bigstrongbeast/GnG_Gantul_hill/Чертежи/Гантуловская гора 20х40х2  27-10-2025 061828.pdf

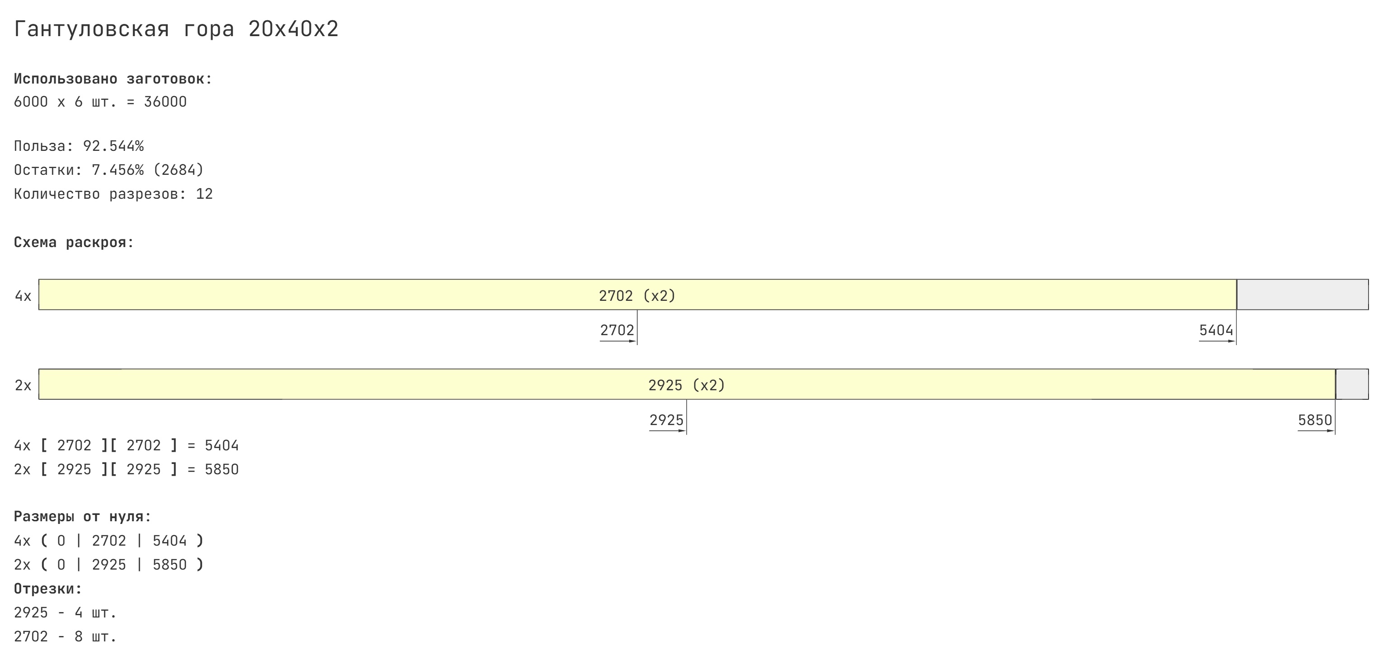
[picture p19: page 1]
