bigstrongbeast/GnG_Gantul_hill/Чертежи/Гантуловская гора 40х40х2 27-10-2025 061539.pdf

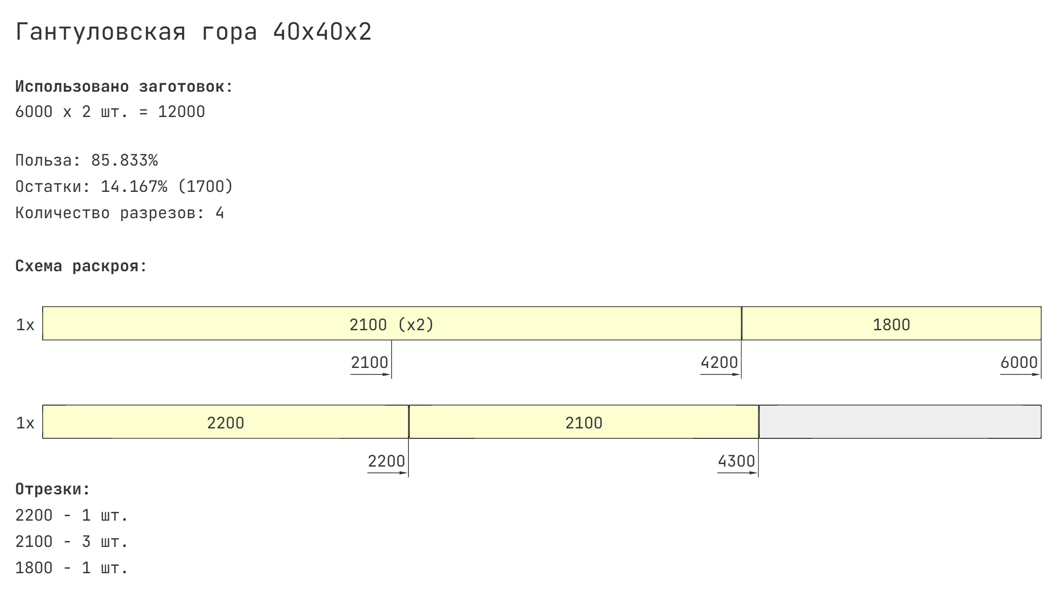
[picture p20: figure]
