bigstrongbeast/GnG_Gantul_hill/Чертежи/Гантуловская гора 80х40х3 27-10-2025 061404.pdf

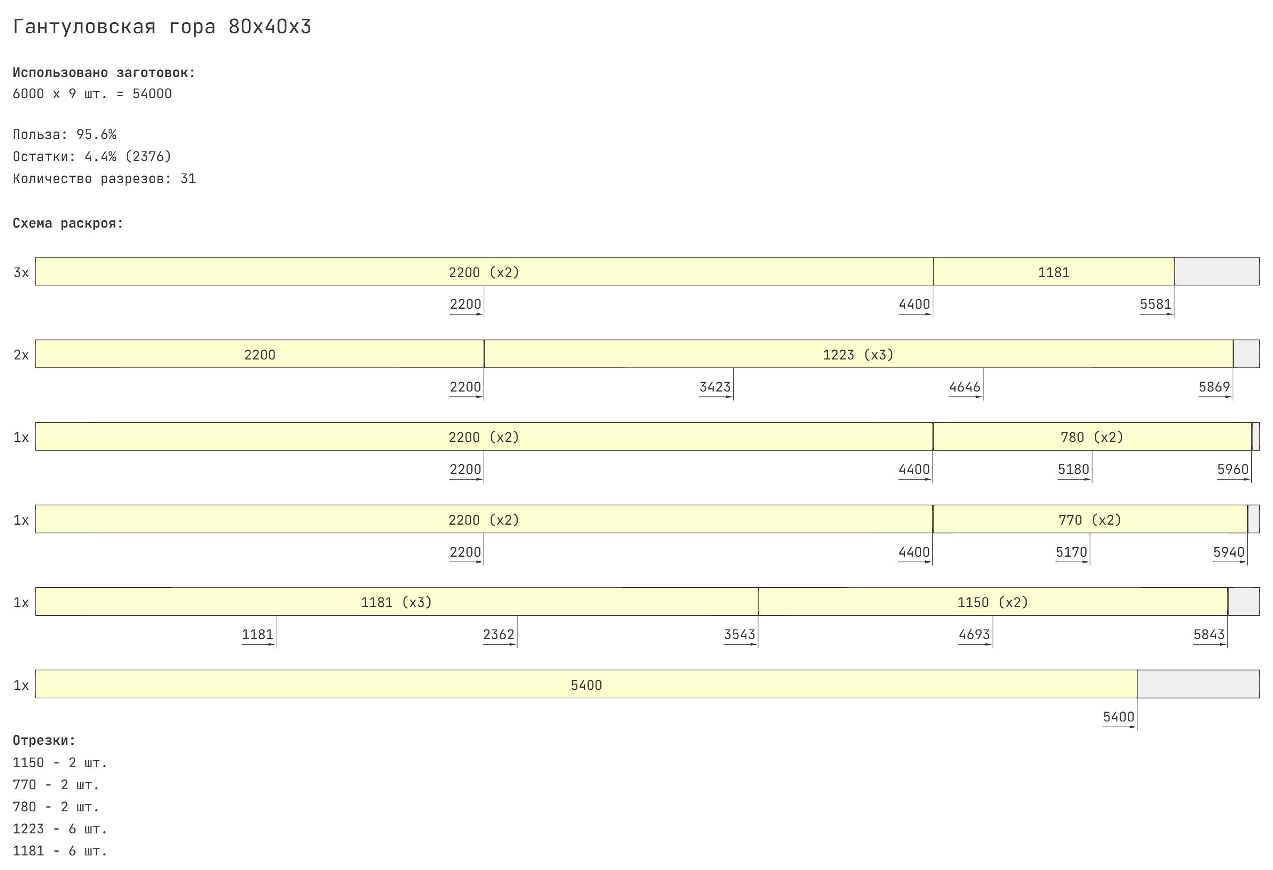
[picture p21: page 1]
