bigstrongbeast/GnG_Gantul_hill/Чертежи/Гантуловская гора 80х80х3 27-10-2025 060937.pdf

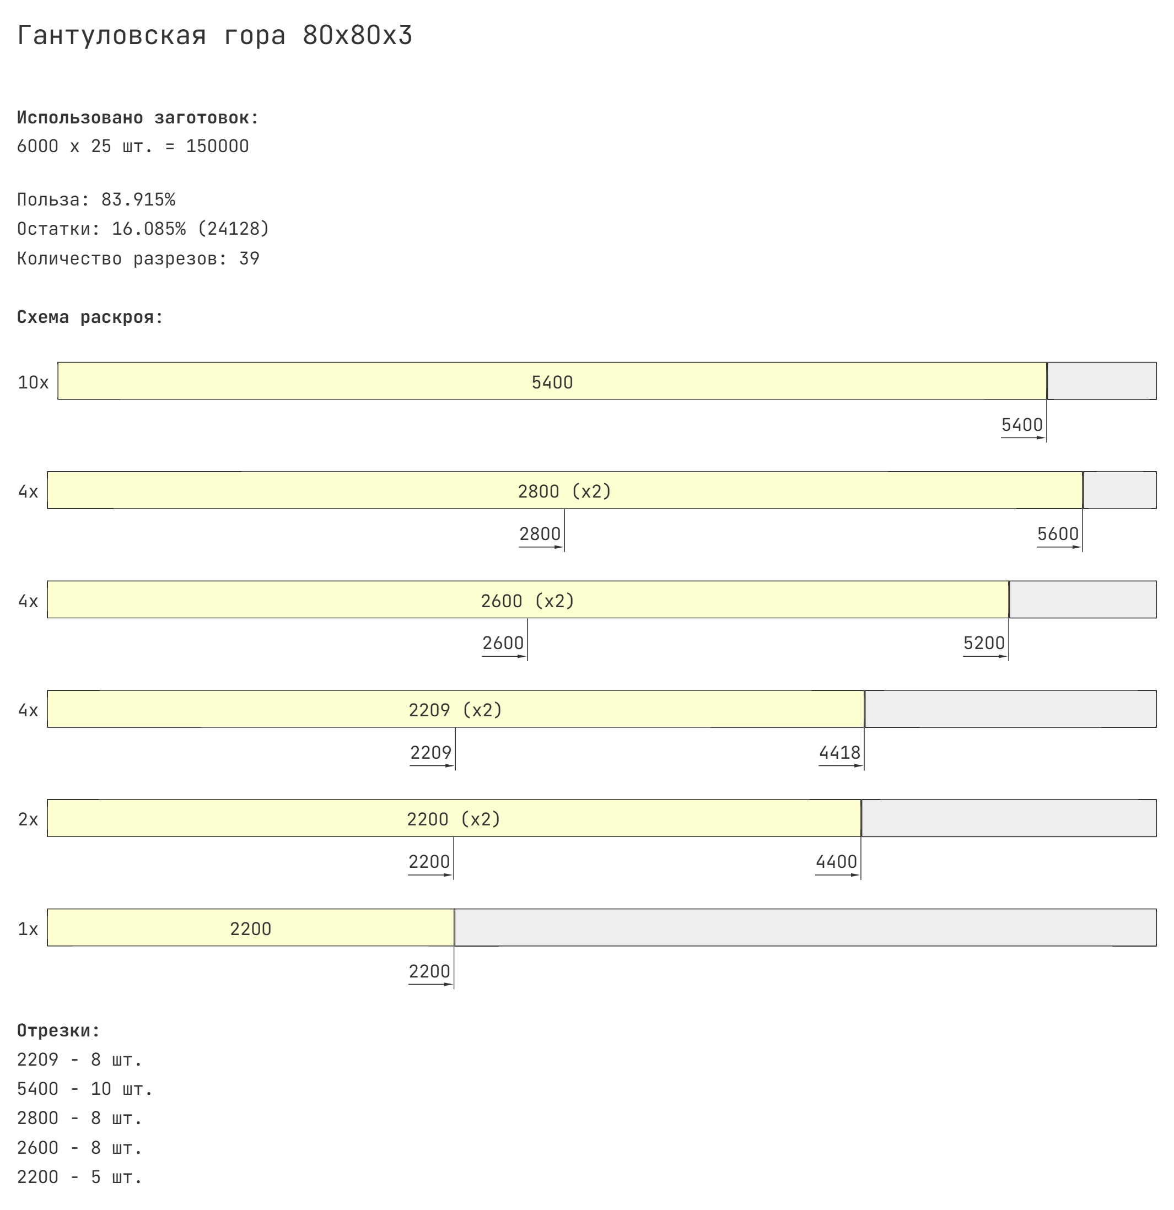
[picture p22: page 1]
