bigstrongbeast/GnG_Gantul_hill/GnG laser/GnG frame 4.2 reinf.dxf

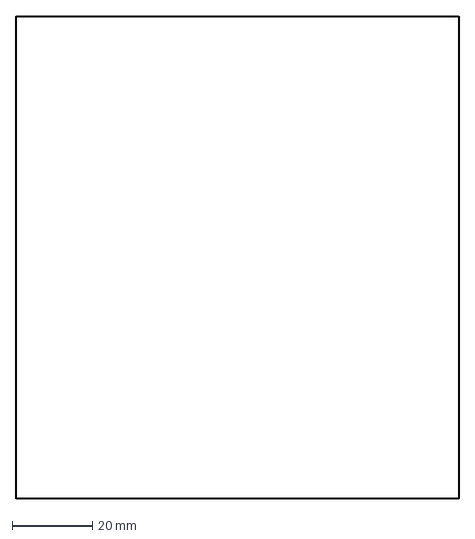
[picture p23: CAD file, 2026-01-20]
GnG laser/GnG frame 4.2 reinf.dxf
110.0 x 120.0 mm
