bigstrongbeast/GnG_Gantul_hill/GnG laser/GnG frame 4.1 D-ring.dxf

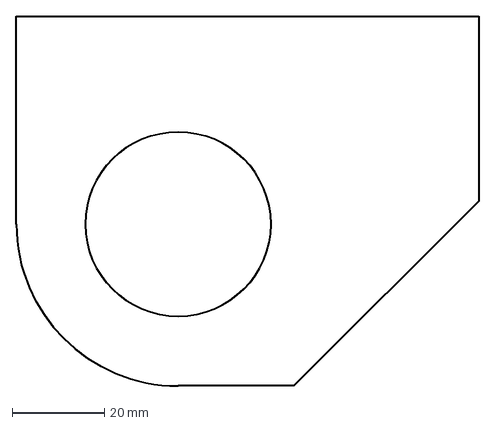
[picture p24: CAD file, 2026-01-20]
GnG laser/GnG frame 4.1 D-ring.dxf
100.0 x 80.0 mm
