bigstrongbeast/GnG_Gantul_hill/GnG laser/GnG frame 2 floor sheet 5.dxf

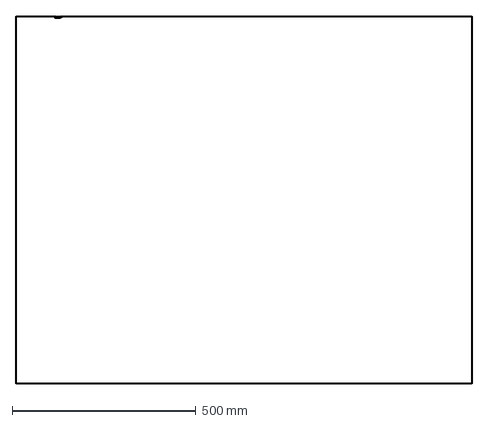
[picture p25: CAD file, 2025-11-07]
GnG laser/GnG frame 2 floor sheet 5.dxf
1240.0 x 1000.0 mm
