bigstrongbeast/GnG_Gantul_hill/GnG laser/GnG frame 2 floor sheet 9.dxf

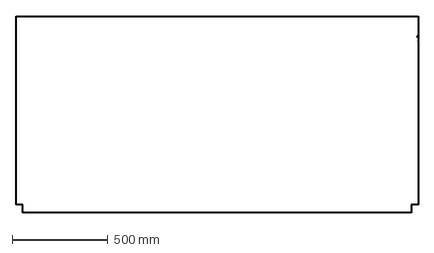
[picture p26: CAD file, 2025-11-07]
GnG laser/GnG frame 2 floor sheet 9.dxf
2100.0 x 1025.0 mm
