bigstrongbeast/GnG_Gantul_hill/GnG laser/GnG frame 2 floor sheet 7.dxf

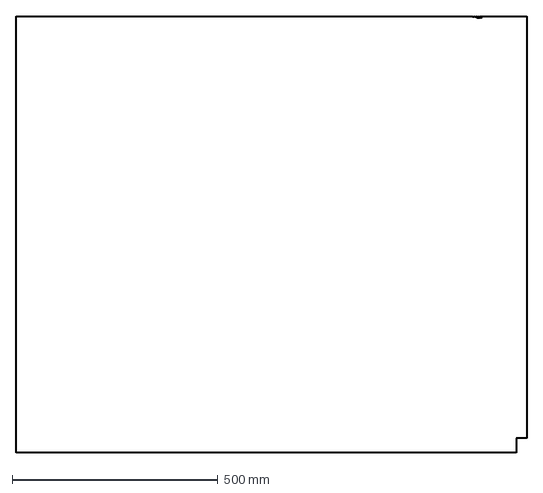
[picture p27: CAD file, 2025-11-07]
GnG laser/GnG frame 2 floor sheet 7.dxf
1240.0 x 1060.0 mm
