bigstrongbeast/GnG_Gantul_hill/GnG laser/GnG frame 2 floor sheet 10.dxf

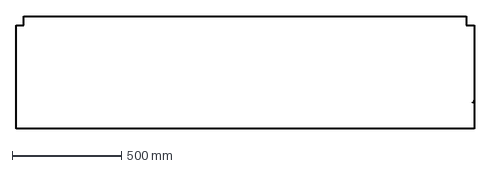
[picture p28: CAD file, 2025-11-07]
GnG laser/GnG frame 2 floor sheet 10.dxf
2100.0 x 515.0 mm
