bigstrongbeast/GnG_Gantul_hill/GnG laser/GnG frame 2 floor sheet 8.dxf

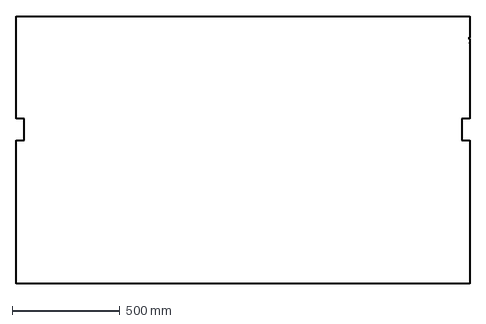
[picture p30: CAD file, 2025-11-07]
GnG laser/GnG frame 2 floor sheet 8.dxf
2100.0 x 1240.0 mm
