bigstrongbeast/GnG_Gantul_hill/GnG laser/GnG frame 1.1 floor sheet 3.dxf

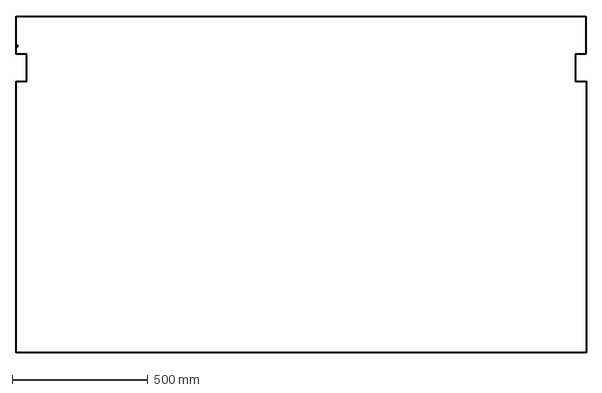
[picture p32: CAD file, 2025-11-06]
GnG laser/GnG frame 1.1 floor sheet 3.dxf
2100.0 x 1240.0 mm
