bigstrongbeast/GnG_Gantul_hill/GnG laser/GnG frame 1.1 floor sheet 5.dxf

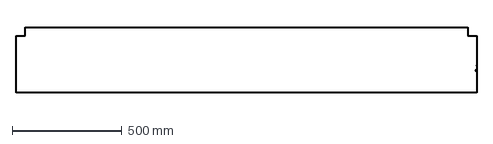
[picture p33: CAD file, 2025-11-06]
GnG laser/GnG frame 1.1 floor sheet 5.dxf
2100.0 x 300.0 mm
