bigstrongbeast/GnG_Gantul_hill/GnG laser/GnG frame 1.1 floor sheet 2.dxf

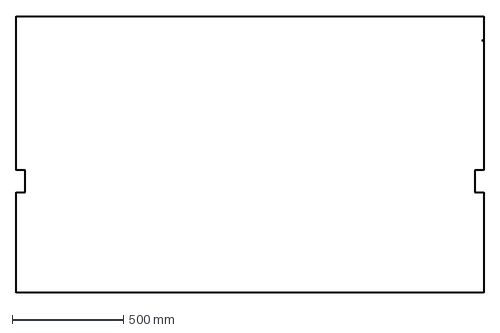
[picture p34: CAD file, 2025-11-06]
GnG laser/GnG frame 1.1 floor sheet 2.dxf
2100.0 x 1240.0 mm
