bigstrongbeast/GnG_Gantul_hill/GnG laser/GnG frame 1.1 floor sheet.dxf

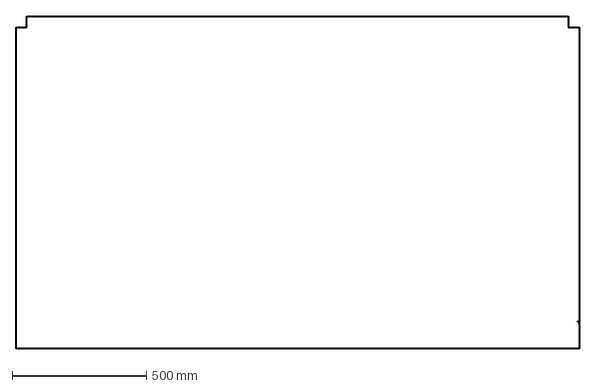
[picture p35: CAD file, 2025-11-06]
GnG laser/GnG frame 1.1 floor sheet.dxf
2100.0 x 1240.0 mm
