bigstrongbeast/GnG_Gantul_hill/(list of files, cad)

Other CAD files:
ref/Стол приёма ГПХ.dwg
Чертежи/DRW GNG Frame_общий.dwg
ref/ТХ_схема Гантуловская гора 18.11.25.dwg
Чертежи/DRW GNG Frame_Рама 1 пол.dwg
ref/Стенды.dwg
Чертежи/DRW GNG Frame_рама_2.dwg
ref/Промежуточный бак.dwg
Чертежи/DRW GNG Frame_рама_3.dwg
ref/Поддон2.dwg
Чертежи/DRW GNG Frame_Рама 1 пол листы.dwg
ref/АСФундамент.dwg
Чертежи/DRW GNG Frame_NDM 4.2 Стрингер домкрат-мама кртк_11.dwg
ref/Рама под насосы.dwg
Чертежи/DRW GNG Frame_торец ворота.dwg
ref/План площадки.dwg
Чертежи/DRW GNG Frame_NDM 4.2 Стрингер домкрат-мама кртк_6.dwg
ref/Разрезы.dwg
Чертежи/DRW GNG Frame_Рама 2 пол.dwg
ref/Граф.часть.dwg
Чертежи/DRW GNG Frame_NDM 4.2 Стрингер домкрат-мама кртк_5.dwg
ref/АС Гатуловской горы.dwg
Чертежи/DRW GNG Frame_Рама 2 пол листы.dwg
ref/Емкость пластик.dwg
ADM10.ipt
AST GnG frame.iam
AST GnG frame/Frame/Frame 1758357581306.iam
AST GnG frame/Frame/ISO 10799-2 100x100x3 1758357583030.ipt
AST GnG frame/Frame/ISO 10799-2 100x100x3 1758357583062.ipt
AST GnG frame/Frame/ISO 10799-2 100x100x3 1758357583095.ipt
AST GnG frame/Frame/ISO 10799-2 100x100x3 1758357583128.ipt
AST GnG frame/Frame/ISO 10799-2 100x100x3 1758357661088.ipt
AST GnG frame/Frame/ISO 10799-2 100x100x3 1760436526769.ipt
AST GnG frame/Frame/Skeleton 1758357581307.ipt
AST GnG frame_Simplify_1.ipt
ASY GnG frame 1.1.iam
ASY GnG frame 1.1/Frame/Frame 1760970953553.iam
ASY GnG frame 1.1/Frame/ISO 10799-2 40x20x2 1760970956320.ipt
ASY GnG frame 1.1/Frame/ISO 10799-2 40x20x2 1760971113347.ipt
ASY GnG frame 1.1/Frame/ISO 10799-2 40x20x2 1761227743922.ipt
ASY GnG frame 1.1/Frame/ISO 10799-2 40x40x2 1762336144290.ipt
ASY GnG frame 1.1/Frame/ISO 10799-2 40x40x2 1762336160774.ipt
ASY GnG frame 1.1/Frame/ISO 10799-2 80x40x3 1760971015255.ipt
ASY GnG frame 1.1/Frame/ISO 10799-2 80x40x3 1760971085509.ipt
ASY GnG frame 1.1/Frame/ISO 10799-2 80x40x3 1760971085542.ipt
ASY GnG frame 1.1/Frame/ISO 10799-2 80x40x3 1760971459705.ipt
ASY GnG frame 1.1/Frame/ISO 10799-2 80x40x3 1760971459737.ipt
ASY GnG frame 1.1/Frame/ISO 10799-2 80x40x3 1760971459769.ipt
ASY GnG frame 1.1/Frame/ISO 10799-2 80x40x3 1760971459801.ipt
ASY GnG frame 1.1/Frame/ISO 10799-2 80x40x3 1760971459834.ipt
ASY GnG frame 1.1/Frame/ISO 10799-2 80x40x3 1760971459866.ipt
ASY GnG frame 1.1/Frame/ISO 10799-2 80x40x3 1761763318402.ipt
ASY GnG frame 1.1/Frame/ISO 10799-2 80x40x3 1761763502600.ipt
ASY GnG frame 1.1/Frame/ISO 10799-2 80x40x3 1761763502641.ipt
ASY GnG frame 1.1/Frame/ISO 10799-2 80x40x3 1761764728104.ipt
ASY GnG frame 1.1/Frame/ISO 10799-2 80x40x3 1761764790187.ipt
ASY GnG frame 1.1/Frame/ISO 10799-2 80x40x3 1761773859418.ipt
ASY GnG frame 1.1/Frame/ISO 10799-2 80x80x3 1760971182147.ipt
ASY GnG frame 1.1/Frame/ISO 10799-2 80x80x3 1760971182176.ipt
ASY GnG frame 1.1/Frame/ISO 10799-2 80x80x3 1760971182205.ipt
ASY GnG frame 1.1/Frame/ISO 10799-2 80x80x3 1760971182233.ipt
ASY GnG frame 1.1/Frame/ISO 10799-2 80x80x3 1760971182263.ipt
ASY GnG frame 1.1/Frame/ISO 10799-2 80x80x3 1761534077124.ipt
ASY GnG frame 1.1/Frame/ISO 10799-2 80x80x3 1761779764411.ipt
ASY GnG frame 1.1/Frame/OldVersions/Frame 1760970953553.0015.iam
ASY GnG frame 1.1/Frame/OldVersions/Frame 1760970953553.0016.iam
ASY GnG frame 1.1/Frame/OldVersions/Frame 1760970953553.0017.iam
ASY GnG frame 1.1/Frame/OldVersions/ISO 10799-2 40x20x2 1760971113347.0007.ipt
ASY GnG frame 1.1/Frame/OldVersions/ISO 10799-2 40x20x2 1760971113347.0008.ipt
ASY GnG frame 1.1/Frame/OldVersions/ISO 10799-2 40x20x2 1760971113347.0009.ipt
ASY GnG frame 1.1/Frame/OldVersions/ISO 10799-2 40x20x2 1761227743922.0006.ipt
ASY GnG frame 1.1/Frame/OldVersions/ISO 10799-2 40x20x2 1761227743922.0007.ipt
ASY GnG frame 1.1/Frame/OldVersions/ISO 10799-2 40x40x2 1762336144290.0001.ipt
ASY GnG frame 1.1/Frame/OldVersions/ISO 10799-2 40x40x2 1762336160774.0001.ipt
ASY GnG frame 1.1/Frame/OldVersions/ISO 10799-2 80x80x3 1760971182147.0005.ipt
ASY GnG frame 1.1/Frame/OldVersions/ISO 10799-2 80x80x3 1760971182147.0006.ipt
ASY GnG frame 1.1/Frame/OldVersions/ISO 10799-2 80x80x3 1760971182147.0007.ipt
ASY GnG frame 1.1/Frame/OldVersions/ISO 10799-2 80x80x3 1760971182233.0005.ipt
ASY GnG frame 1.1/Frame/OldVersions/ISO 10799-2 80x80x3 1760971182233.0006.ipt
ASY GnG frame 1.1/Frame/OldVersions/ISO 10799-2 80x80x3 1760971182233.0007.ipt
ASY GnG frame 1.1/Frame/OldVersions/ISO 10799-2 80x80x3 1760971182263.0005.ipt
ASY GnG frame 1.1/Frame/OldVersions/ISO 10799-2 80x80x3 1760971182263.0006.ipt
ASY GnG frame 1.1/Frame/OldVersions/ISO 10799-2 80x80x3 1760971182263.0007.ipt
ASY GnG frame 1.1/Frame/OldVersions/Skeleton 1760970953554.0015.ipt
ASY GnG frame 1.1/Frame/OldVersions/Skeleton 1760970953554.0016.ipt
ASY GnG frame 1.1/Frame/Skeleton 1760970953554.ipt
ASY GnG frame 1.iam
ASY GnG frame 1/Frame/Frame 1760437627605.iam
ASY GnG frame 1/Frame/ISO 10799-2 100x100x3 1760437628511.ipt
ASY GnG frame 1/Frame/ISO 10799-2 100x100x3 1760437628542.ipt
ASY GnG frame 1/Frame/ISO 10799-2 100x100x3 1760437628572.ipt
ASY GnG frame 1/Frame/ISO 10799-2 100x100x3 1760437628602.ipt
ASY GnG frame 1/Frame/ISO 10799-2 100x100x3 1760437628631.ipt
ASY GnG frame 1/Frame/ISO 10799-2 80x40x3 1760687052574.ipt
ASY GnG frame 1/Frame/ISO 10799-2 80x80x3 1760695196892.ipt
ASY GnG frame 1/Frame/ISO 10799-2 80x80x3 1760695206994.ipt
ASY GnG frame 1/Frame/ISO 10799-2 80x80x3 1760695216389.ipt
ASY GnG frame 1/Frame/ISO 10799-2 80x80x3 1760695230632.ipt
ASY GnG frame 1/Frame/ISO 10799-2 80x80x3 1760869223499.ipt
ASY GnG frame 1/Frame/Skeleton 1760437627606.ipt
ASY GnG frame 2.iam
ASY GnG frame 2/Frame/Frame 1760870485440.iam
ASY GnG frame 2/Frame/ISO 10799-2 40x20x2 1760871003136.ipt
ASY GnG frame 2/Frame/ISO 10799-2 40x20x2 1760871003174.ipt
ASY GnG frame 2/Frame/ISO 10799-2 40x40x2 1760870943673.ipt
ASY GnG frame 2/Frame/ISO 10799-2 40x40x2 1760870950512.ipt
ASY GnG frame 2/Frame/ISO 10799-2 40x40x2 1760870959510.ipt
ASY GnG frame 2/Frame/ISO 10799-2 40x40x2 1760870964721.ipt
ASY GnG frame 2/Frame/ISO 10799-2 40x40x2 1760870971393.ipt
ASY GnG frame 2/Frame/ISO 10799-2 40x40x2 1761689190915.ipt
ASY GnG frame 2/Frame/ISO 10799-2 40x40x2 1762335970766.ipt
ASY GnG frame 2/Frame/ISO 10799-2 40x40x2 1762335989838.ipt
ASY GnG frame 2/Frame/ISO 10799-2 80x40x3 1760870577862.ipt
ASY GnG frame 2/Frame/ISO 10799-2 80x40x3 1760870577894.ipt
ASY GnG frame 2/Frame/ISO 10799-2 80x40x3 1760870585760.ipt
ASY GnG frame 2/Frame/ISO 10799-2 80x40x3 1761227968002.ipt
ASY GnG frame 2/Frame/ISO 10799-2 80x40x3 1761228074502.ipt
ASY GnG frame 2/Frame/ISO 10799-2 80x40x3 1761228074535.ipt
ASY GnG frame 2/Frame/ISO 10799-2 80x40x3 1761686068794.ipt
ASY GnG frame 2/Frame/ISO 10799-2 80x40x3 1761688287802.ipt
ASY GnG frame 2/Frame/ISO 10799-2 80x40x3 1761688287836.ipt
ASY GnG frame 2/Frame/ISO 10799-2 80x40x3 1761689128729.ipt
ASY GnG frame 2/Frame/ISO 10799-2 80x40x3 1761689143748.ipt
ASY GnG frame 2/Frame/ISO 10799-2 80x40x3 1761689156544.ipt
ASY GnG frame 2/Frame/ISO 10799-2 80x80x3 1760870486823.ipt
ASY GnG frame 2/Frame/ISO 10799-2 80x80x3 1760870496562.ipt
ASY GnG frame 2/Frame/ISO 10799-2 80x80x3 1760870502167.ipt
ASY GnG frame 2/Frame/ISO 10799-2 80x80x3 1760870514790.ipt
ASY GnG frame 2/Frame/ISO 10799-2 80x80x3 1760870526395.ipt
ASY GnG frame 2/Frame/ISO 10799-2 80x80x3 1761777758167.ipt
ASY GnG frame 2/Frame/OldVersions/Frame 1760870485440.0016.iam
ASY GnG frame 2/Frame/OldVersions/Frame 1760870485440.0017.iam
ASY GnG frame 2/Frame/OldVersions/Frame 1760870485440.0018.iam
ASY GnG frame 2/Frame/OldVersions/ISO 10799-2 40x20x2 1760871003136.0012.ipt
ASY GnG frame 2/Frame/OldVersions/ISO 10799-2 40x20x2 1760871003136.0013.ipt
ASY GnG frame 2/Frame/OldVersions/ISO 10799-2 40x20x2 1760871003174.0006.ipt
ASY GnG frame 2/Frame/OldVersions/ISO 10799-2 40x20x2 1760871003174.0007.ipt
ASY GnG frame 2/Frame/OldVersions/ISO 10799-2 40x40x2 1762335970766.0001.ipt
ASY GnG frame 2/Frame/OldVersions/ISO 10799-2 40x40x2 1762335989838.0001.ipt
ASY GnG frame 2/Frame/OldVersions/ISO 10799-2 80x40x3 1761228074502.0003.ipt
ASY GnG frame 2/Frame/OldVersions/ISO 10799-2 80x40x3 1761228074535.0004.ipt
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
