bigstrongbeast/GnG_Gantul_hill/GnG Revit/ASY GnG frame 1.1.pdf

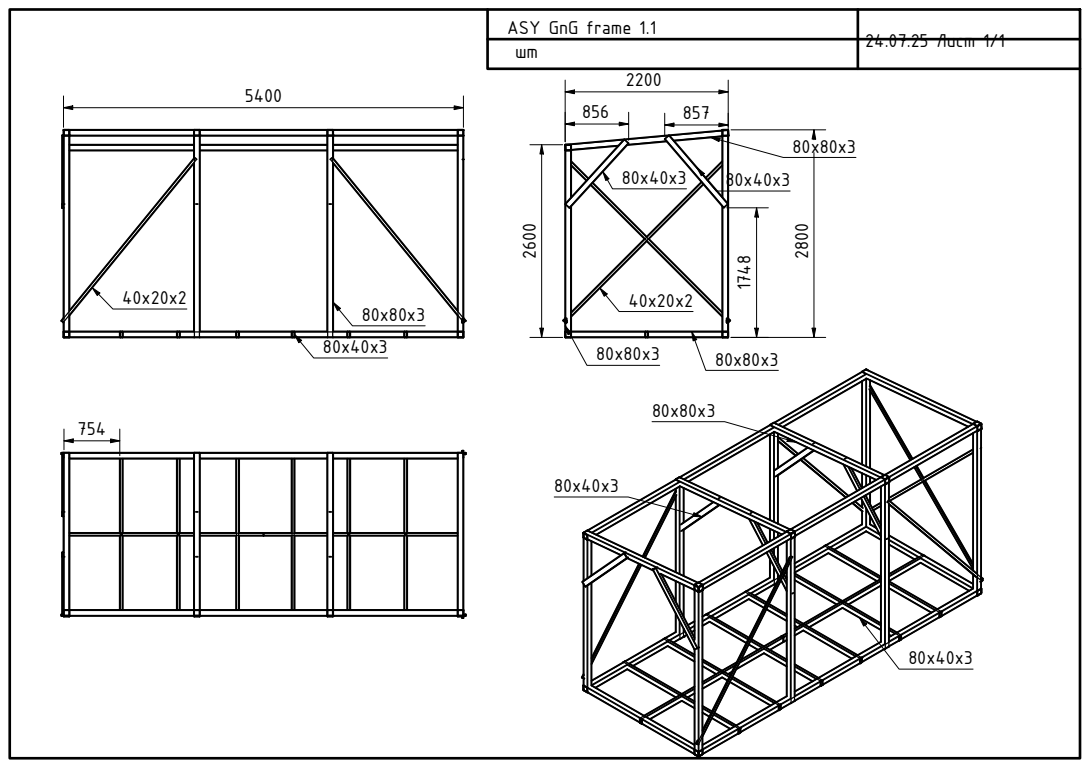
[picture p36: page 1]

ASY GnG frame 1.1 | 24.07.25 Лист 1/1
шт
