bigstrongbeast/GnG_Gantul_hill/ref/Чертеж стола приема ГПХ11.pdf

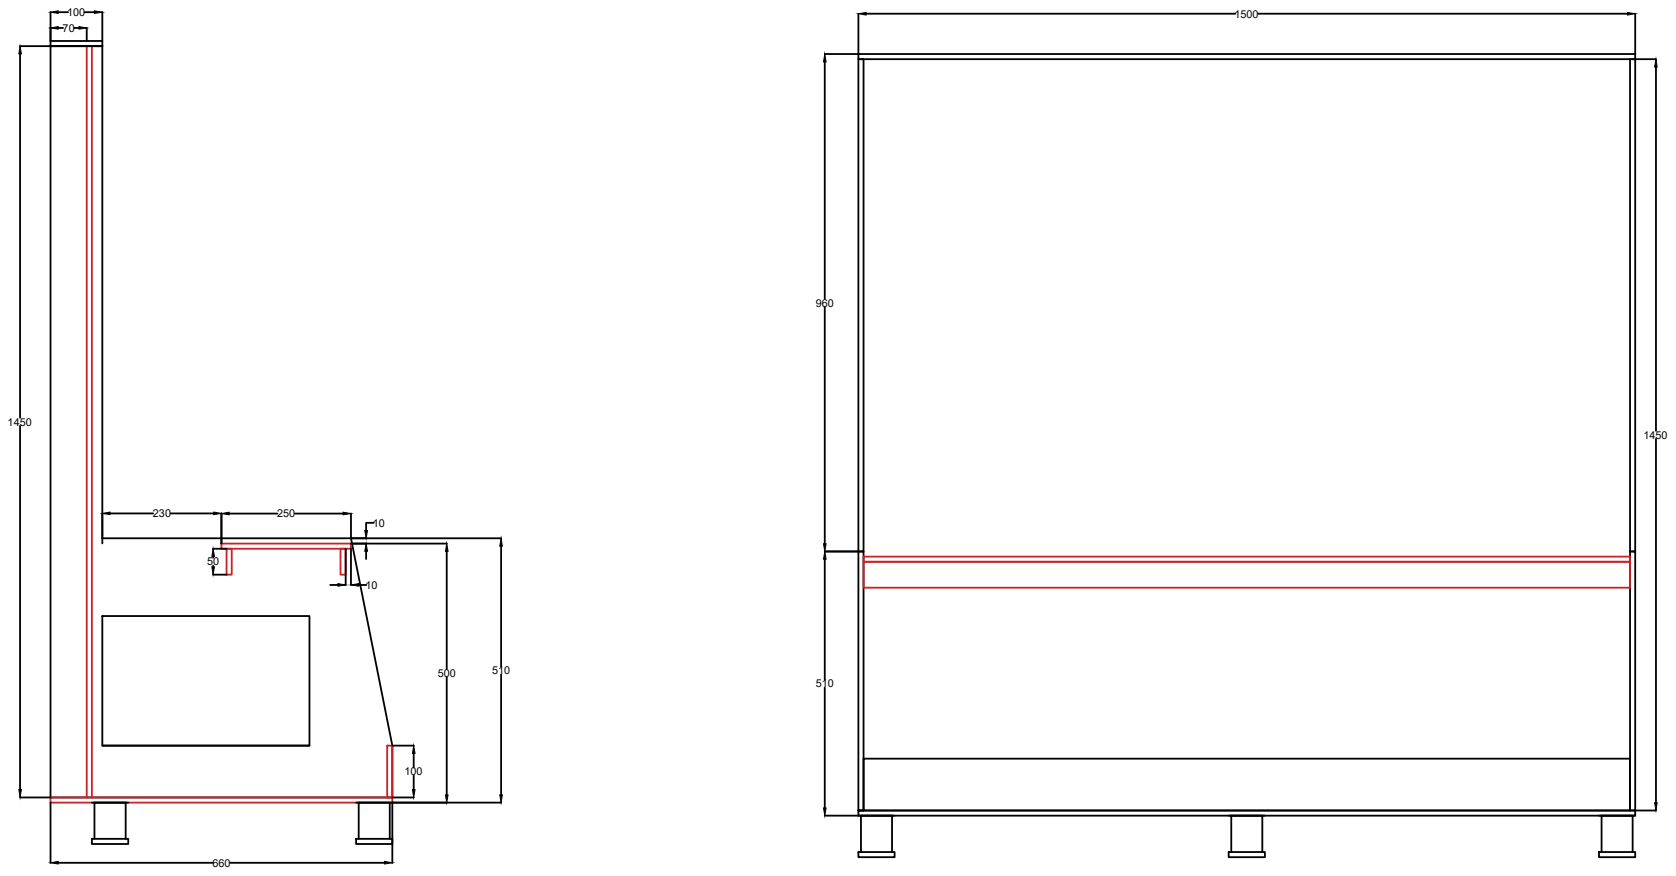
[picture p37: page 1]
