bigstrongbeast/GnG_Gantul_hill/ref/ТХ_схема Гантуловская гора 12.11.25.pdf

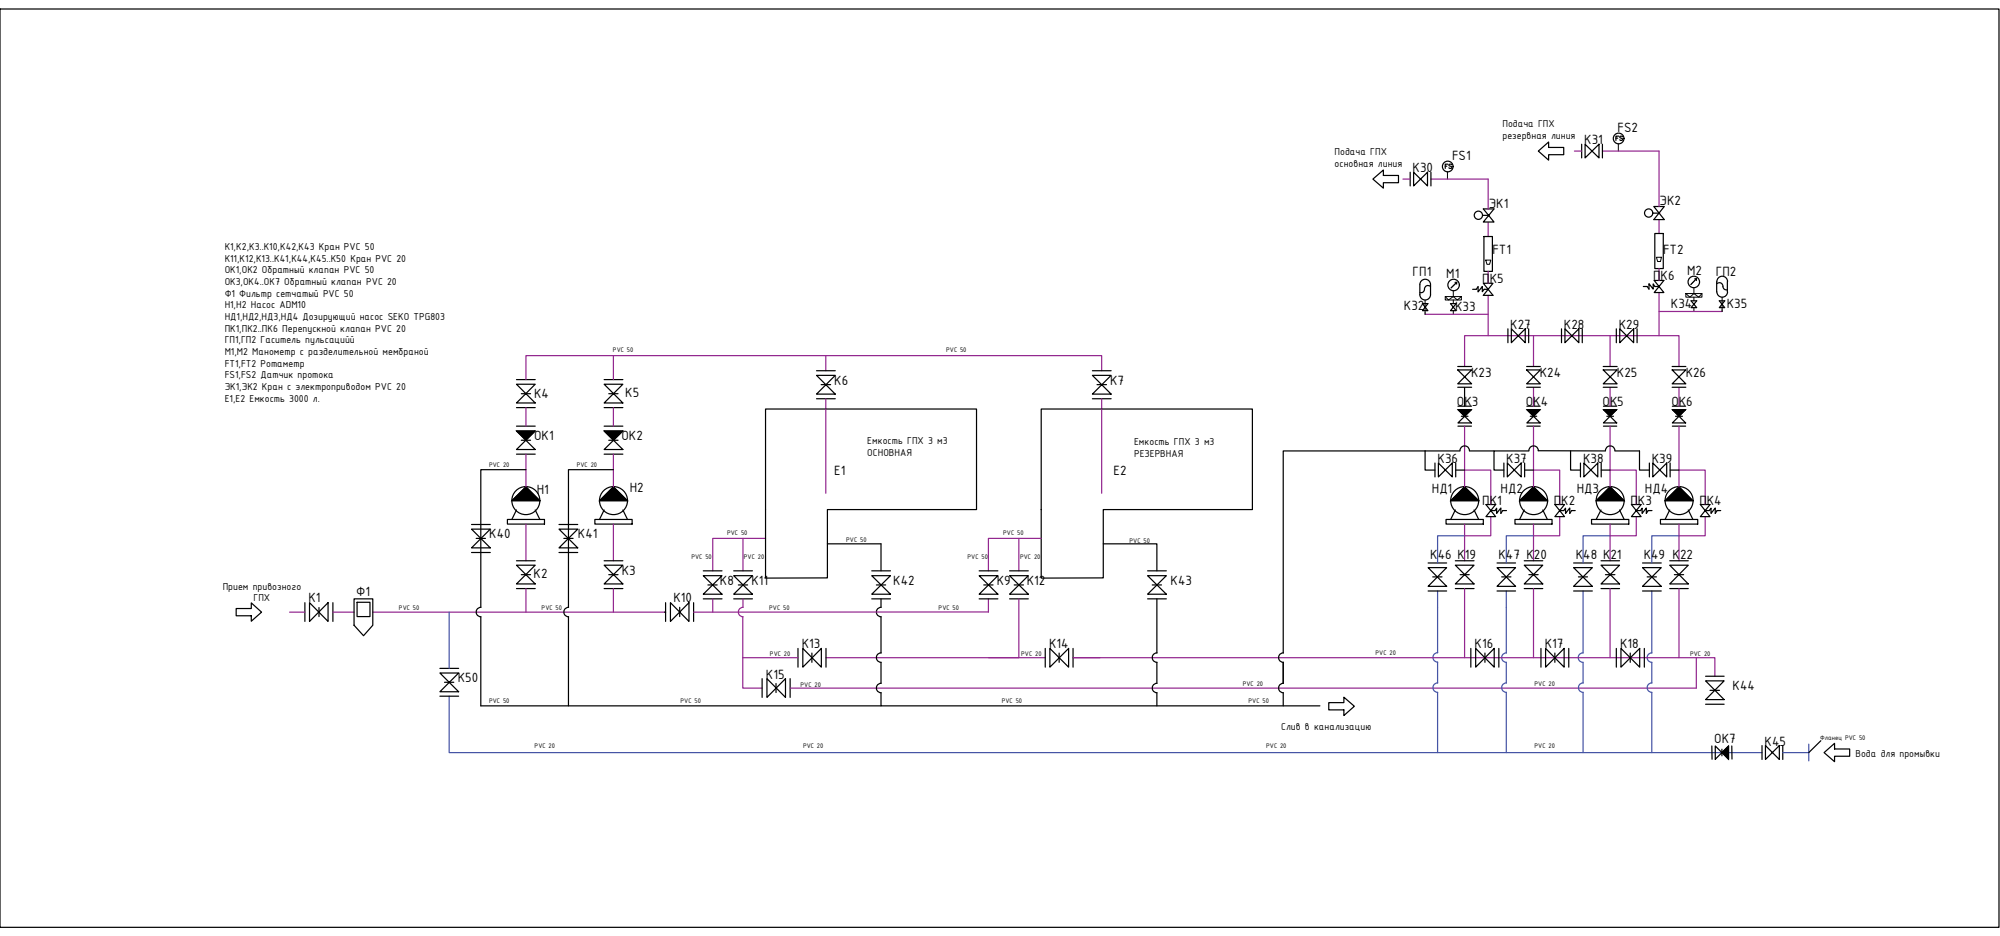
[picture p38: page 1]
Слив в канализацию; PVC 50; PVC 20; Фланец PVC 50; Прием привозного; Подача ГПХ основная линия; Подача ГПХ резервная линия

К1,К2,К3..К10,К42,К43 Кран PVC 50 К11,К12,К13..К41,К44,К45..К50 Кран PVC 20 ОК1,ОК2 Обратный клапан PVC 50 ОК3,ОК4..ОК7 Обратный клапан PVC 20 Ф1 Фильтр сетчатый PVC 50 Н1,Н2 Насос ADM10 НД1,НД2,НД3,НД4 Дозирующий насос SEKO TPG803 ПК1,ПК2..ПК6 Перепускной клапан PVC 20

ГП1,ГП2 Гаситель пульсацийй М1,М2 Манометр с разделительной мембраной

FT1,FT2 Ротаметр
FS1,FS2 Датчик протока
ЭК1,ЭК2 Кран с электроприводом PVC 20
Е1,Е2 Емкость 3000 л.

Емкость ГПХ 3 м3 ОСНОВНАЯ

Емкость ГПХ 3 м3 РЕЗЕРВНАЯ

Вода для промывки
