bigstrongbeast/GnG_Gantul_hill/Чертежи/Гантуловская гора ПЛИТА 11.11.25 13-41.pdf

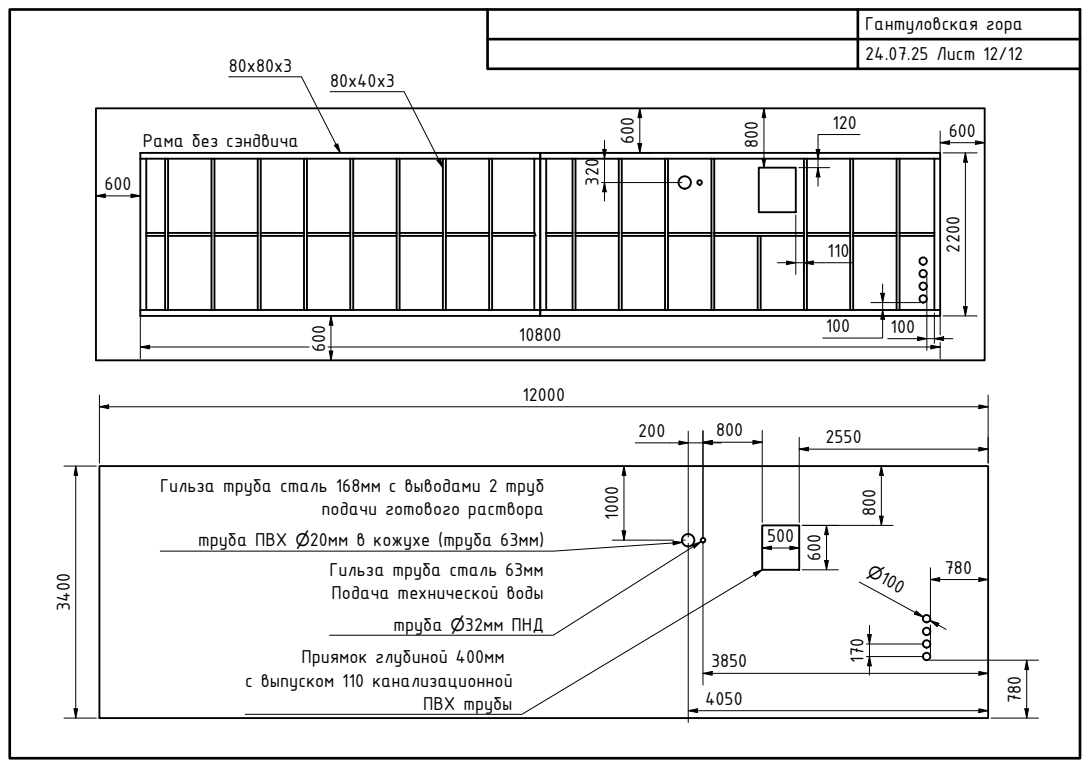
[picture p39: page 1]
Приямок глубиной 400мм с выпуском 110 канализационной ПВХ трубы; труба ⌀32мм ПНД

Гантуловская гора
24.07.25 Лист 12/12

Рама без сэндвича

Гильза труба сталь 168мм с выводами 2 труб

подачи готового раствора

труба ПВХ ⌀20мм в кожухе (труба 63мм)

Гильза труба сталь 63мм
Подача технической воды
