bigstrongbeast/GnG_Gantul_hill/Чертежи/Рама Гантуловская гора 06.11.25.pdf

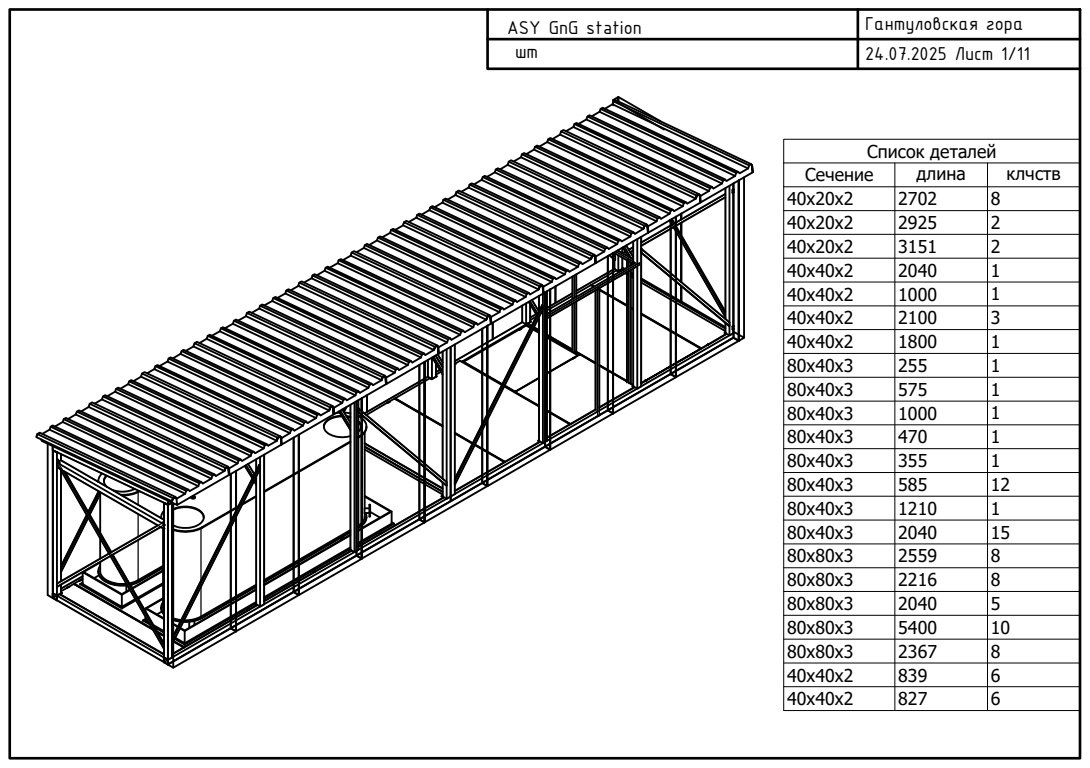
[picture p40: page 1]
Список деталей

ASY GnG station | Гантуловская гора
шт | 24.07.2025 Лист 1/11

Сечение | длина | клчств
40x20x2 | 2702 | 8
40x20x2 | 2925 | 2
40x20x2 | 3151 | 2
40x40x2 | 2040 | 1
40x40x2 | 1000 | 1
40x40x2 | 2100 | 3
40x40x2 | 1800 | 1
80x40x3 | 255 | 1
80x40x3 | 575 | 1
80x40x3 | 1000 | 1
80x40x3 | 470 | 1
80x40x3 | 355 | 1
80x40x3 | 585 | 12
80x40x3 | 1210 | 1
80x40x3 | 2040 | 15
80x80x3 | 2559 | 8
80x80x3 | 2216 | 8
80x80x3 | 2040 | 5
80x80x3 | 5400 | 10
80x80x3 | 2367 | 8
40x40x2 | 839 | 6
40x40x2 | 827 | 6

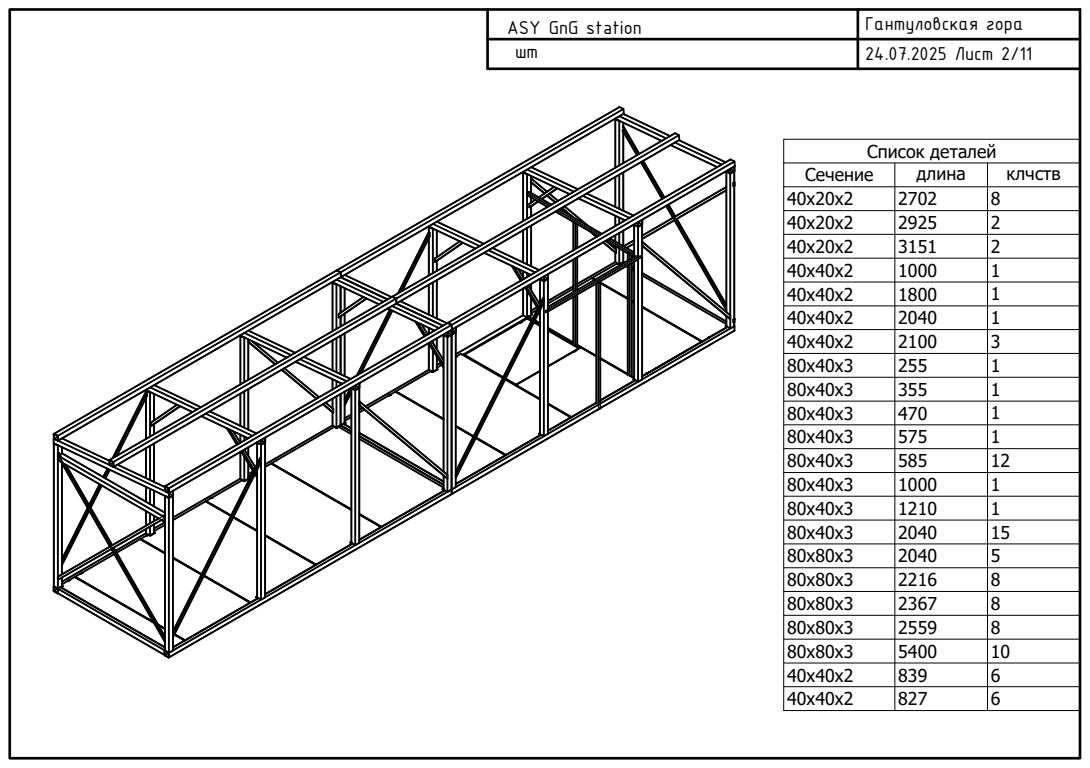
[picture p41: page 2]
Список деталей

ASY GnG station
шт

Сечение | длина | клчств
40x20x2 | 2702 | 8
40x20x2 | 2925 | 2
40x20x2 | 3151 | 2
40x40x2 | 1000 | 1
40x40x2 | 1800 | 1
40x40x2 | 2040 | 1
40x40x2 | 2100 | 3
80x40x3 | 255 | 1
80x40x3 | 355 | 1
80x40x3 | 470 | 1
80x40x3 | 575 | 1
80x40x3 | 585 | 12
80x40x3 | 1000 | 1
80x40x3 | 1210 | 1
80x40x3 | 2040 | 15
80x80x3 | 2040 | 5
80x80x3 | 2216 | 8
80x80x3 | 2367 | 8
80x80x3 | 2559 | 8
80x80x3 | 5400 | 10
40x40x2 | 839 | 6
40x40x2 | 827 | 6

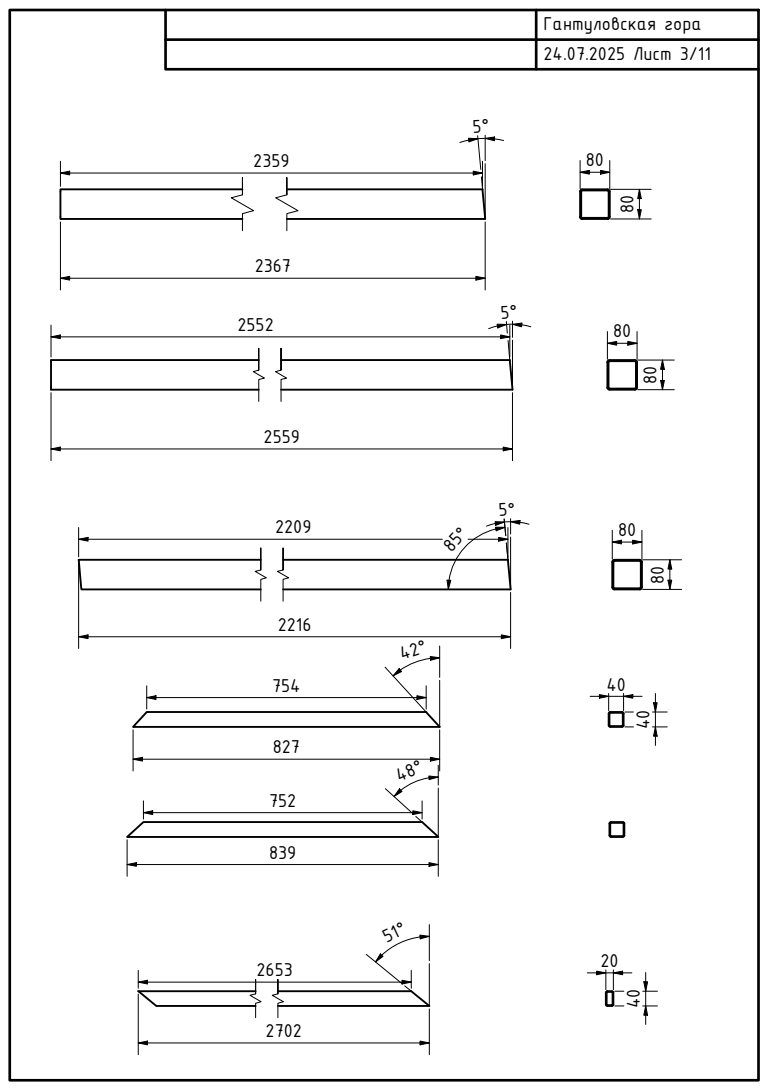
[picture p42: page 3]

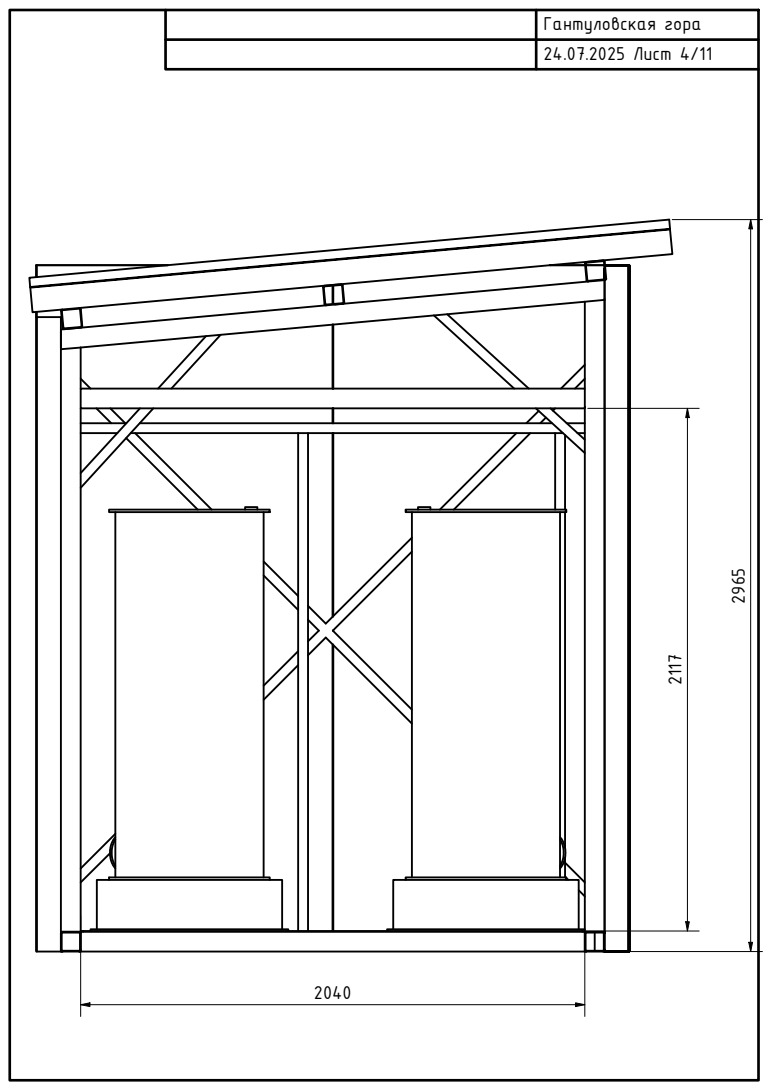
[picture p43: page 4]

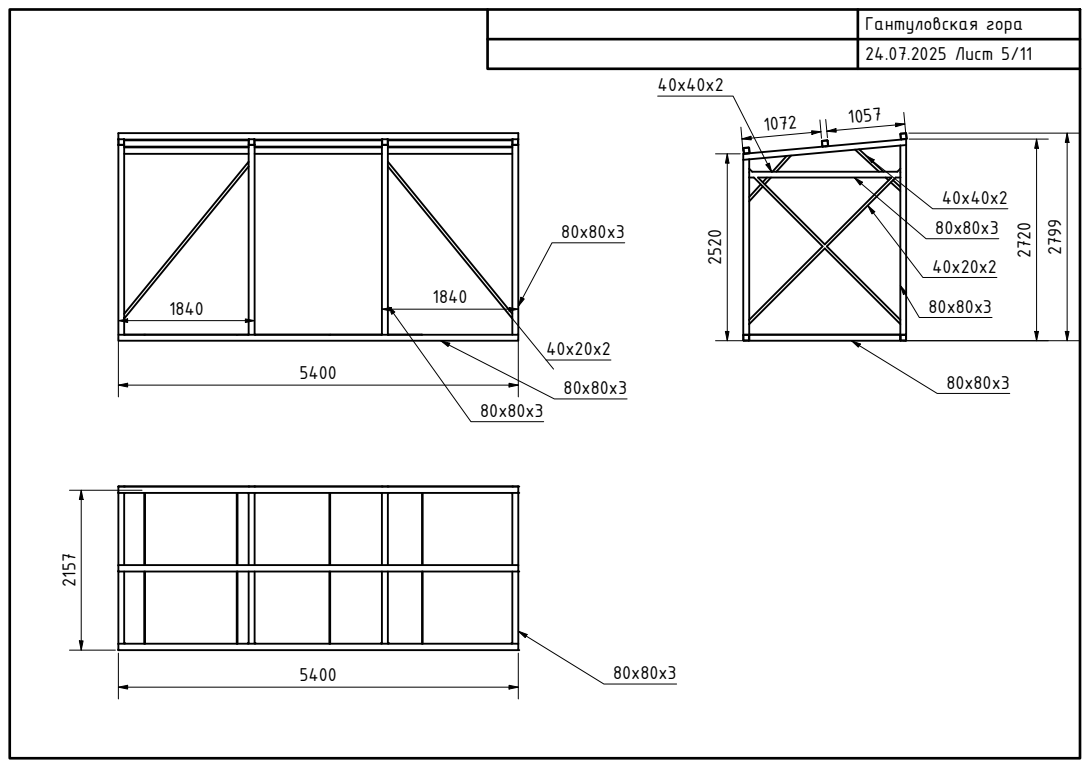
[picture p44: page 5]

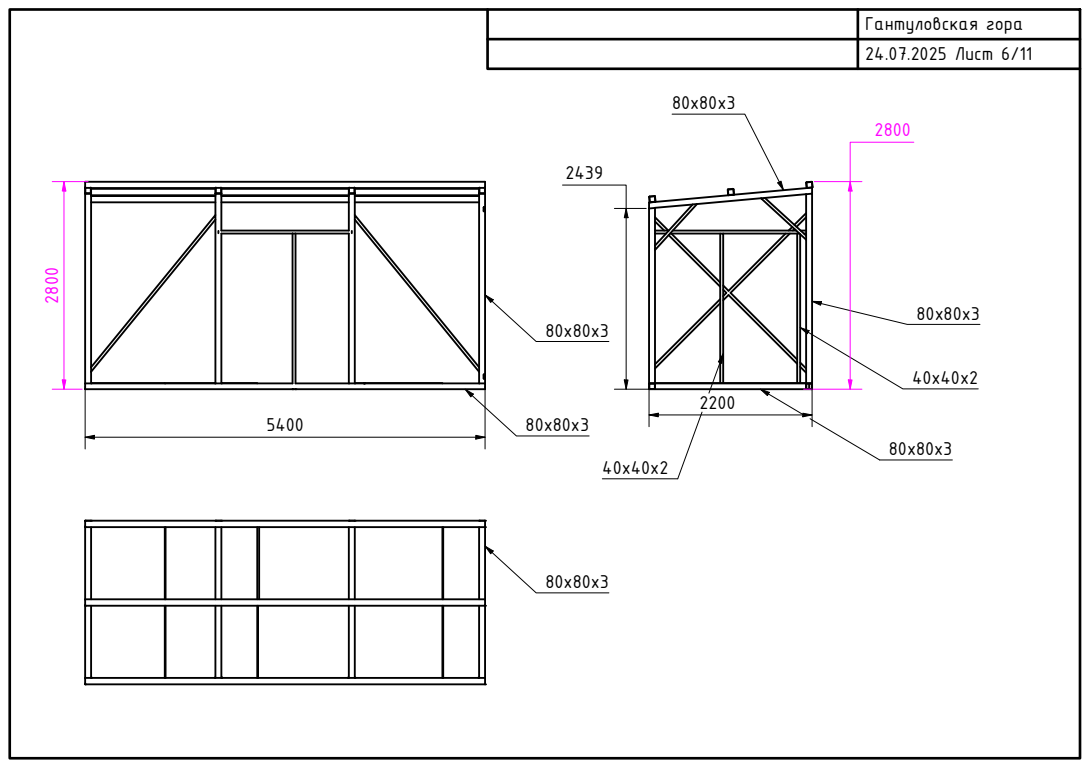
[picture p45: page 6]

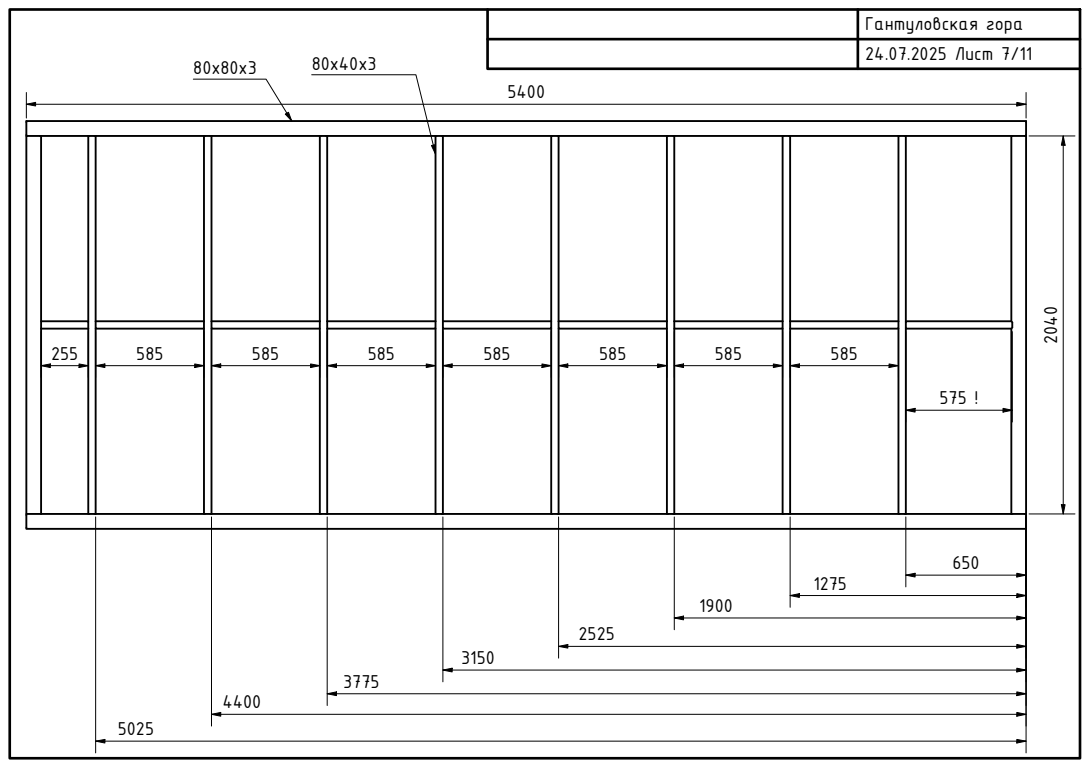
[picture p46: page 7]

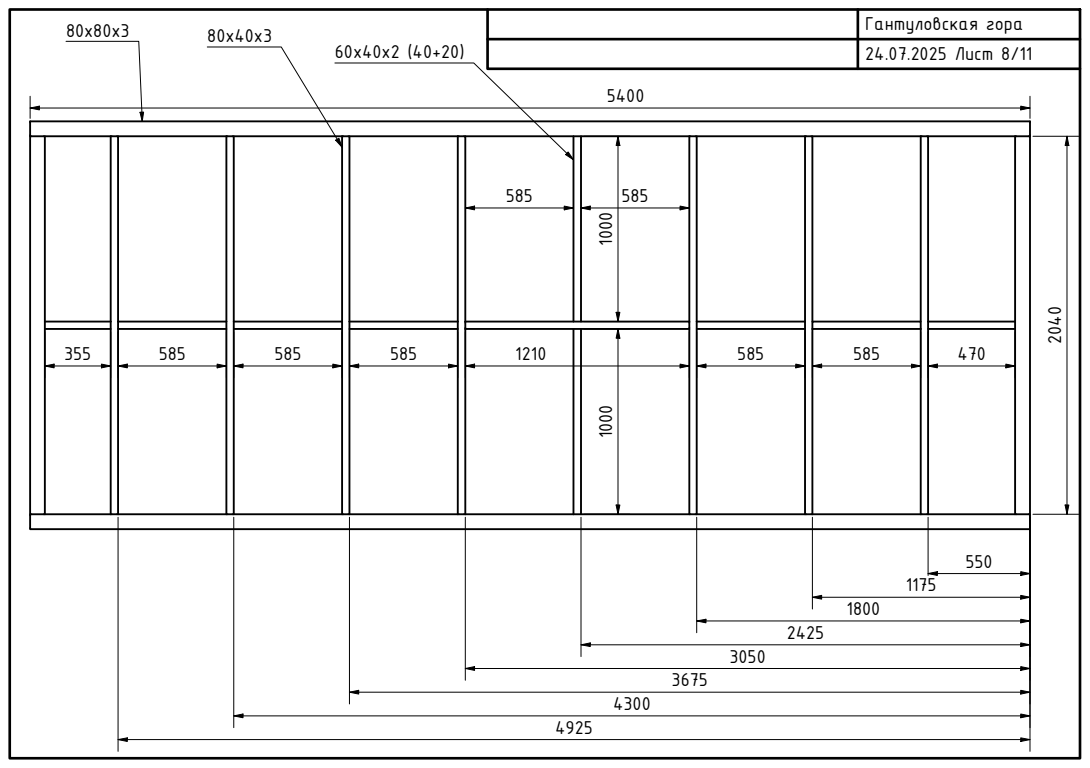
[picture p47: page 8]

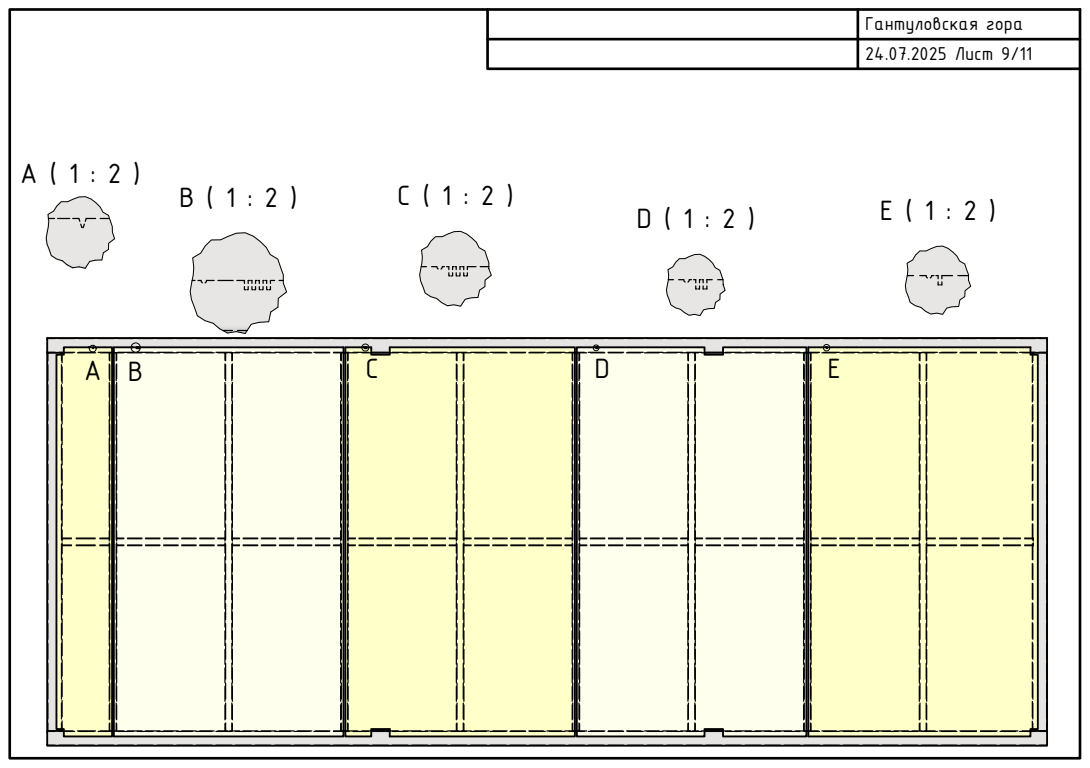
[picture p48: page 9]

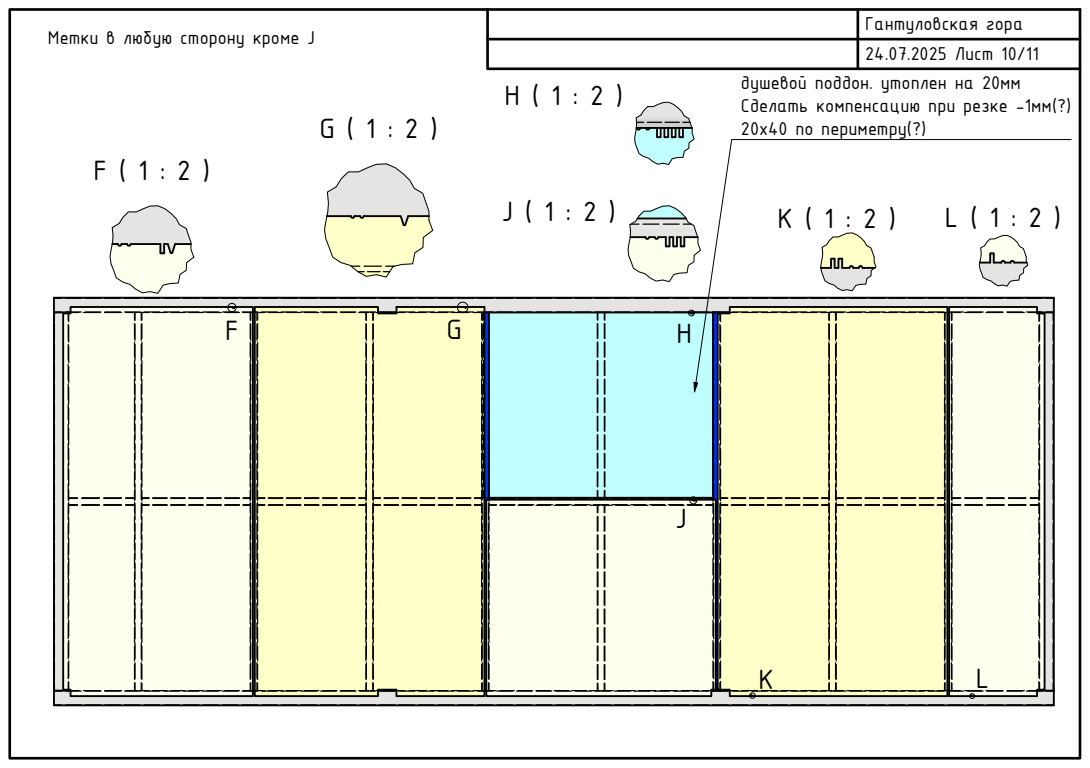
[picture p49: page 10]

Метки в любую сторону кроме J

душевой поддон. утоплен на 20мм
Сделать компенсацию при резке -1мм(?)
20х40 по периметру(?)

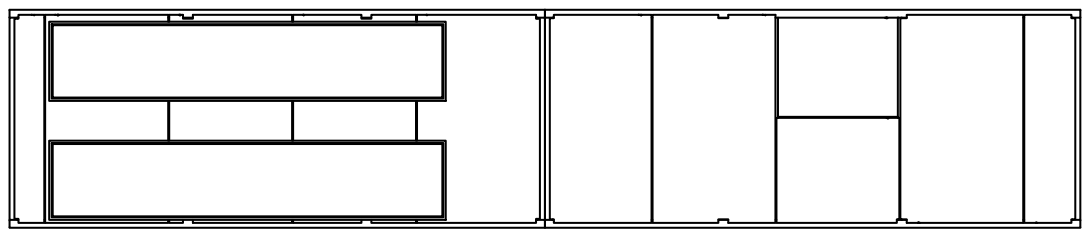
[picture p50: page 11]
