bigstrongbeast/GnG_Gantul_hill/Чертежи/Рама Гантуловская гора 30.10.25.pdf

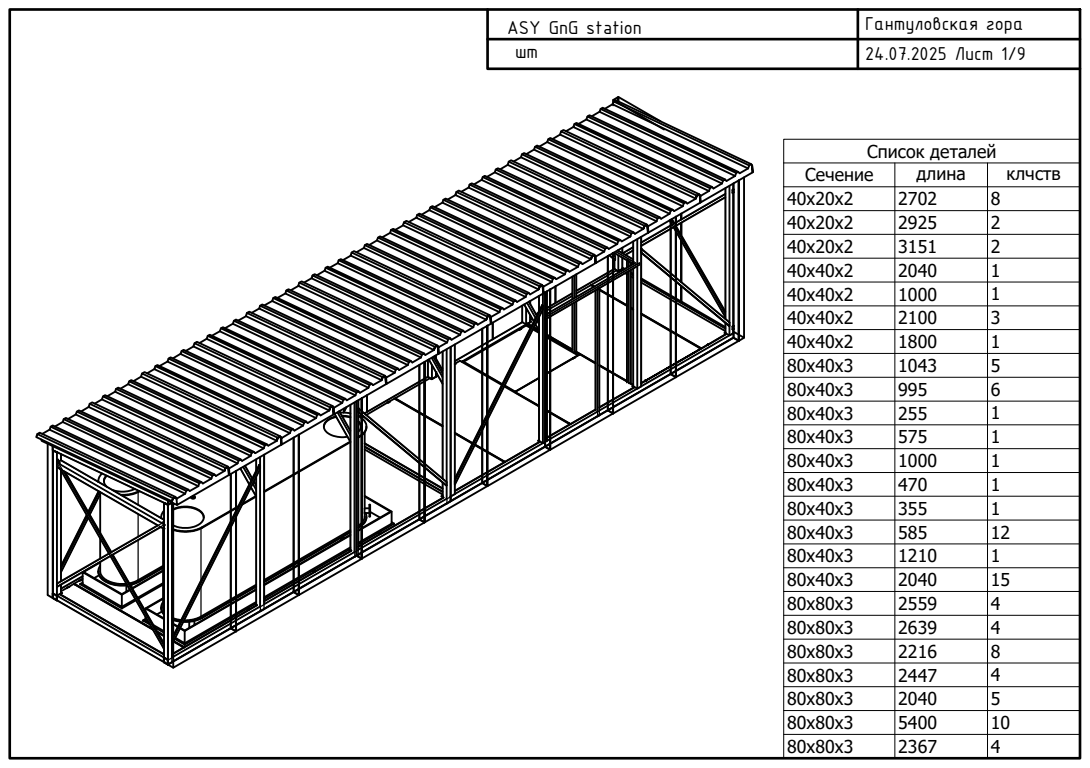
[picture p51: page 1]
Список деталей

ASY GnG station | Гантуловская гора
шт | 24.07.2025 Лист 1/9

Сечение | длина | клчств
40x20x2 | 2702 | 8
40x20x2 | 2925 | 2
40x20x2 | 3151 | 2
40x40x2 | 2040 | 1
40x40x2 | 1000 | 1
40x40x2 | 2100 | 3
40x40x2 | 1800 | 1
80x40x3 | 1043 | 5
80x40x3 | 995 | 6
80x40x3 | 255 | 1
80x40x3 | 575 | 1
80x40x3 | 1000 | 1
80x40x3 | 470 | 1
80x40x3 | 355 | 1
80x40x3 | 585 | 12
80x40x3 | 1210 | 1
80x40x3 | 2040 | 15
80x80x3 | 2559 | 4
80x80x3 | 2639 | 4
80x80x3 | 2216 | 8
80x80x3 | 2447 | 4
80x80x3 | 2040 | 5
80x80x3 | 5400 | 10
80x80x3 | 2367 | 4

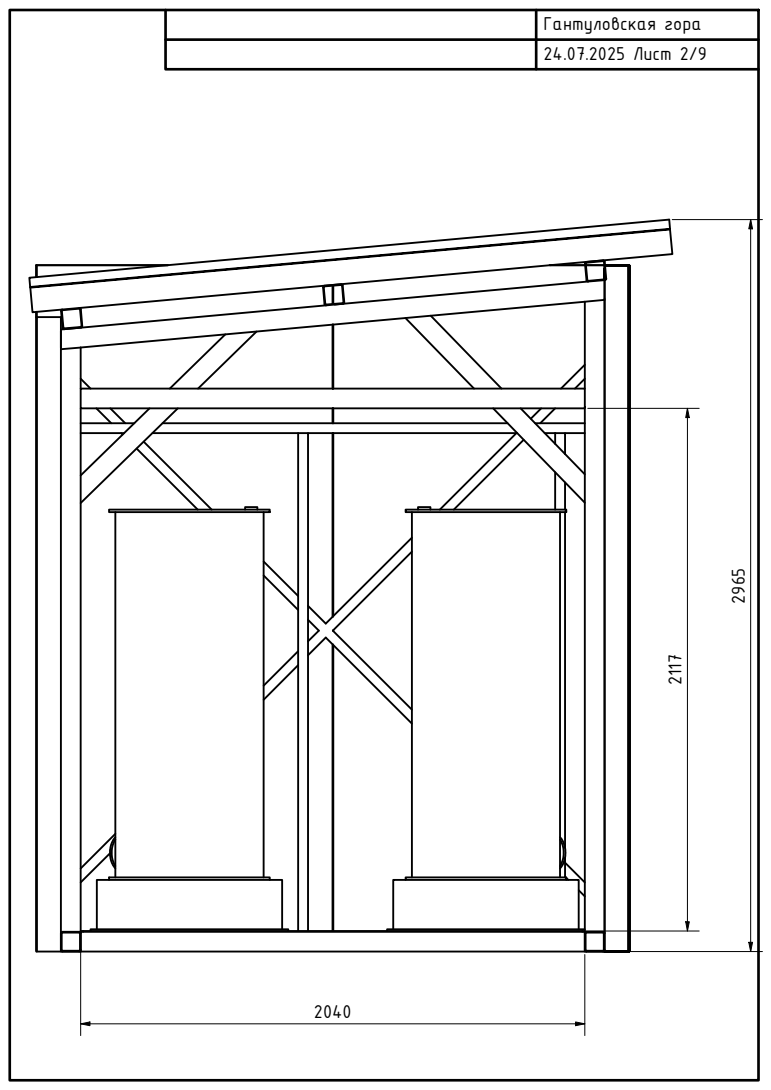
[picture p52: page 2]

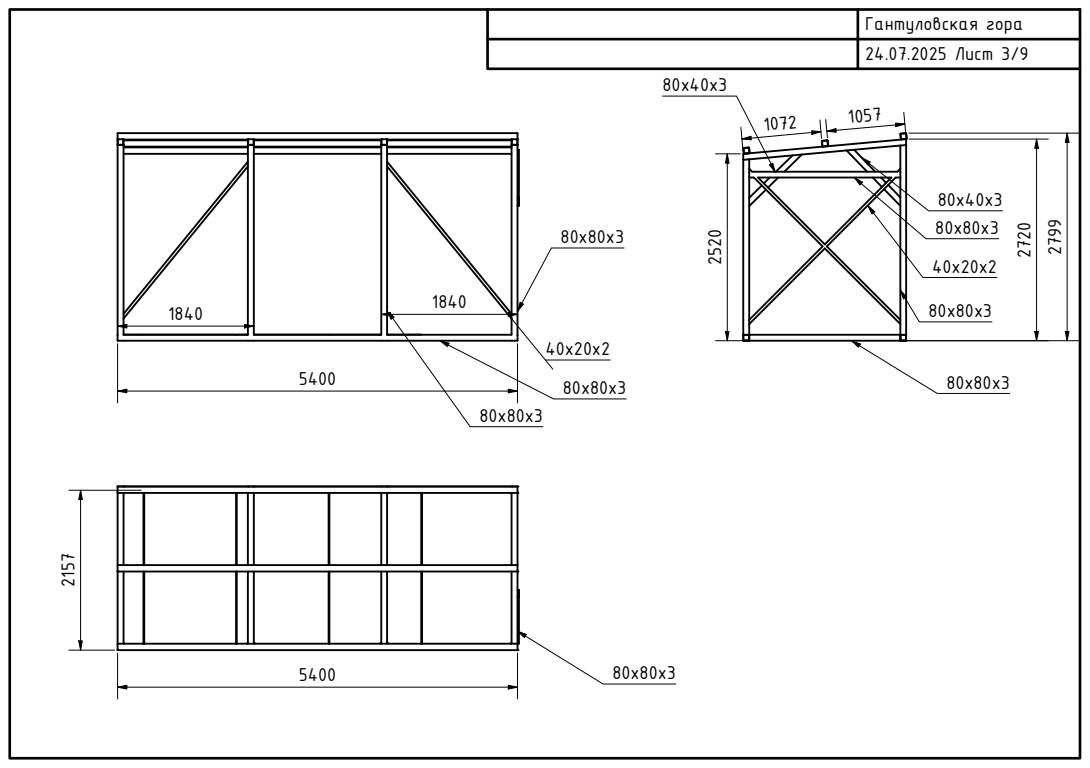
[picture p53: page 3]

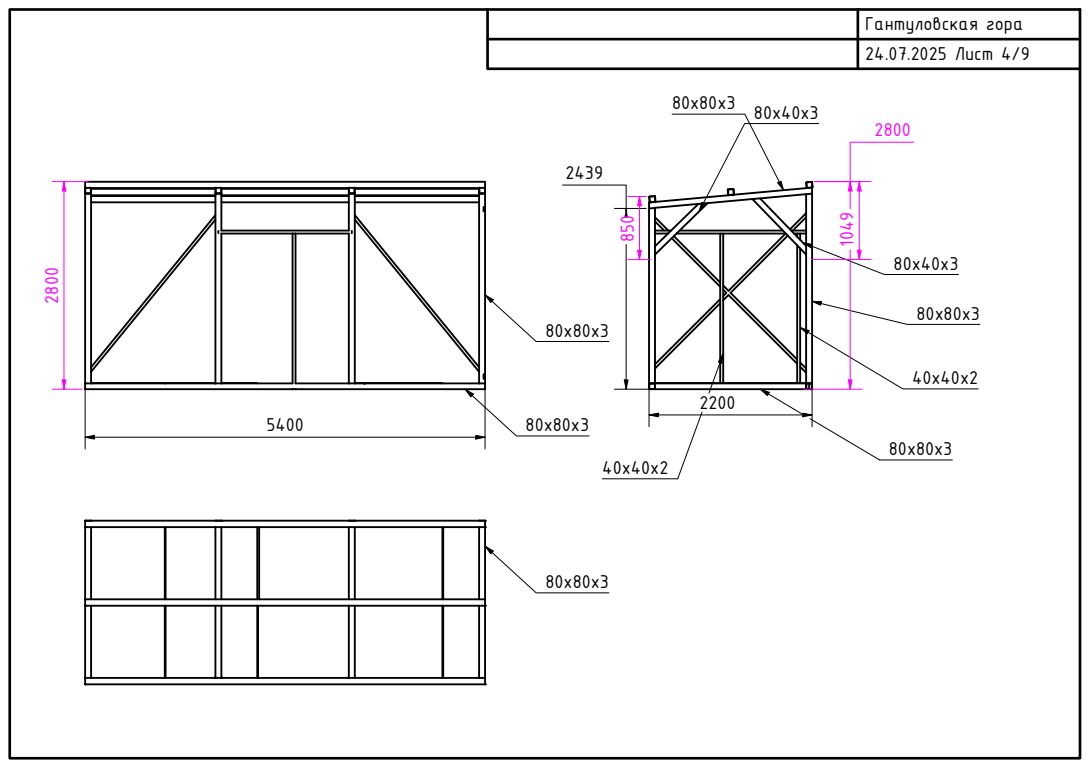
[picture p54: page 4]

Г а н т у л о в с к а я г о р а
4.0 7.2 Л и с т /

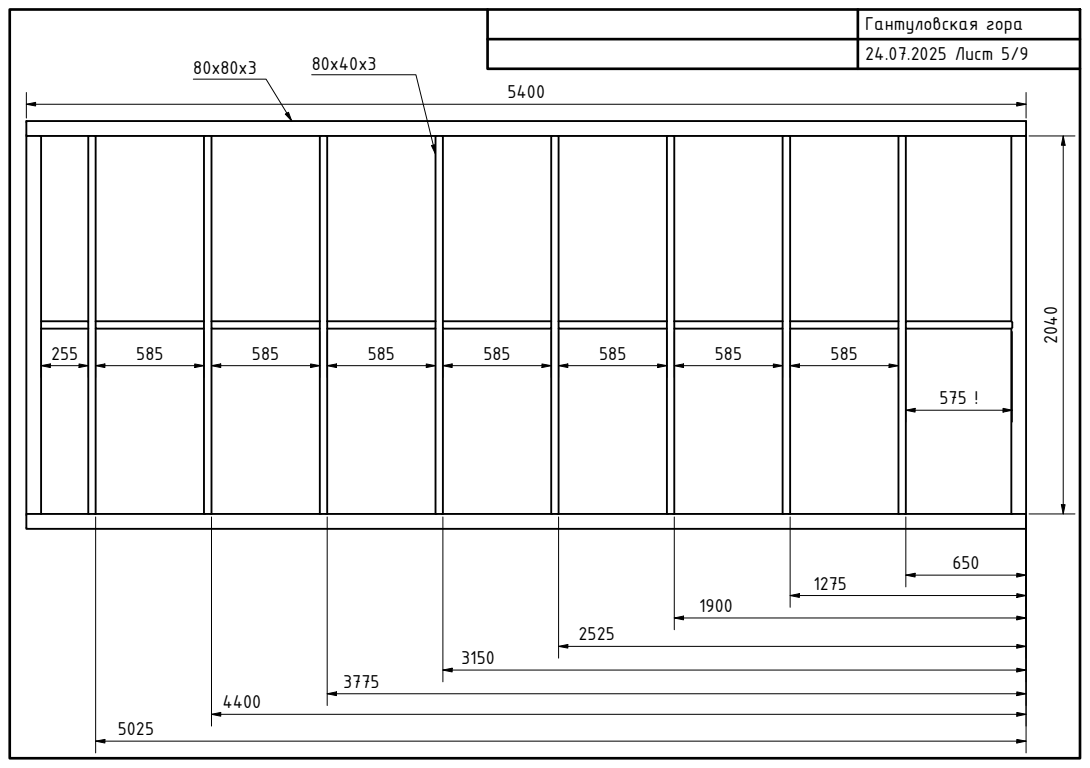
[picture p55: page 5]

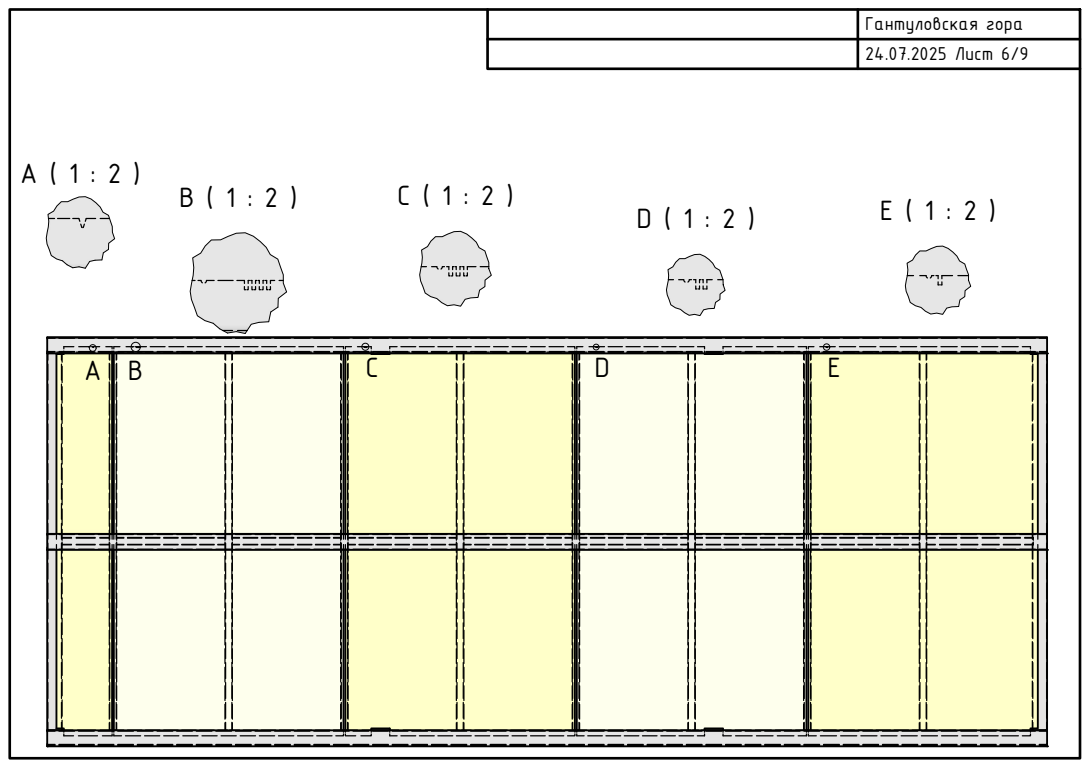
[picture p56: page 6]

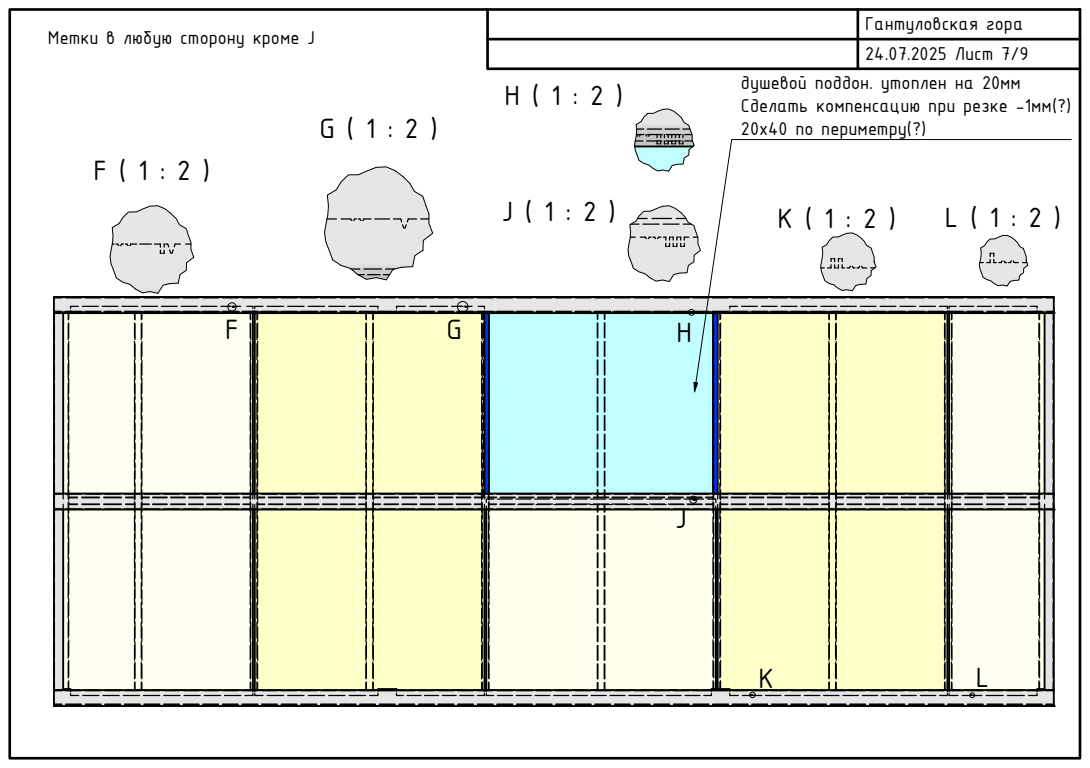
[picture p57: page 7]

Метки в любую сторону кроме J

душевой поддон. утоплен на 20мм
Сделать компенсацию при резке -1мм(?)
20х40 по периметру(?)

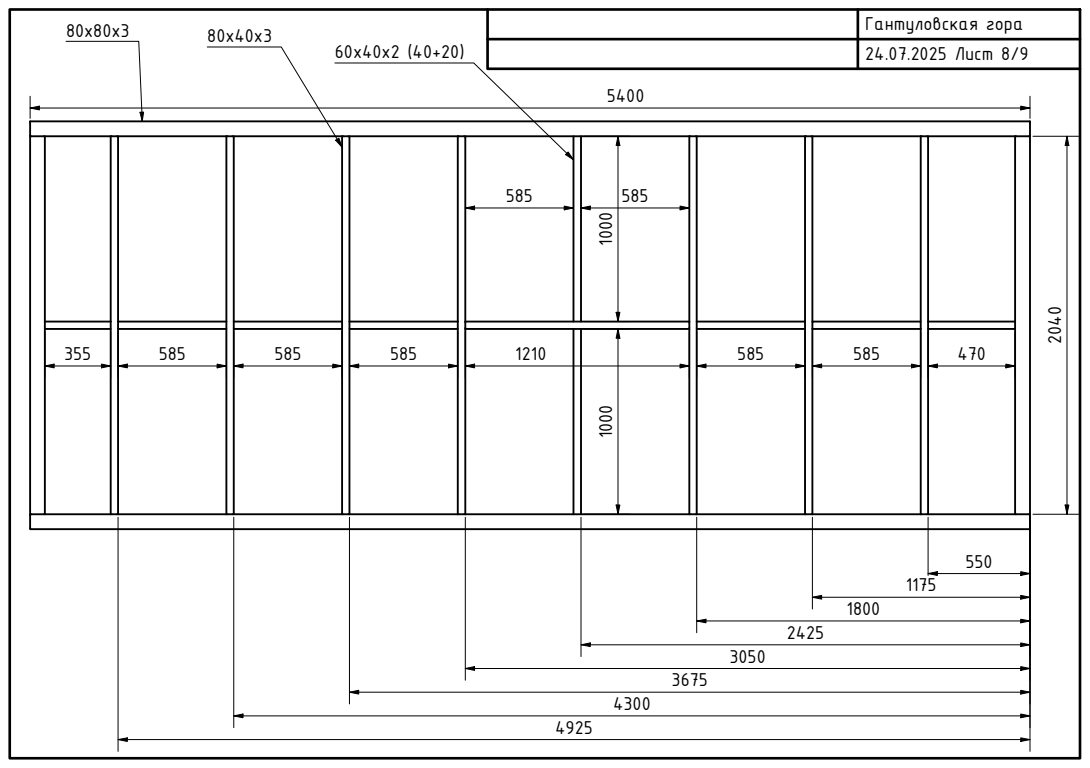
[picture p58: page 8]
