bigstrongbeast/GnG_Gantul_hill/Чертежи/Рама Гантуловская гора 23.10.25.pdf

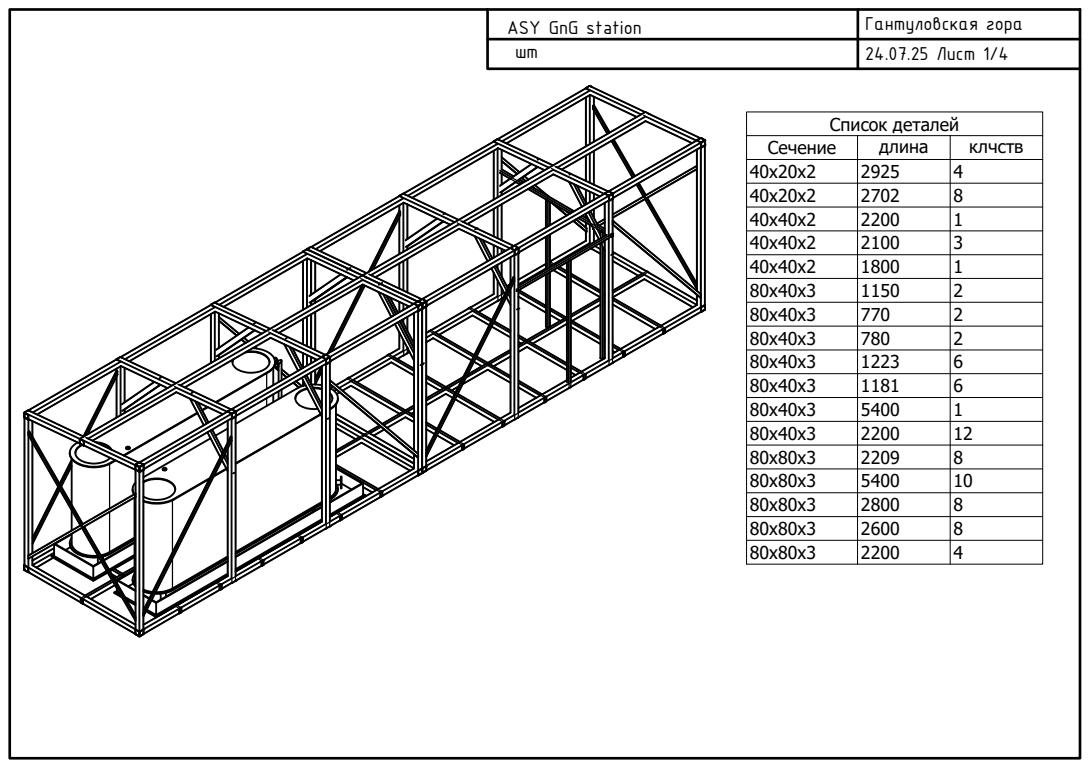
[picture p59: page 1]
Список деталей

ASY GnG station | Гантуловская гора
шт | 24.07.25 Лист 1/4

Сечение | длина | клчств
40x20x2 | 2925 | 4
40x20x2 | 2702 | 8
40x40x2 | 2200 | 1
40x40x2 | 2100 | 3
40x40x2 | 1800 | 1
80x40x3 | 1150 | 2
80x40x3 | 770 | 2
80x40x3 | 780 | 2
80x40x3 | 1223 | 6
80x40x3 | 1181 | 6
80x40x3 | 5400 | 1
80x40x3 | 2200 | 12
80x80x3 | 2209 | 8
80x80x3 | 5400 | 10
80x80x3 | 2800 | 8
80x80x3 | 2600 | 8
80x80x3 | 2200 | 4

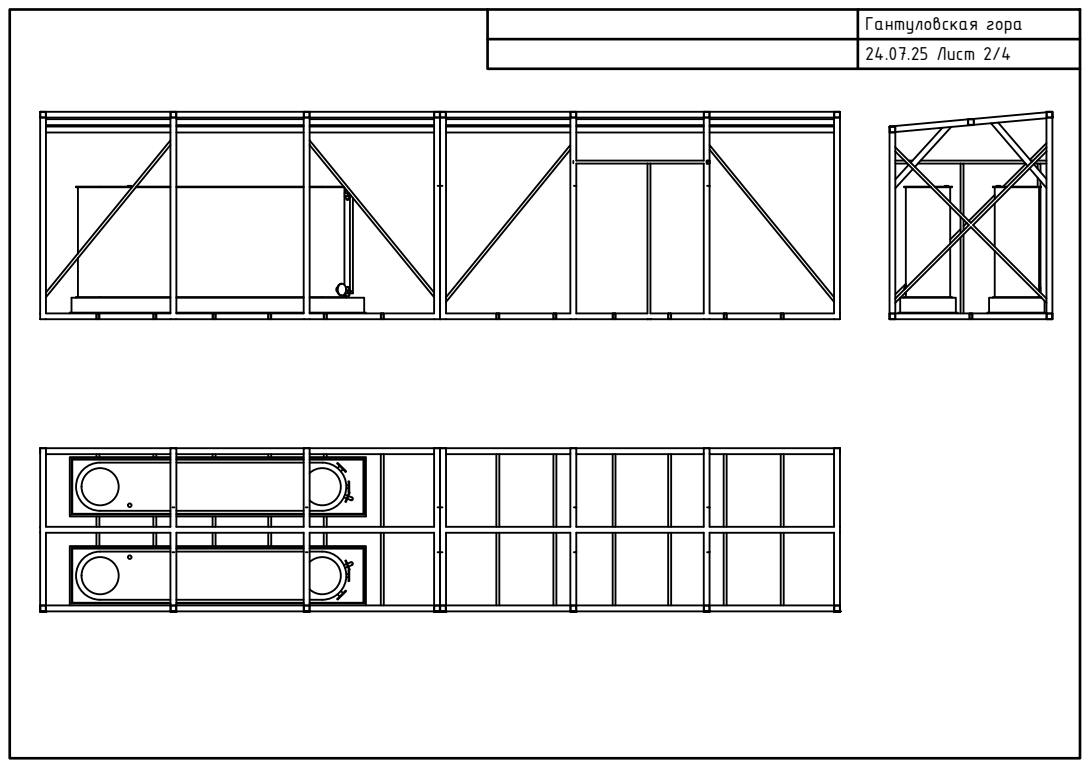
[picture p60: page 2]

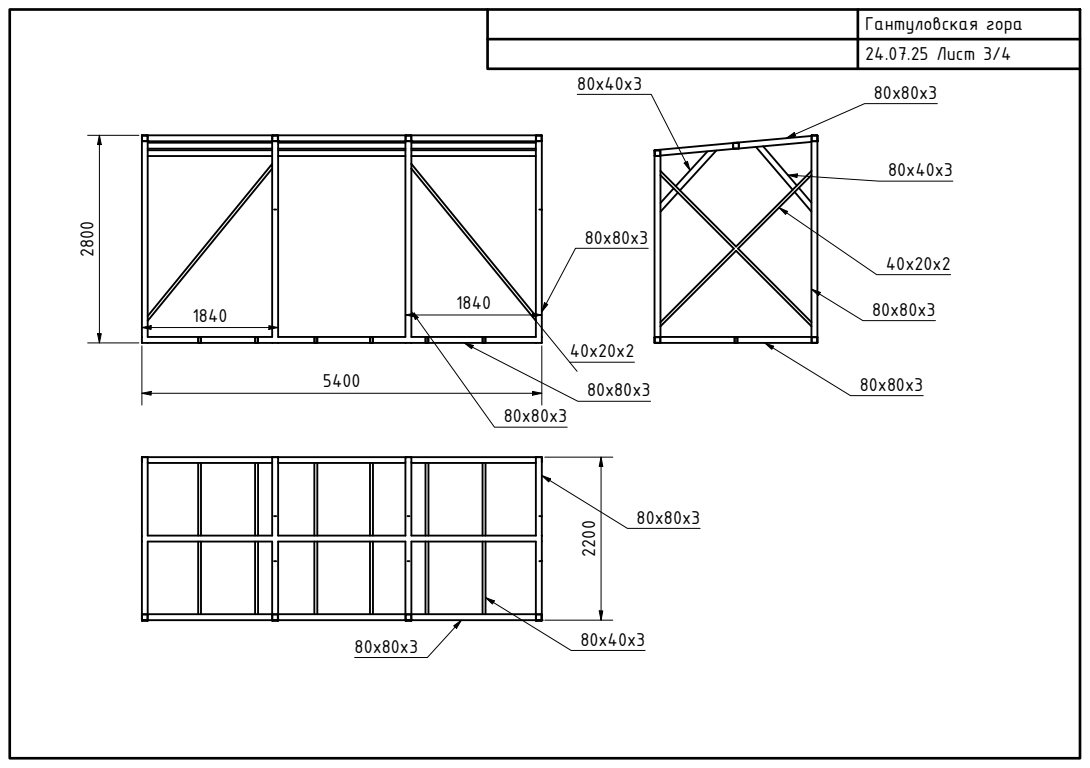
[picture p61: page 3]

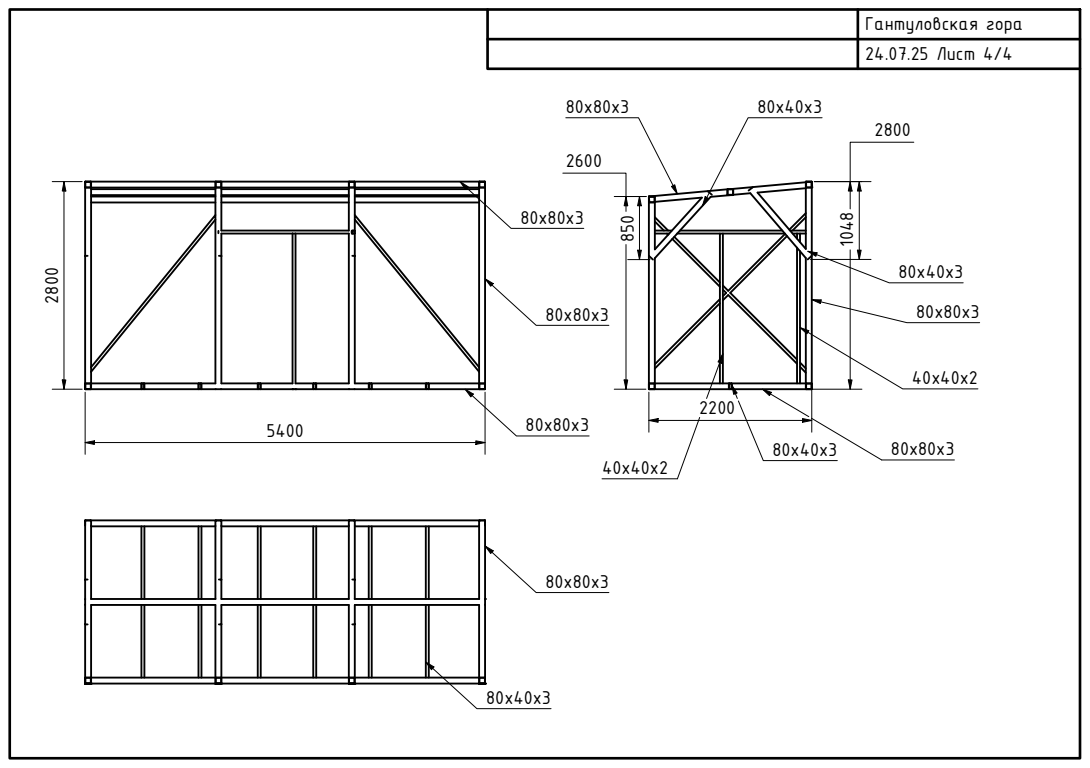
[picture p62: page 4]
