bigstrongbeast/GnG_Gantul_hill/ref/Гантуловская гора 13.10.2025.pdf

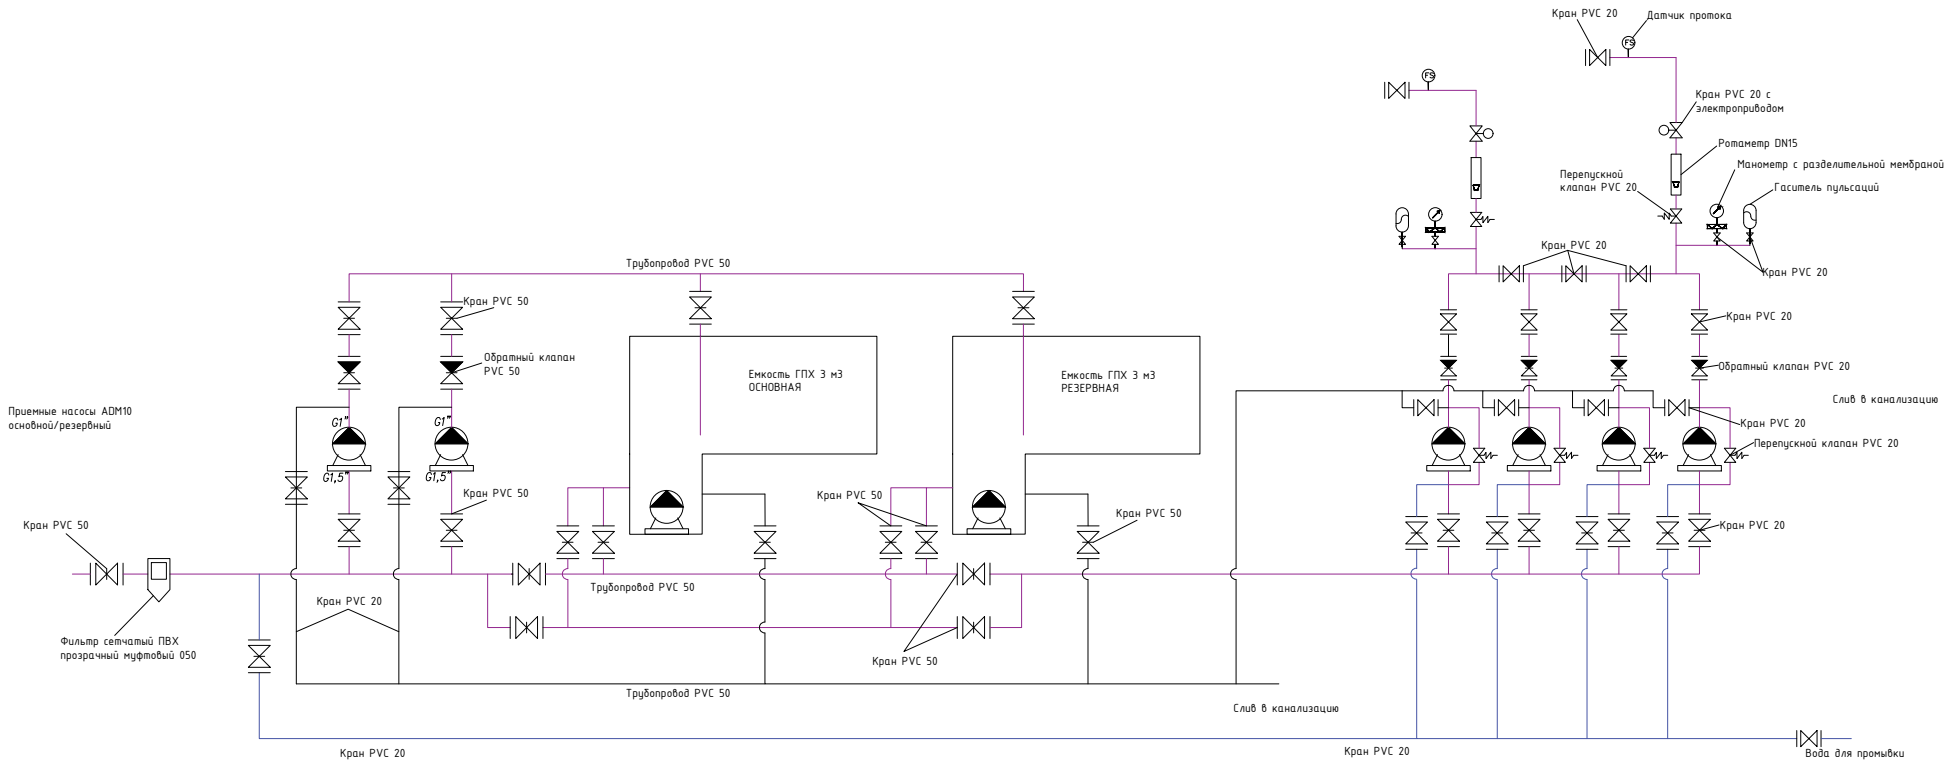
[picture p63: page 1]
Вода для промывки Слив в канализацию Кран PVC 20 Перепускной клапан PVC 20 Обратный клапан PVC 20 Кран PVC 20 Кран PVC 20; Ротаметр DN15 Манометр с разделительной мембраной Гаситель пульсаций Кран PVC 20 Перепускной клапан PVC 20; Кран PVC 20 с электроприводом Кран PVC 20; Датчик протока Кран PVC 20 Трубопровод PVC 50; Емкость ГПХ 3 м3 ОСНОВНАЯ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
