bigstrongbeast/GnG_Gantul_hill/Чертежи/Том 01 Гантуловская гора 15.10.25.pdf

Вода для промывки Слив в канализацию Кран PVC 20 Перепускной клапан PVC 20 Обратный клапан PVC 20 Кран PVC 20 Кран PVC 20 | Ротаметр DN15 Манометр с разделительной мембраной Гаситель пульсаций Кран PVC 20 Перепускной клапан PVC 20 | Кран PVC 20 с электроприводом Кран PVC 20 | Датчик протока Кран PVC 20 Трубопровод PVC 50 | Емкость ГПХ 3 м3 ОСНОВНАЯ | Емкость ГПХ 3 м3 РЕЗЕРВНАЯ Трубопровод PVC 50 Кран PVC 50 Кран PVC 50 Обратный клапан PVC 50 Фильтр сетчатый ПВХ прозрачный муфтовый 050 Кран PVC 50 Приемные насосы ADM10 основной/резервный | Слив в канализацию Кран PVC 20 | Кран PVC 20 Кран PVC 20 | Трубопровод PVC 50 | Кран PVC 50 Кран PVC 50Кран PVC 50

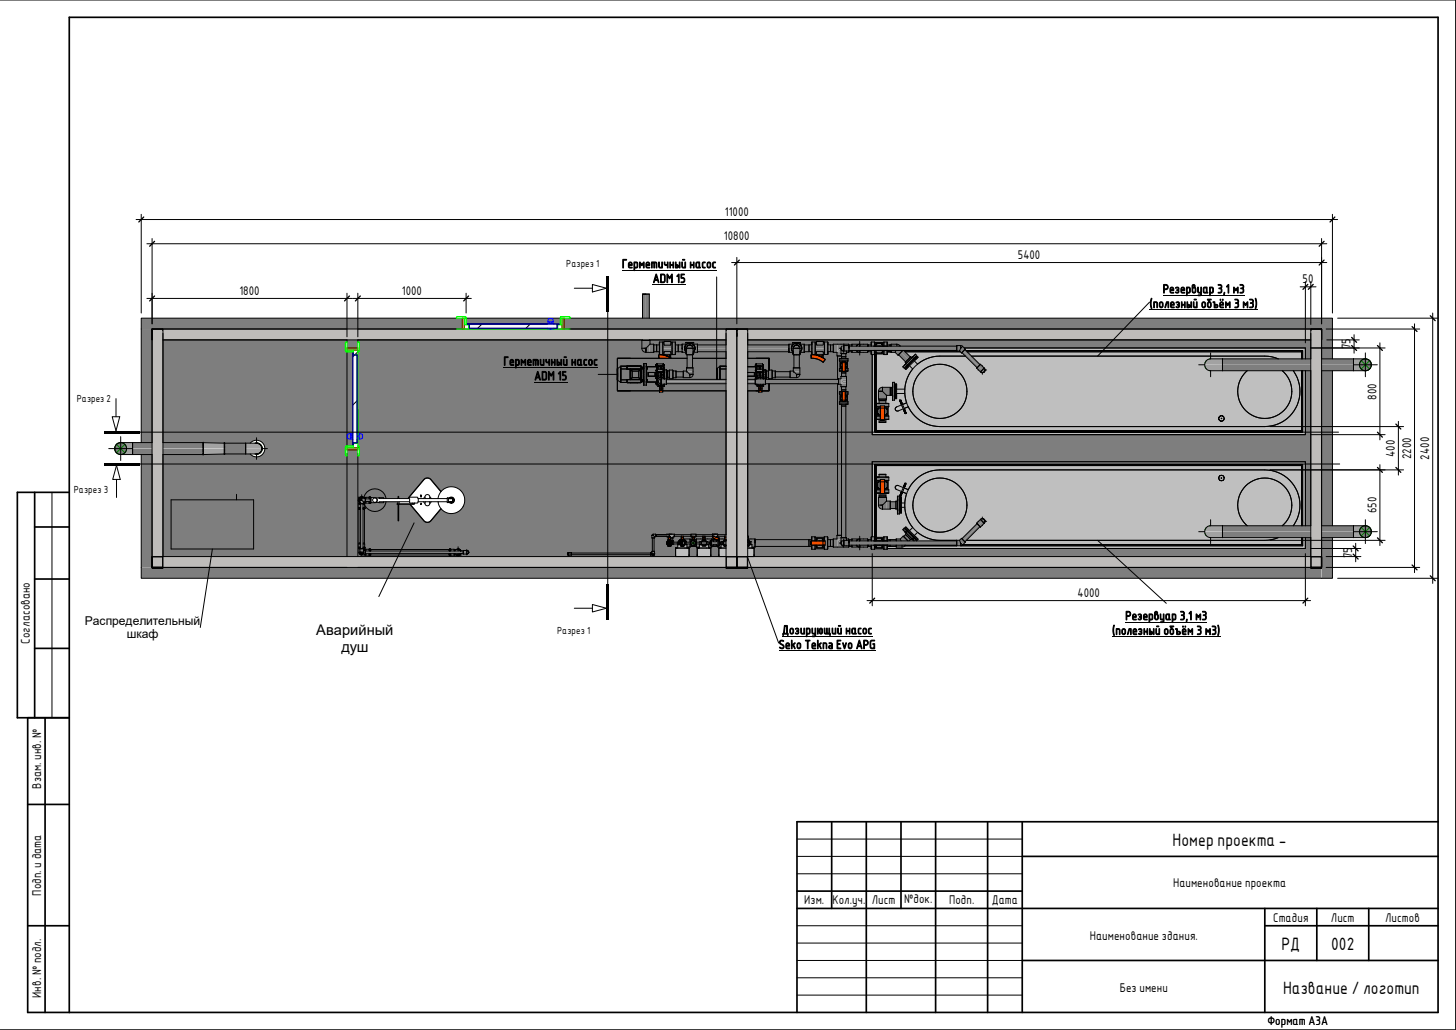
[picture p64: page 2]
Разрез 1; Разрез 2; Разрез 3; Аварийный душ; Распределительный шкаф; Резервуар 3,1 м3 (полезный объём 3 м3); Герметичный насос ADM 15; Изм. Кол.уч. Лист №док.; Подп.; Дата; Стадия; Лист; Листов; Согласовано; Инв. № подл; Название / логотип; Формат А3А; Номер проекта -; Наименование проекта; Наименование здания.; Без имени

Дозирующий насос
Seko Tekna Evo APG

. Подп. и дата Взам. инв.

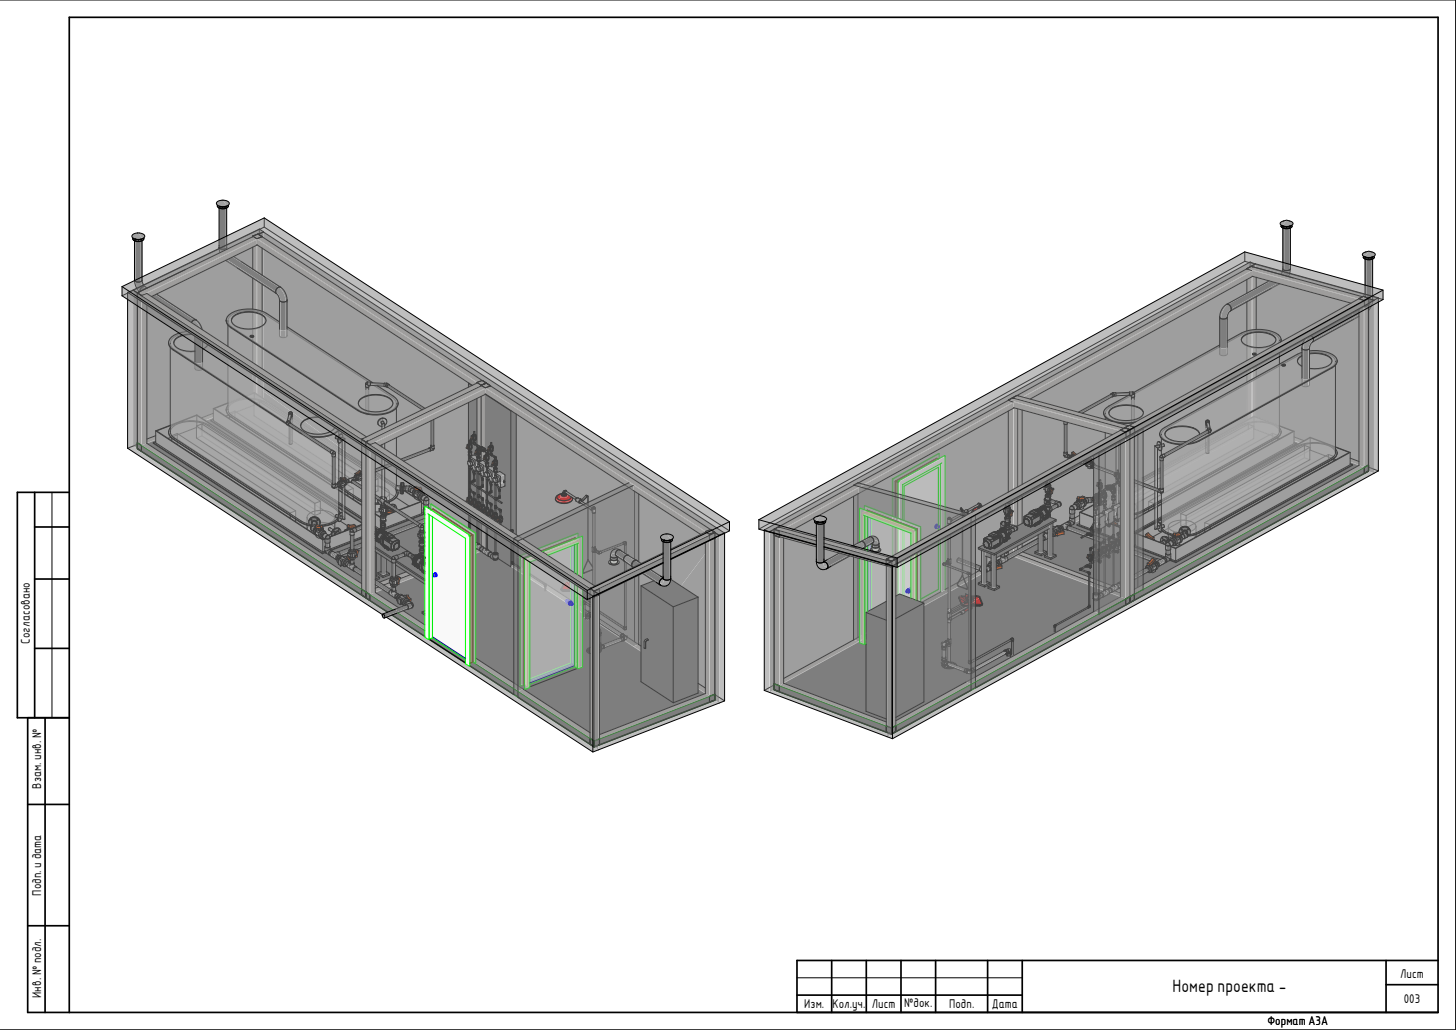
[picture p65: page 3]
Согласовано; Изм. Кол.уч. Лист №док.; Подп.; Дата; Лист; Номер проекта

Инв. № подл. Подп. и дата Взам. инв. №

Разрез 1-1 | Разрез 2-2

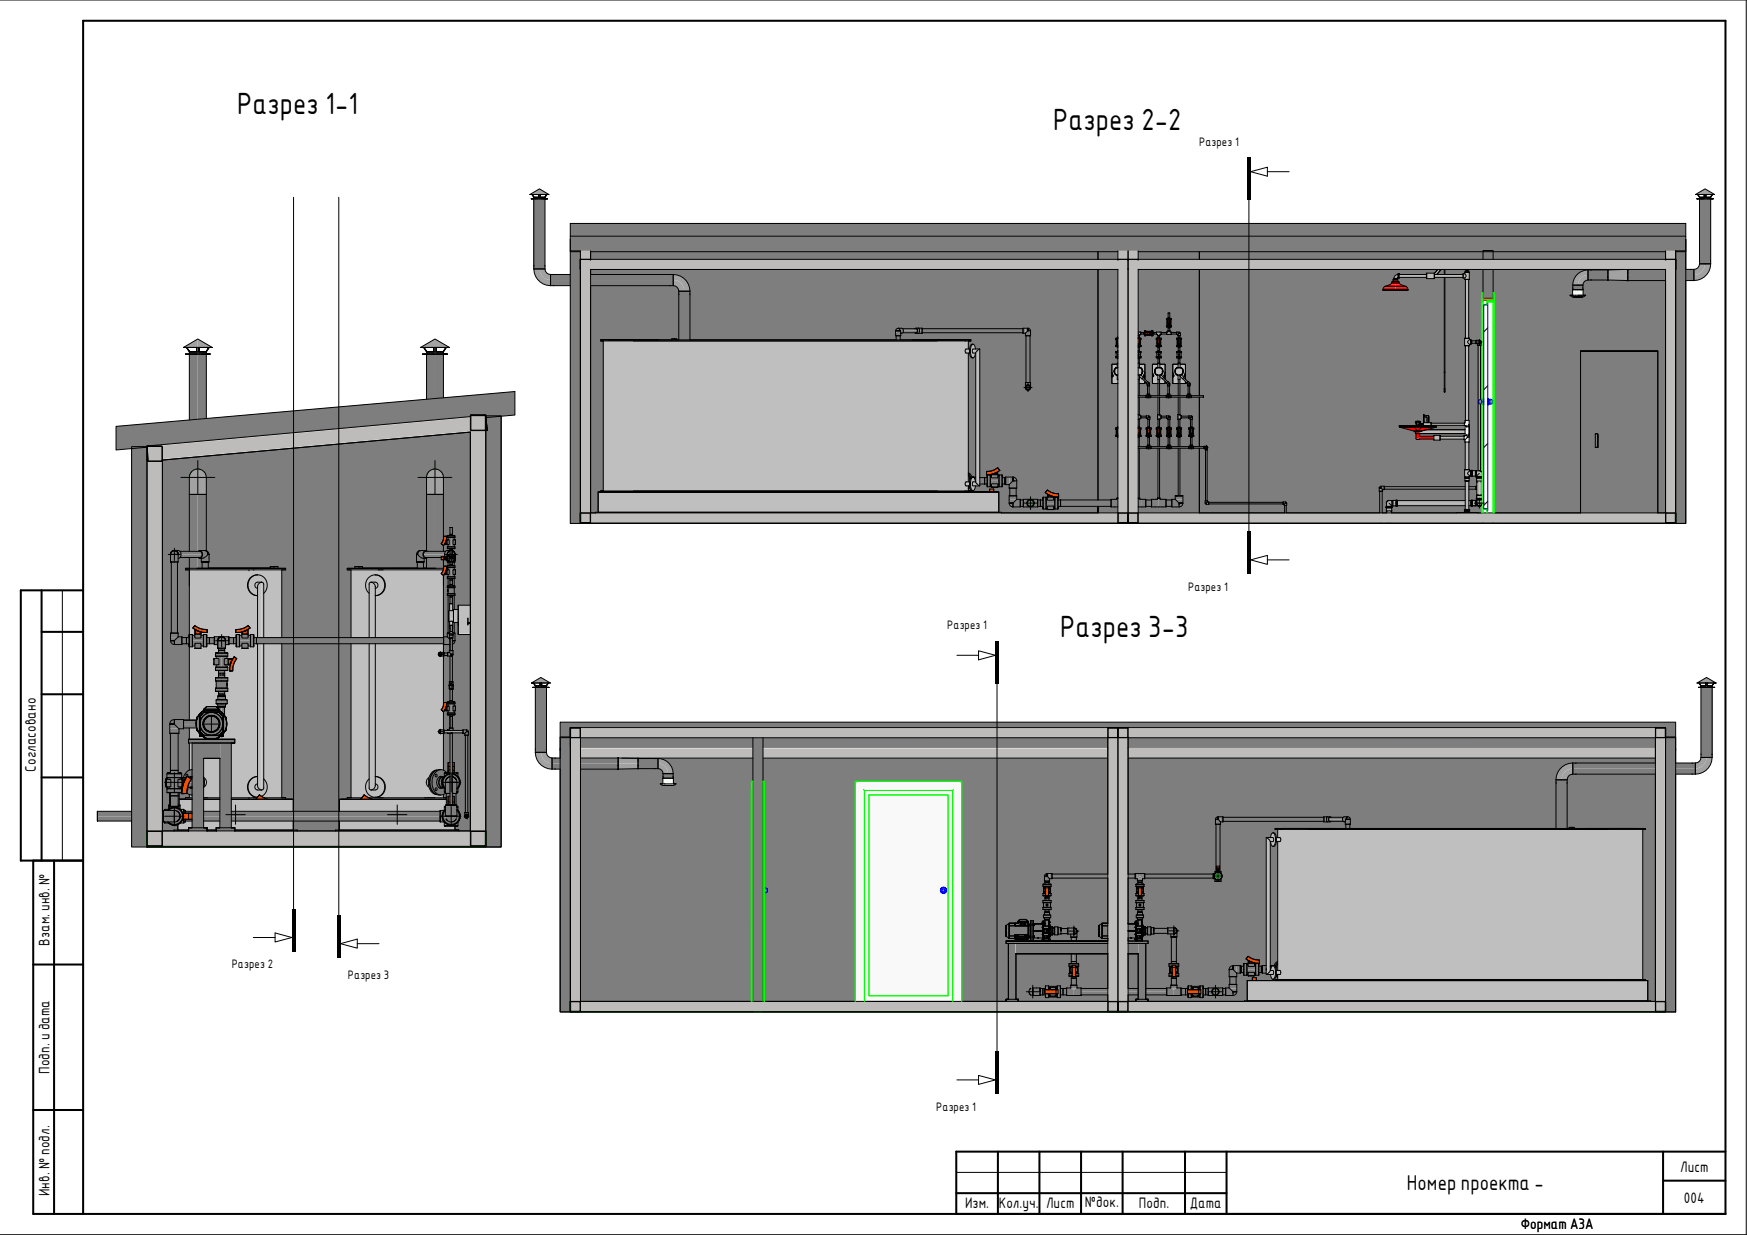
[picture p66: page 4]
Разрез 2; Разрез 3; Разрез 1; Согласовано; Инв. № подл; Изм. Кол.уч. Лист №док.; Подп.; Дата; Лист; Номер проекта -; Разрез 3-3

. Подп. и дата Взам. инв.
