bigstrongbeast/GnG_Gantul_hill/Чертежи/DRW GNG НаOCl tank 1.2 24,09,25.pdf

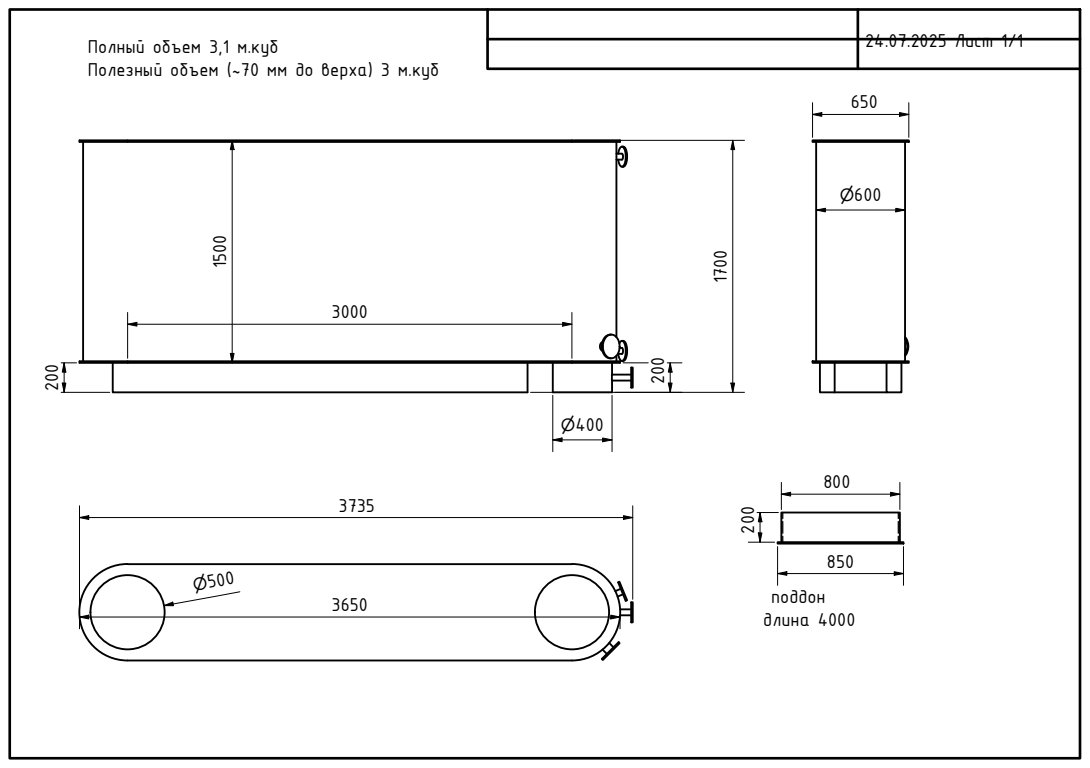
[picture p67: page 1]
24.07.2025 Лист 1/1; длина 4000

Полный объем 3,1 м.куб
Полезный объем (~70 мм до верха) 3 м.куб
