bigstrongbeast/GnG_Gantul_hill/Чертежи/DRW GNG НаOCl tank 25.09.25.pdf

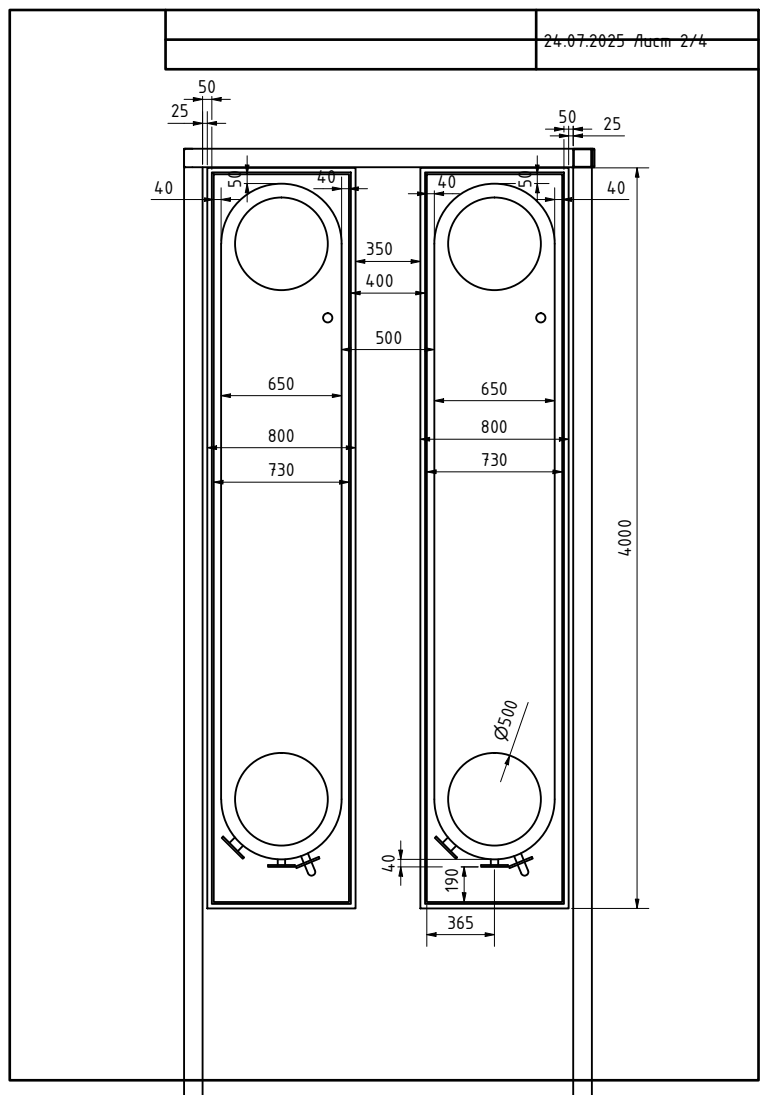
[picture p68: page 1]
24.07.2025 Лист 2/4

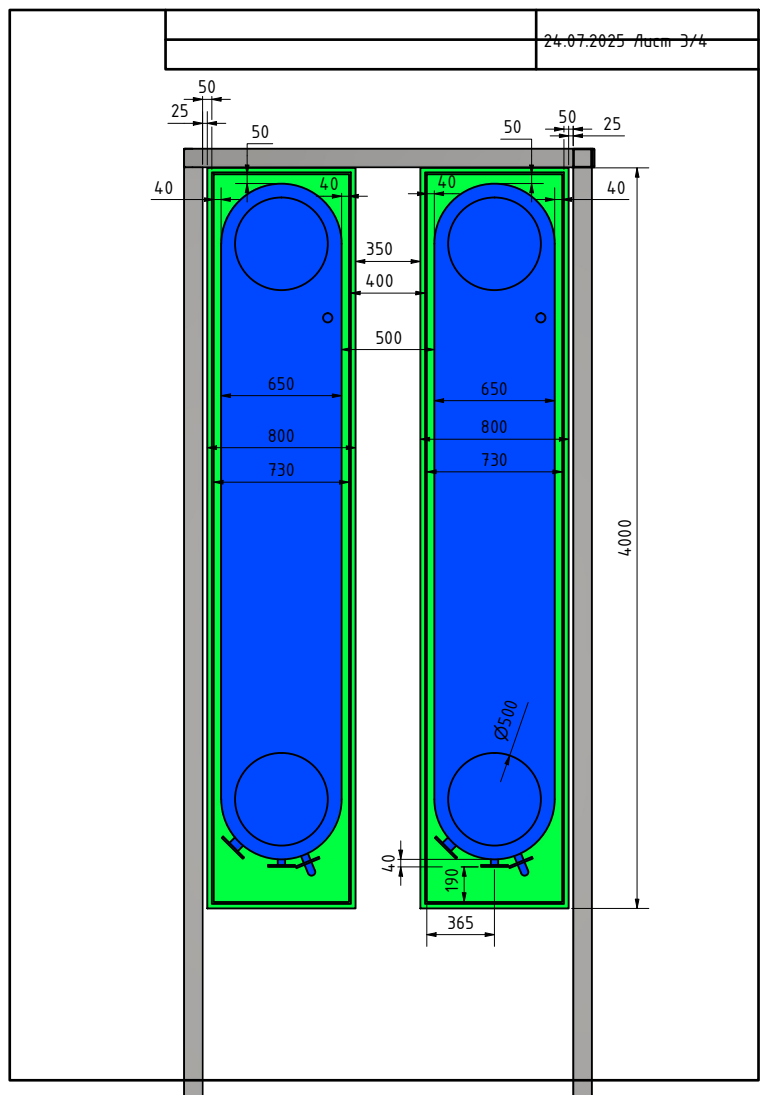
[picture p69: page 2]
24.07.2025 Лист 3/4
