bigstrongbeast/GnG_Gantul_hill/Чертежи/DRW GNG НаOCl tank.pdf

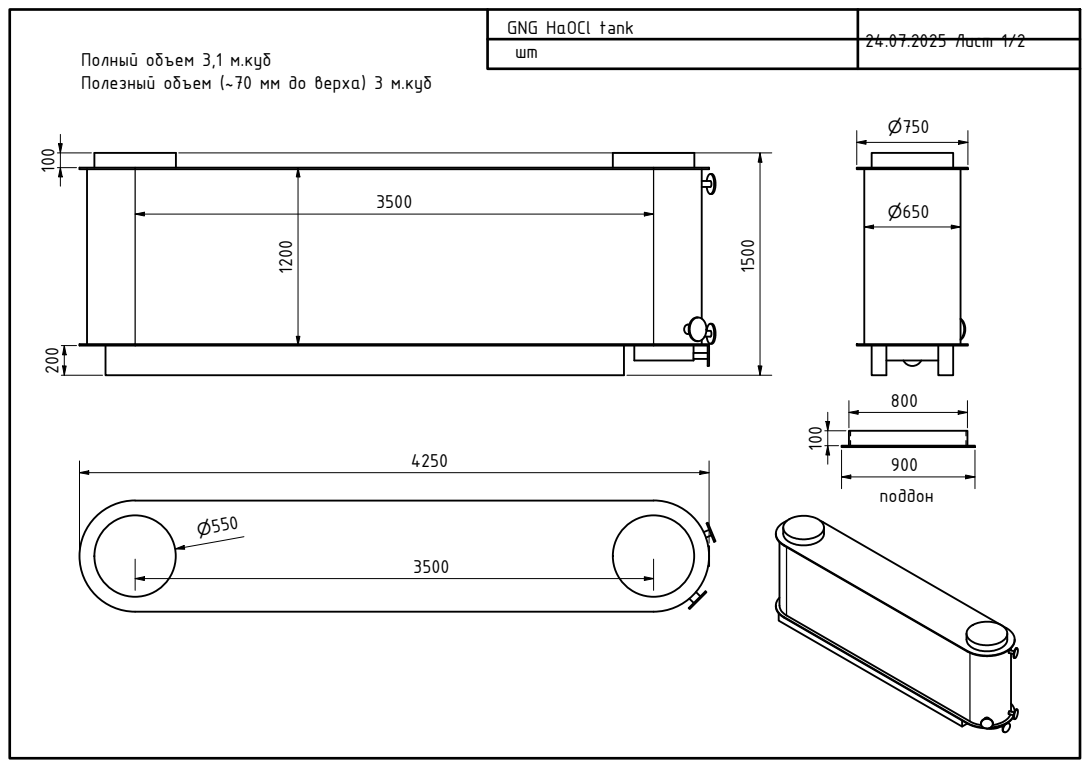
[picture p70: page 1]

GNG НаOCl tank | 24.07.2025 Лист 1/2
шт

Полный объем 3,1 м.куб
Полезный объем (~70 мм до верха) 3 м.куб

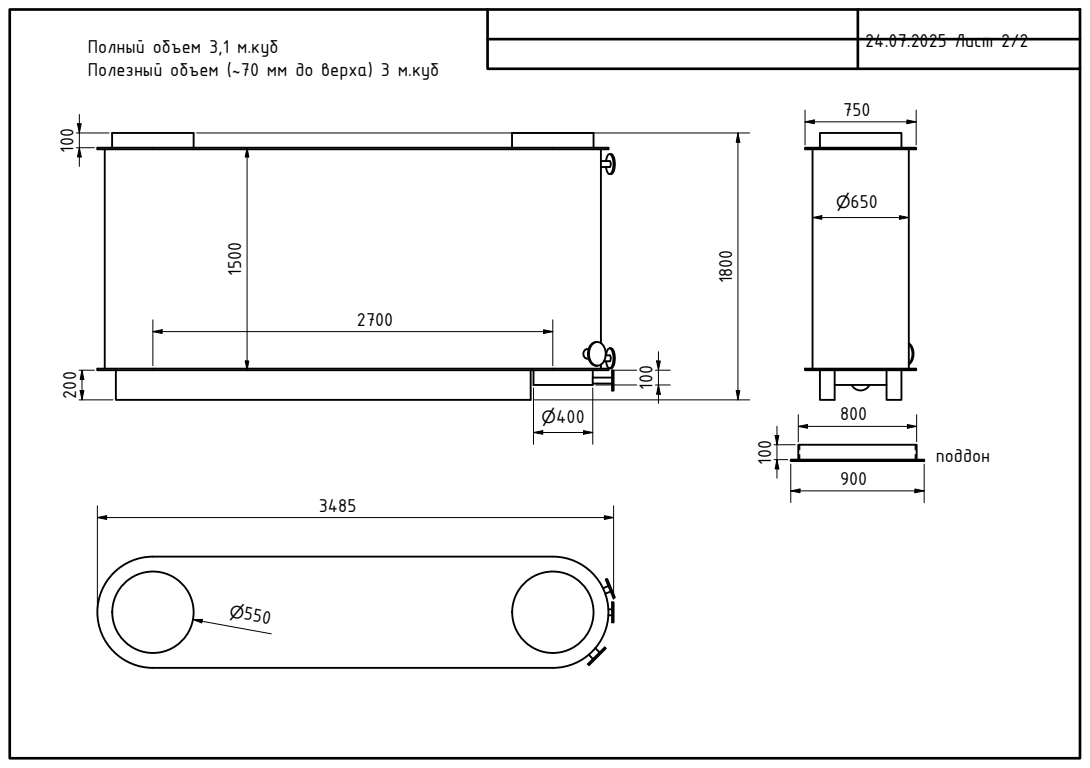
[picture p71: page 2]
24.07.2025 Лист 2/2

Полный объем 3,1 м.куб
Полезный объем (~70 мм до верха) 3 м.куб
