bigstrongbeast/GnG_Gantul_hill/Чертежи/Том 01 Гантуловская гора 25.09.25.pdf

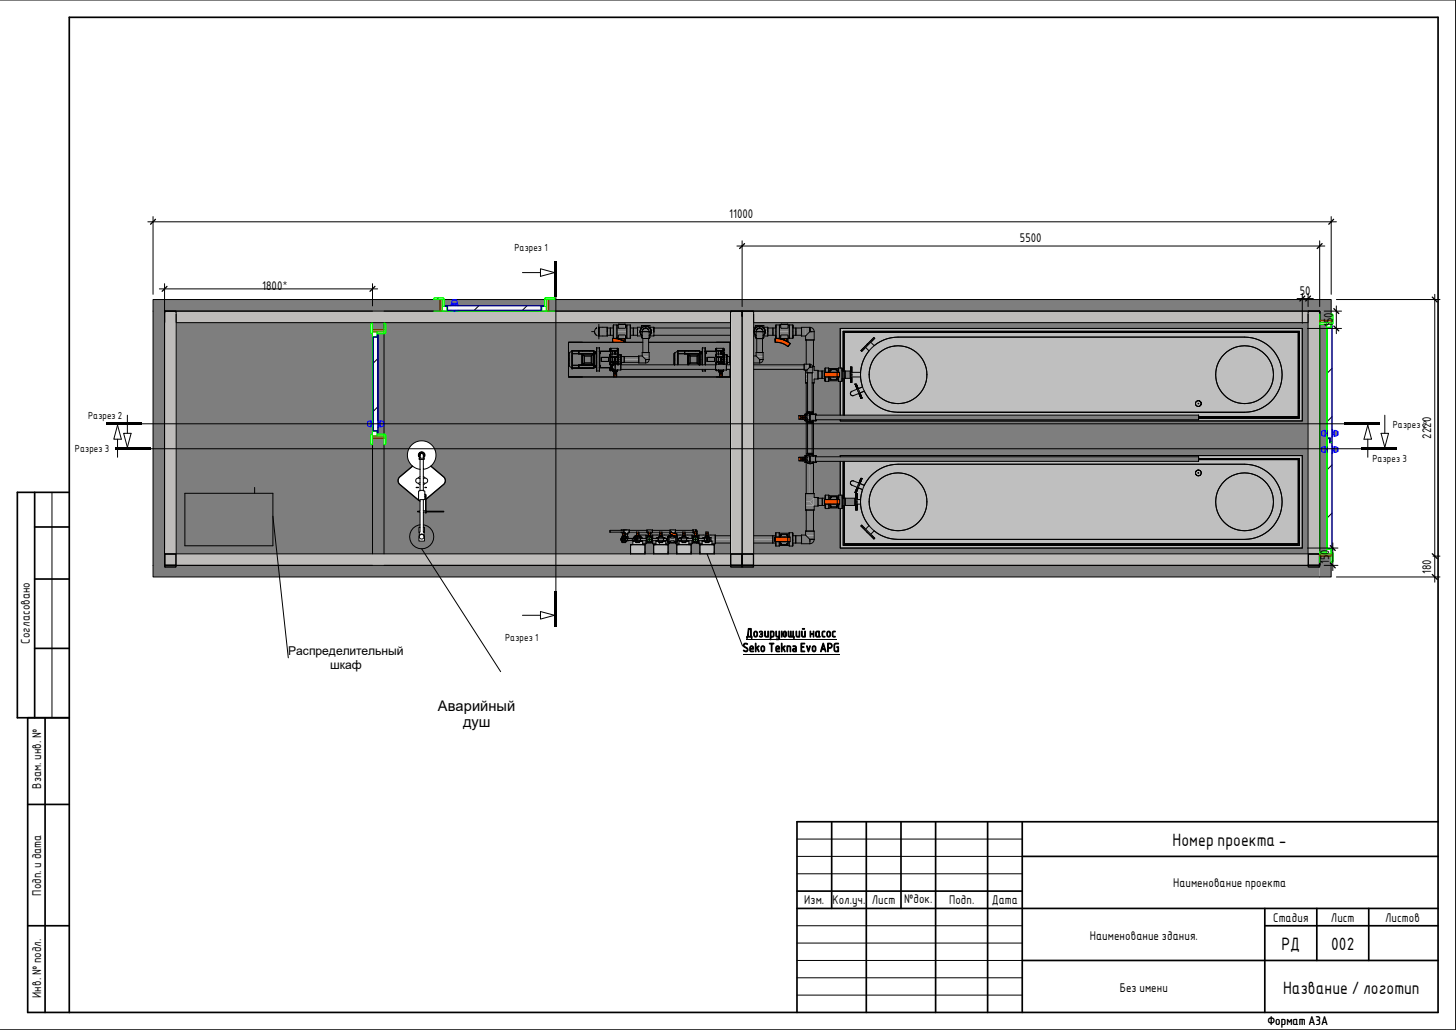
[picture p72: page 1]
Разрез 1; Разрез 2; Разрез 3; Аварийный душ; Дозирующий насос; Распределительный; Seko Tekna Evo APG; шкаф; Изм. Кол.уч. Лист №док.; Подп.; Дата; Стадия; Лист; Листов; Согласовано; Инв. № подл; Название / логотип; Формат А3А; Номер проекта -; Наименование проекта; Наименование здания.; Без имени

. Подп. и дата Взам. инв.

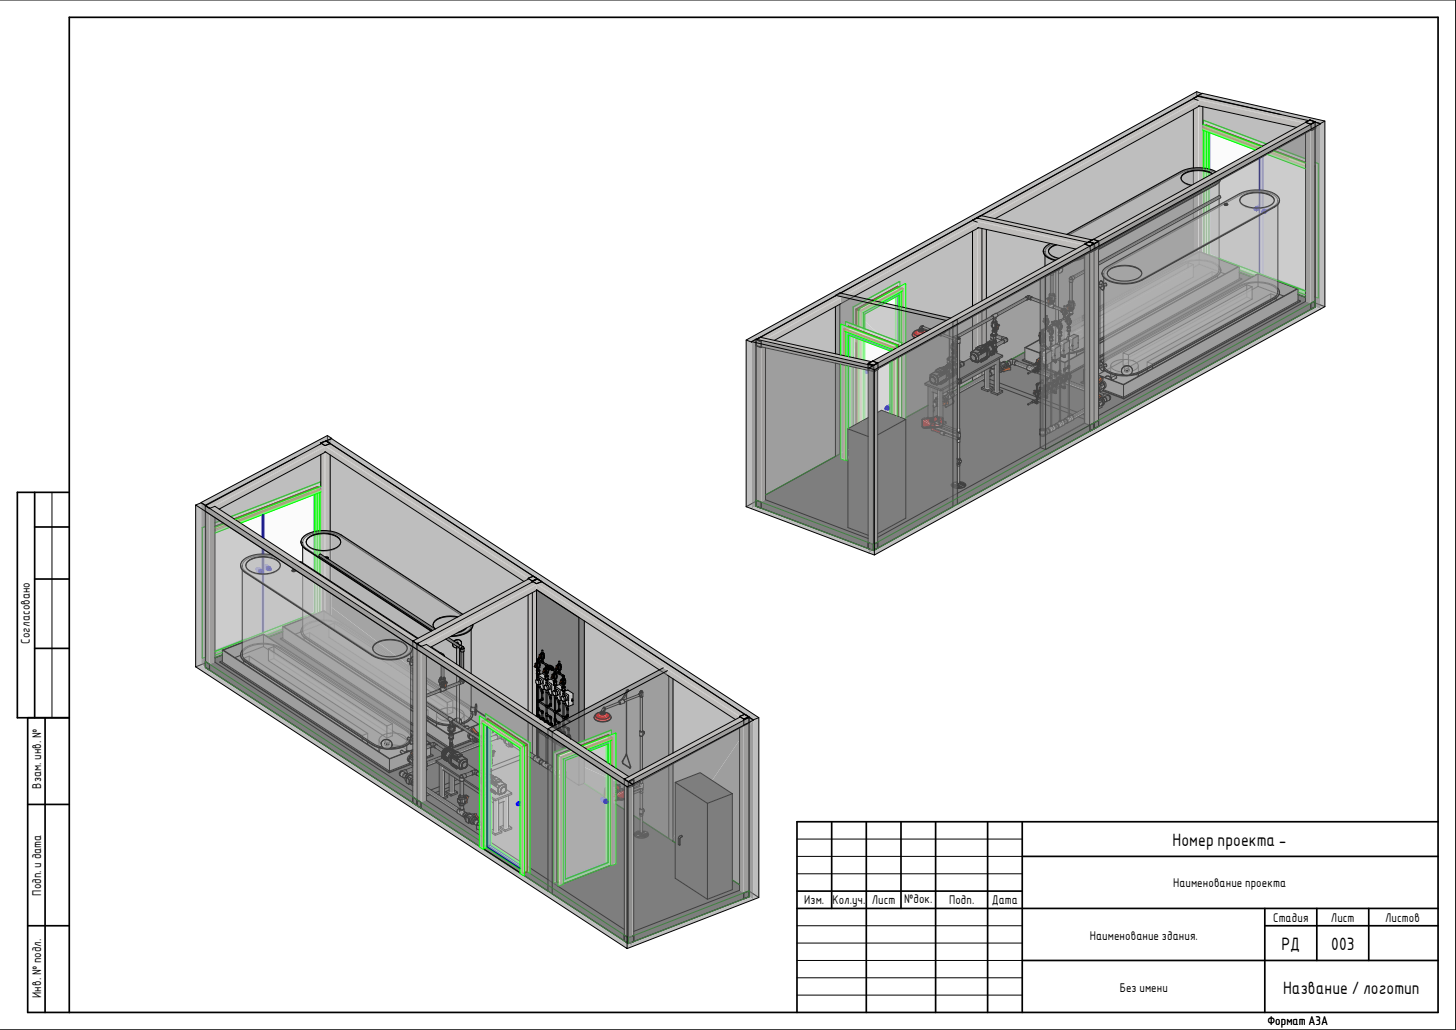
[picture p73: page 2]
Изм. Кол.уч. Лист №док.; Подп.; Дата; Стадия; Лист; Листов; Согласовано; Номер проекта; Наименование проекта; Наименование здания.; Без имени

Инв. № подл. Подп. и дата Взам. инв. № Название / логотип

Разрез 1-1 | Разрез 2-2

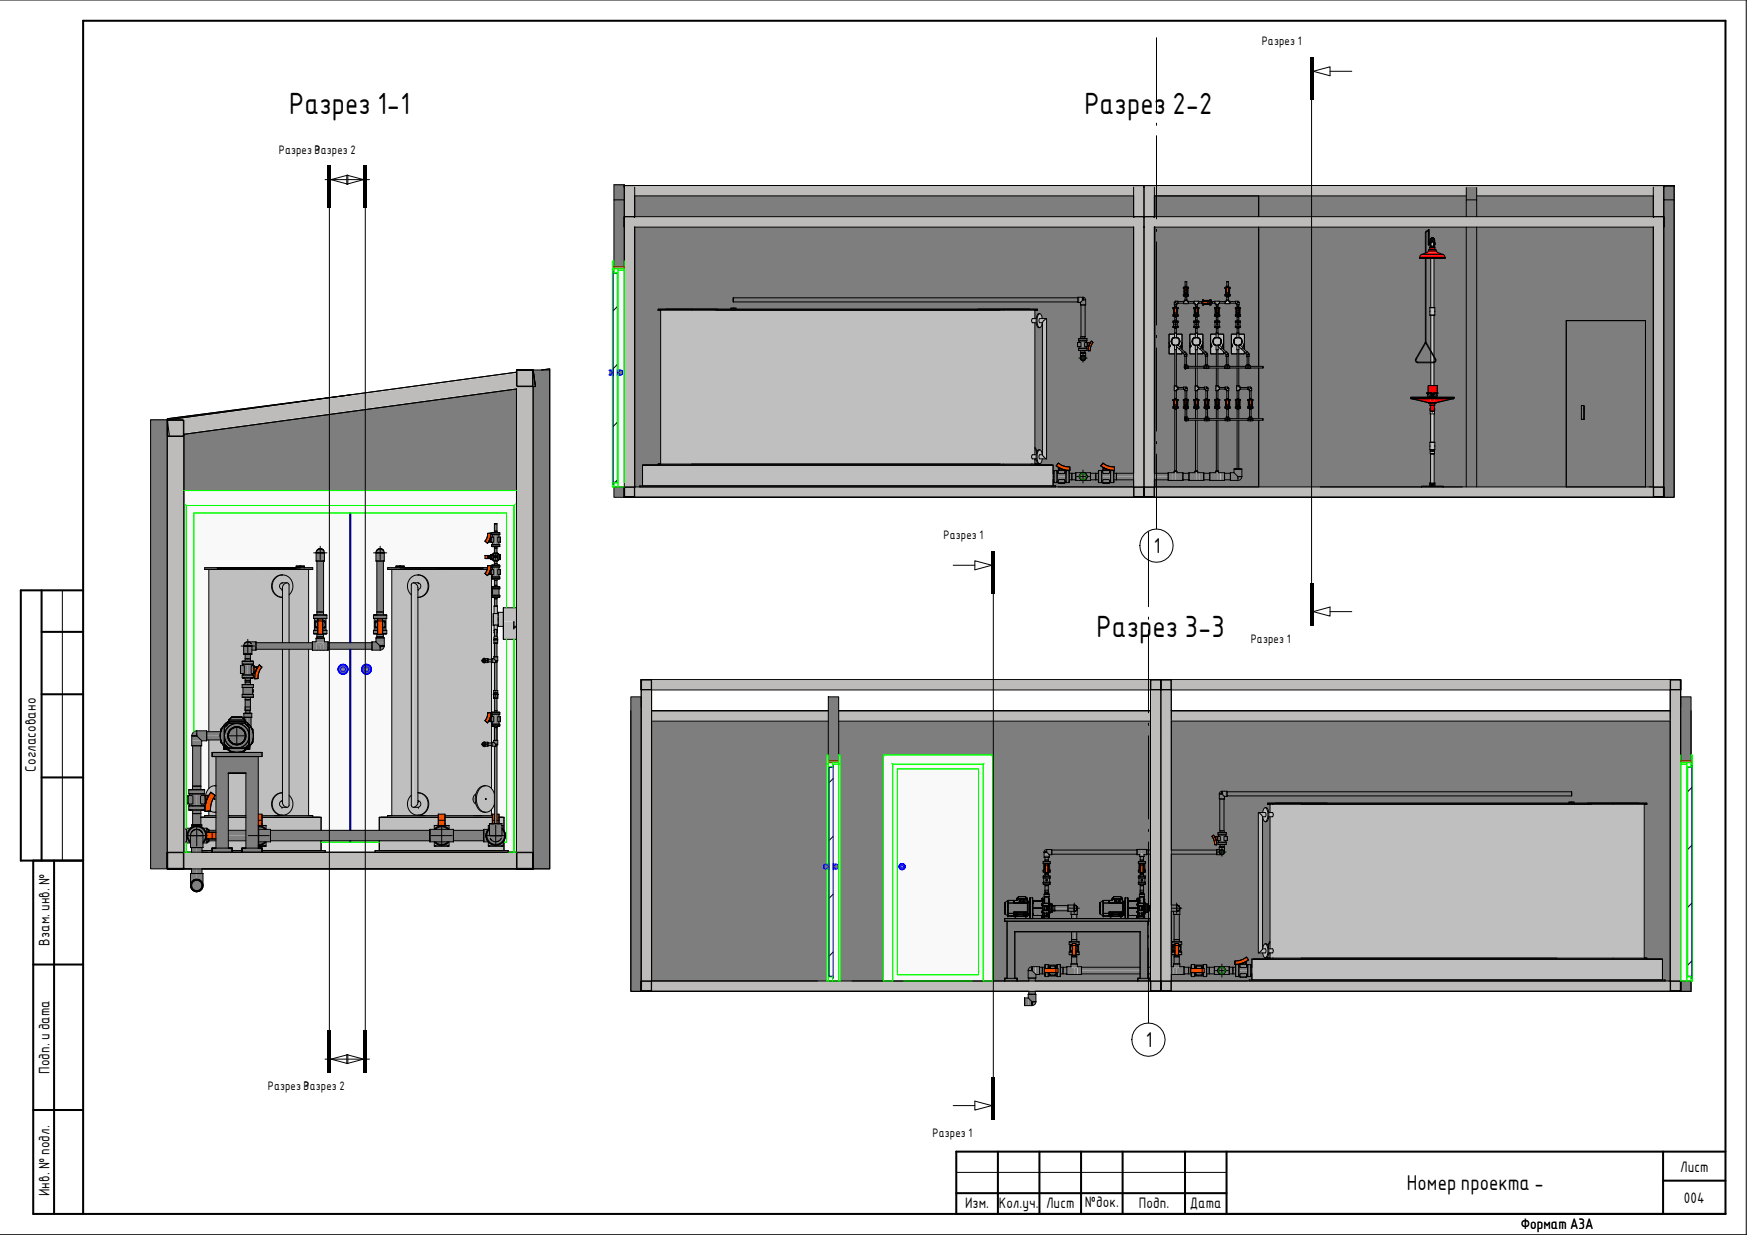
[picture p74: page 3]
Разрез 2; Разрез 3; Разрез 1; Согласовано; Изм. Кол.уч. Лист №док.; Подп.; Дата; Лист; Номер проекта; Разрез 3-3

Инв. № подл. Подп. и дата Взам. инв. №
