bigstrongbeast/GnG_Gantul_hill/Чертежи/Том 01 Гантуловская гора 26.09.25.pdf

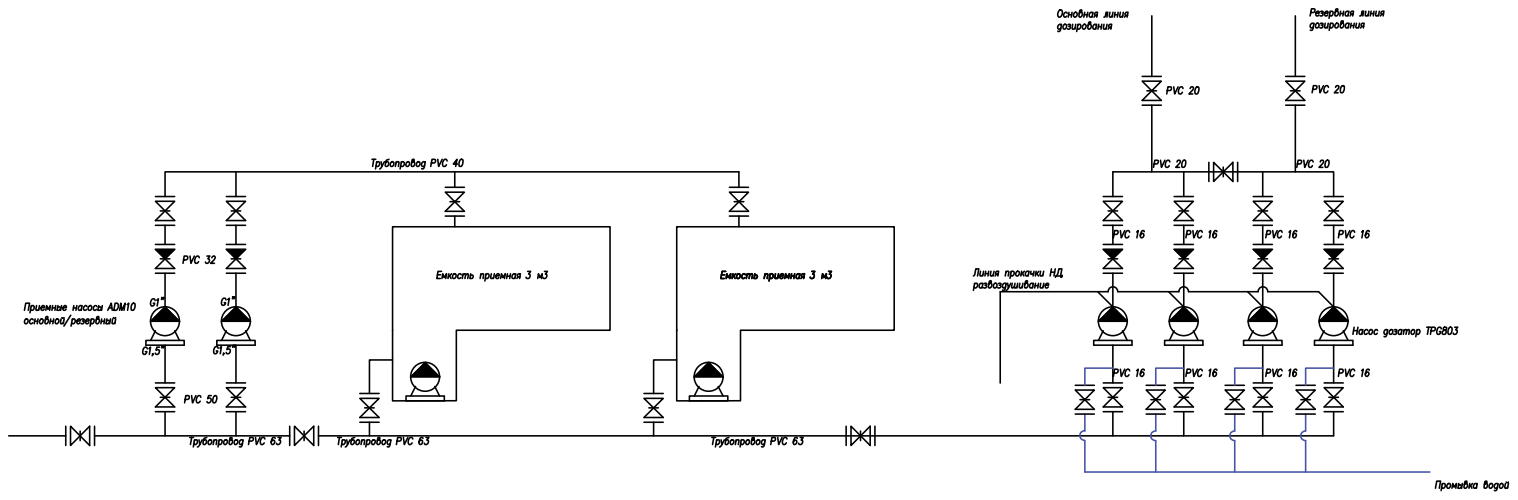
[picture p75: page 1]

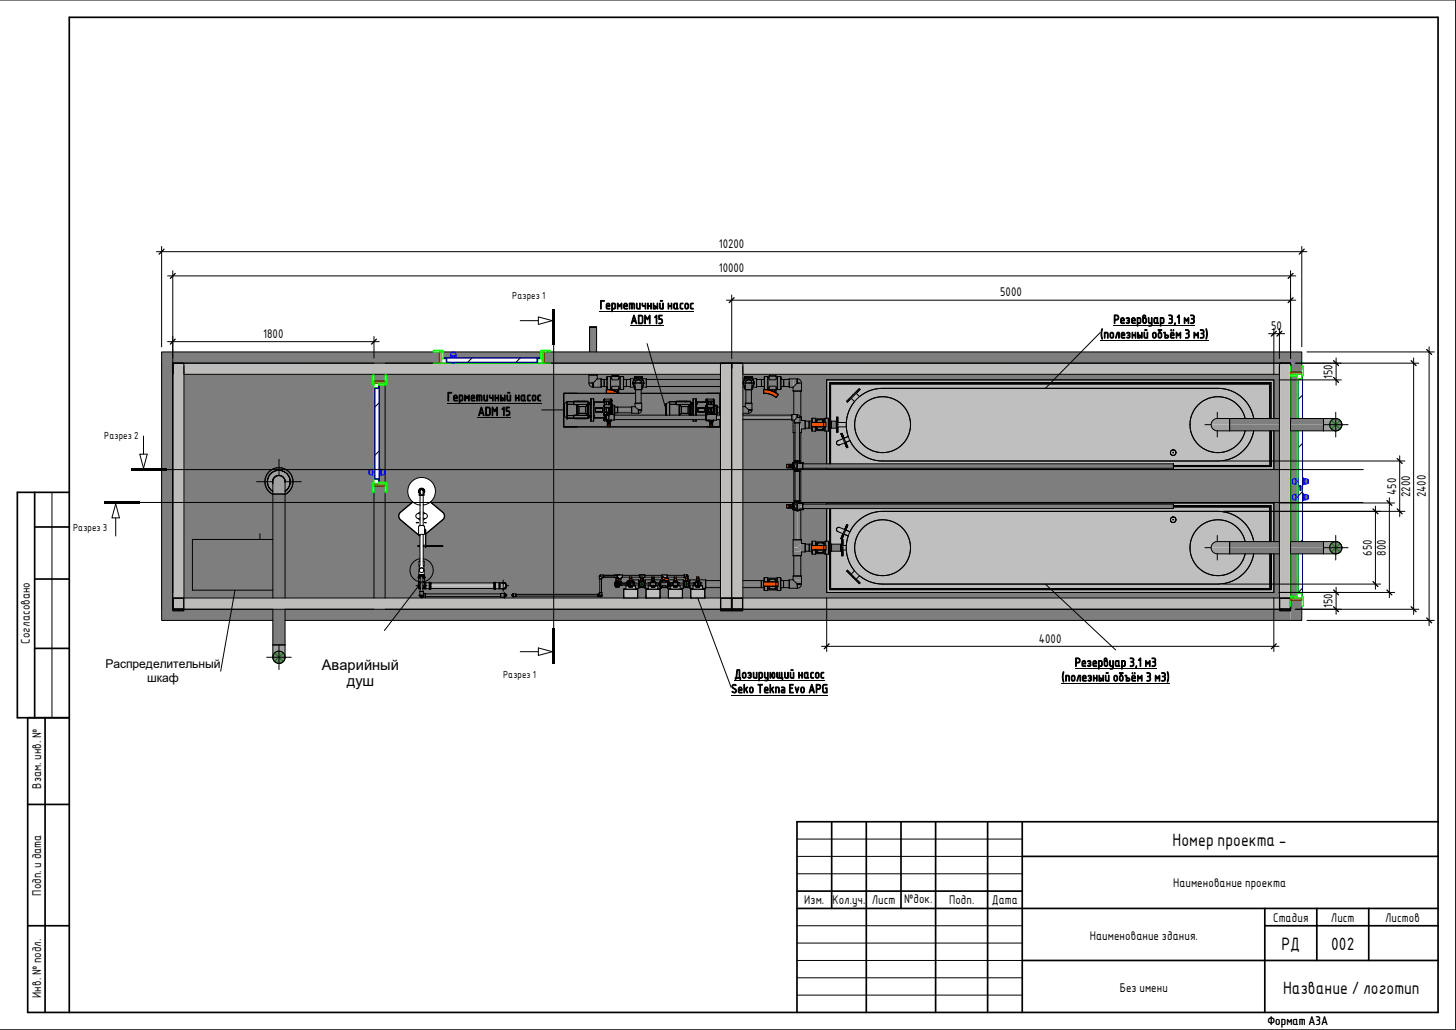
[picture p76: page 2]
Разрез 1; Разрез 2; Разрез 3; Аварийный; душ; Дозирующий насос Seko Tekna Evo APG Распределительный шкаф; Резервуар 3,1 м3 (полезный объём 3 м3); Герметичный насос ADM 15; Изм. Кол.уч. Лист №док.; Подп.; Дата; Стадия; Лист; Листов; Согласовано; Инв. № подл; Название / логотип; Формат А3А; Номер проекта -; Наименование проекта; Наименование здания.; Без имени

. Подп. и дата Взам. инв.

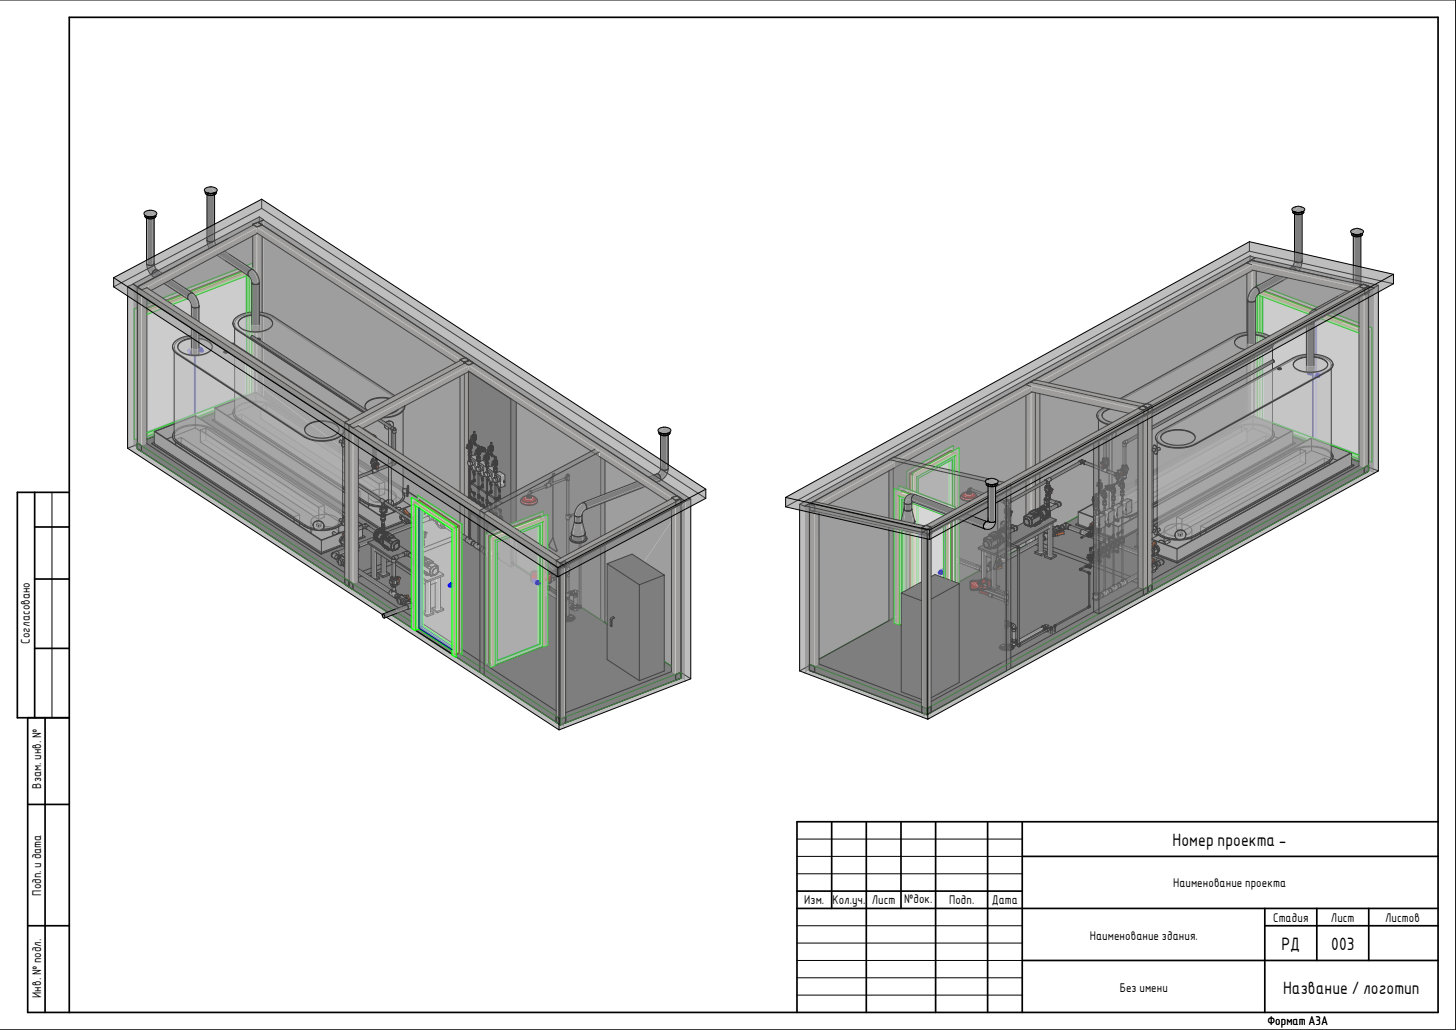
[picture p77: page 3]
Изм. Кол.уч. Лист №док.; Подп.; Дата; Стадия; Лист; Листов; Согласовано; Номер проекта; Наименование проекта; Наименование здания.; Без имени

Инв. № подл. Подп. и дата Взам. инв. № Название / логотип

Разрез 1-1 | Разрез 2-2

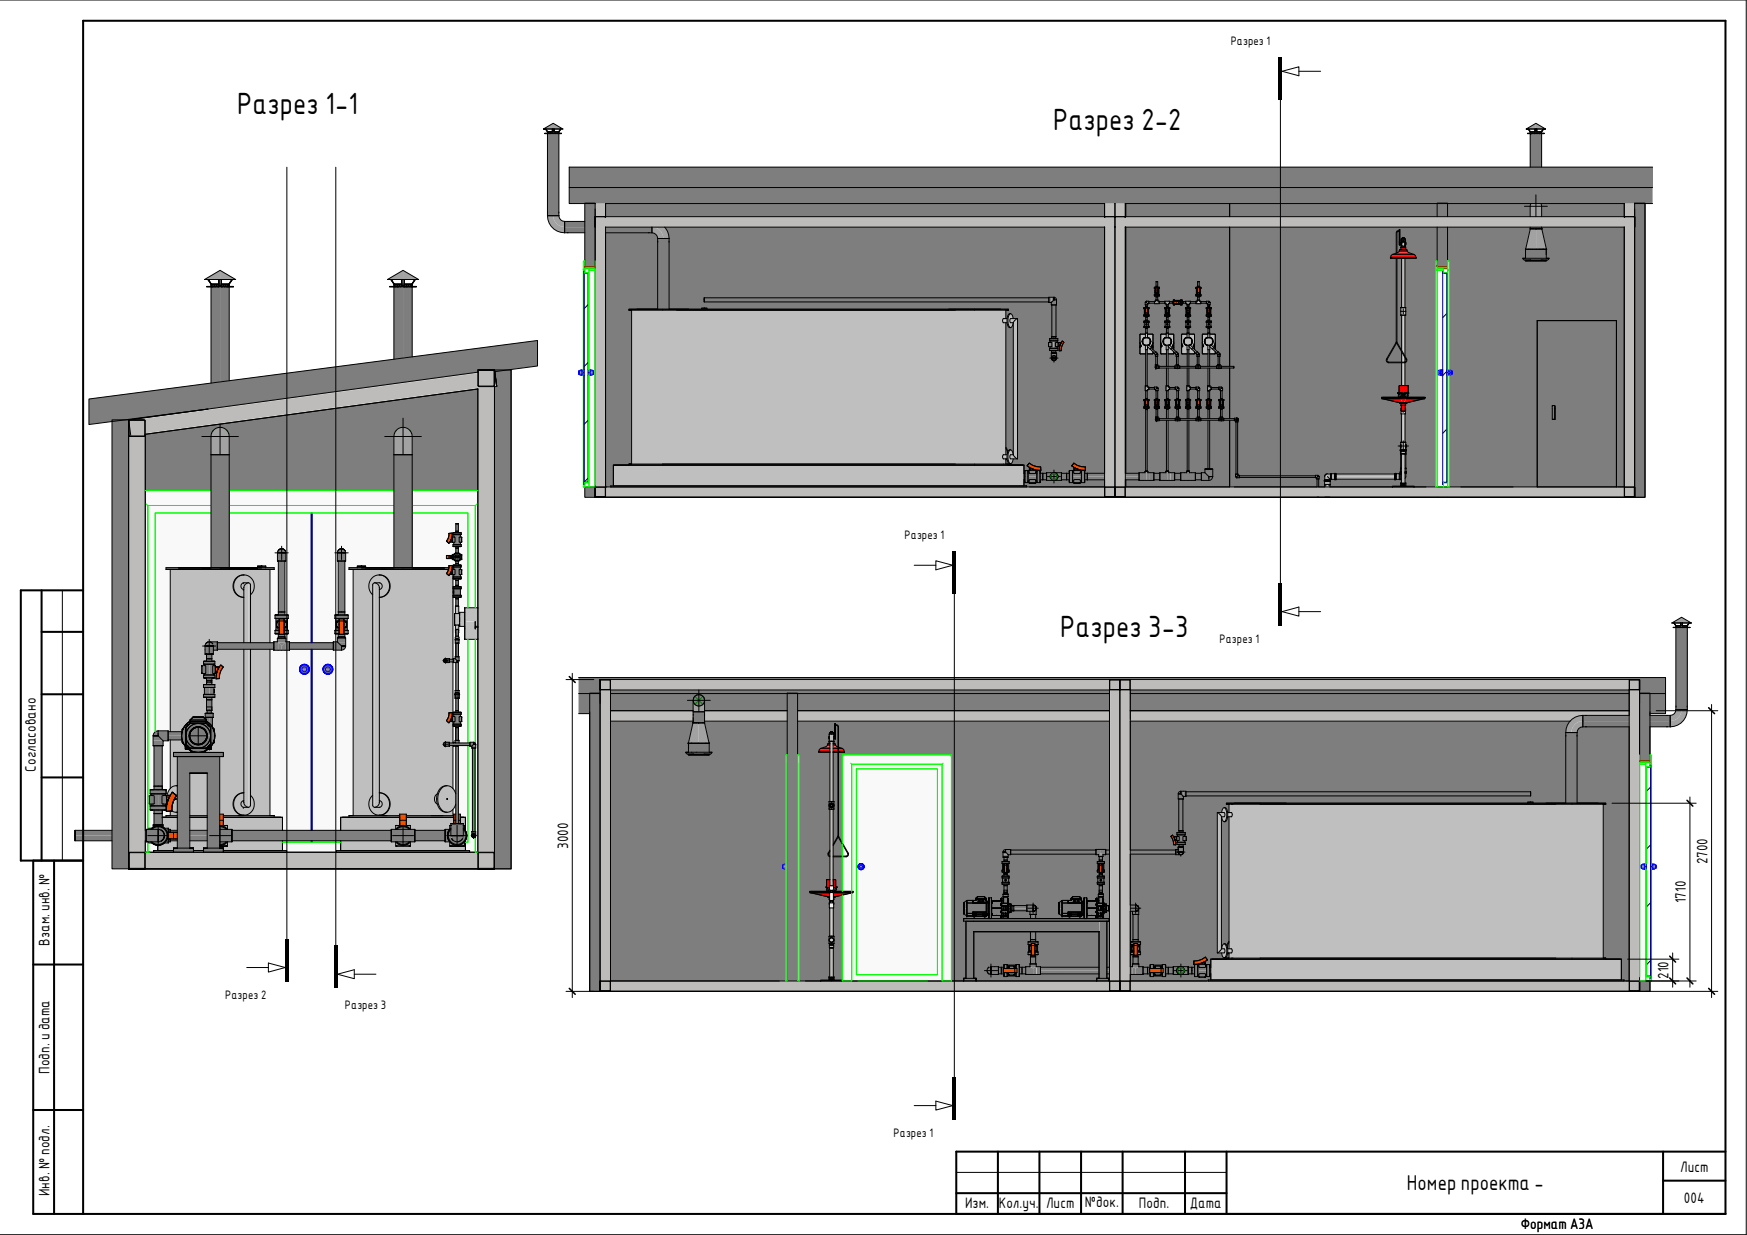
[picture p78: page 4]
Разрез 2; Разрез 3; Разрез 1; Согласовано; Инв. № подл; Изм. Кол.уч. Лист №док.; Подп.; Дата; Лист; Номер проекта -; Разрез 3-3

. Подп. и дата Взам. инв.
