bigstrongbeast/GnG_Gantul_hill/Чертежи/Том 01 Гантуловская гора 24.09.25.pdf

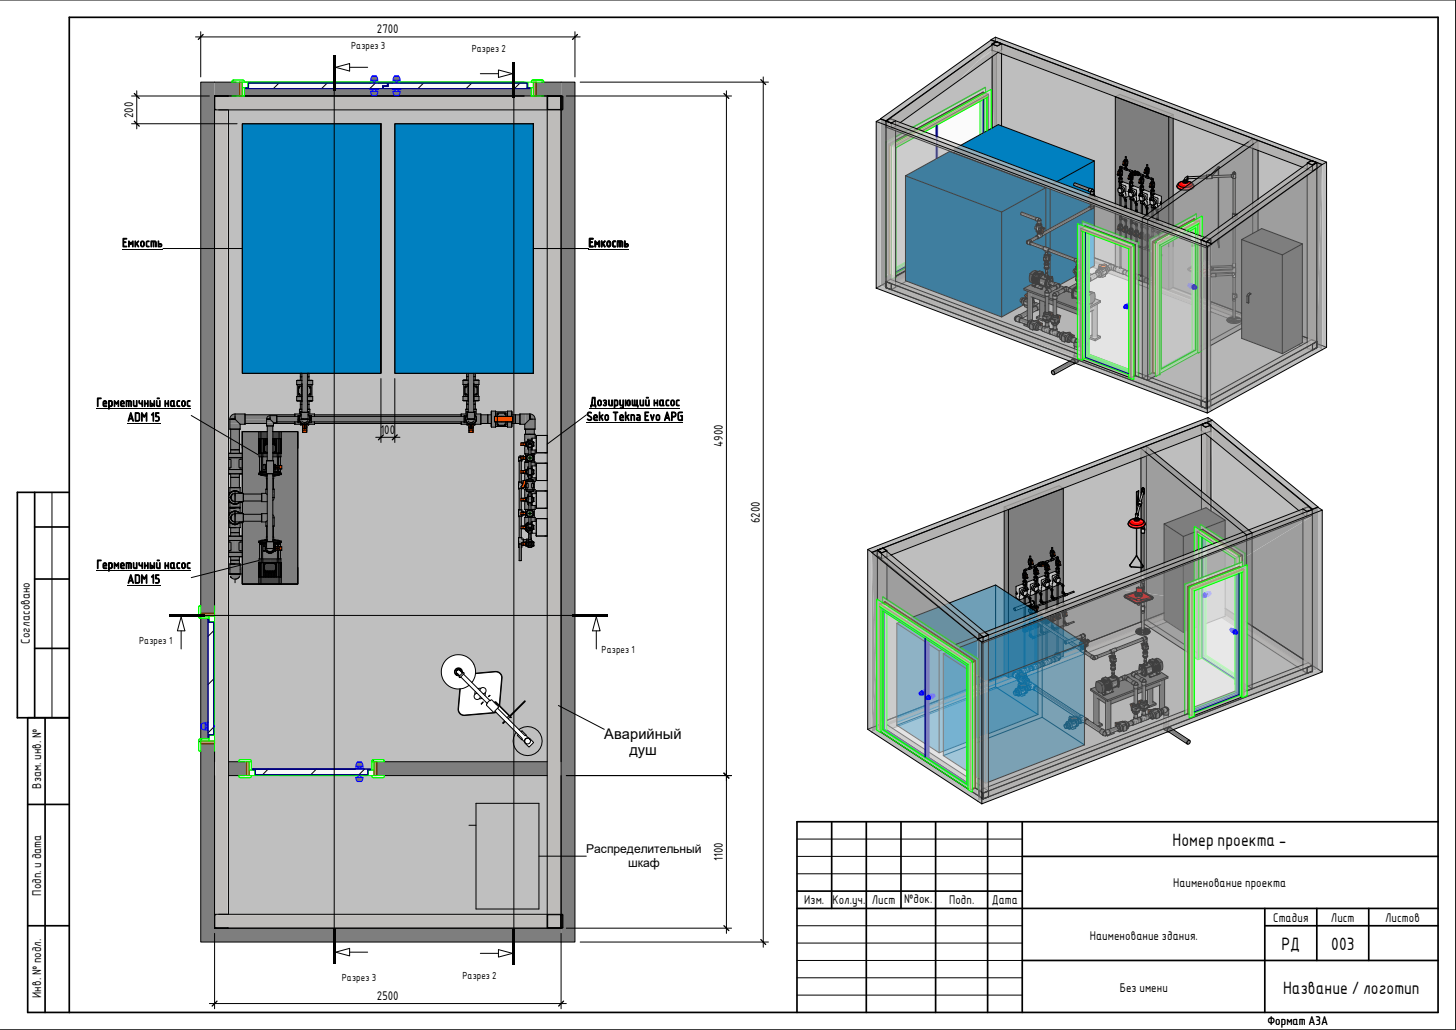
[picture p79: page 2]
Разрез 1 Разрез 1; Разрез 2; Разрез 2 Разрез 3; Разрез 3; Емкость; Аварийный душ; Герметичный насос ADM 15; Распределительный шкаф; Изм. Кол.уч. Лист №док.; Подп.; Дата; Стадия; Лист; Листов; Согласовано; Инв. № подл; Название / логотип; Формат А3А; Номер проекта -; Наименование проекта; Наименование здания.; Без имени

Дозирующий насос
Seko Tekna Evo APG

. Подп. и дата Взам. инв.

Разрез 1-1 | Разрез 2-2

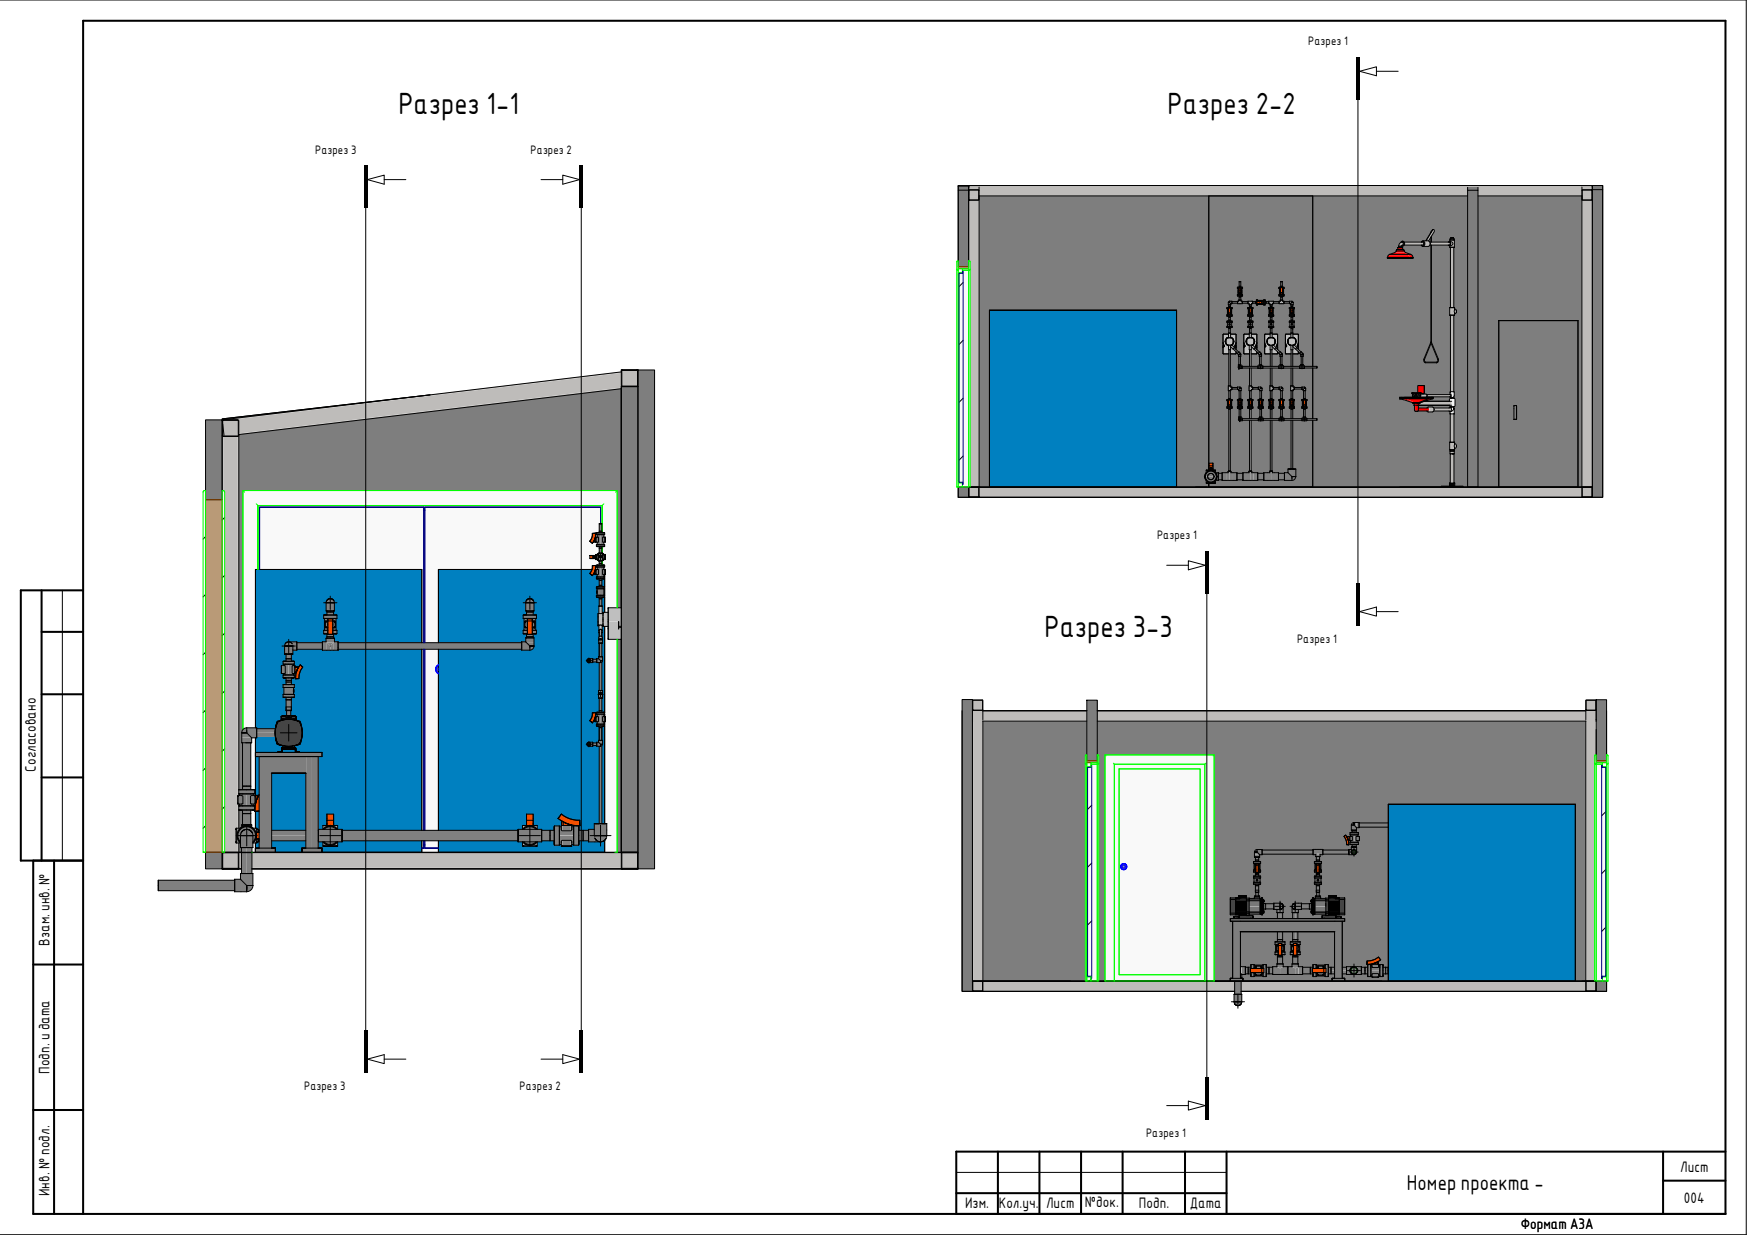
[picture p80: page 3]
Разрез 2; Разрез 3; Разрез 1; Согласовано; Инв. № подл; Формат А3А; Изм. Кол.уч. Лист №док.; Подп.; Дата; Лист; Номер проекта -; Разрез 3-3

. Подп. и дата Взам. инв.
