bigstrongbeast/GnG_Gantul_hill/ref/ГГ Model (1).pdf

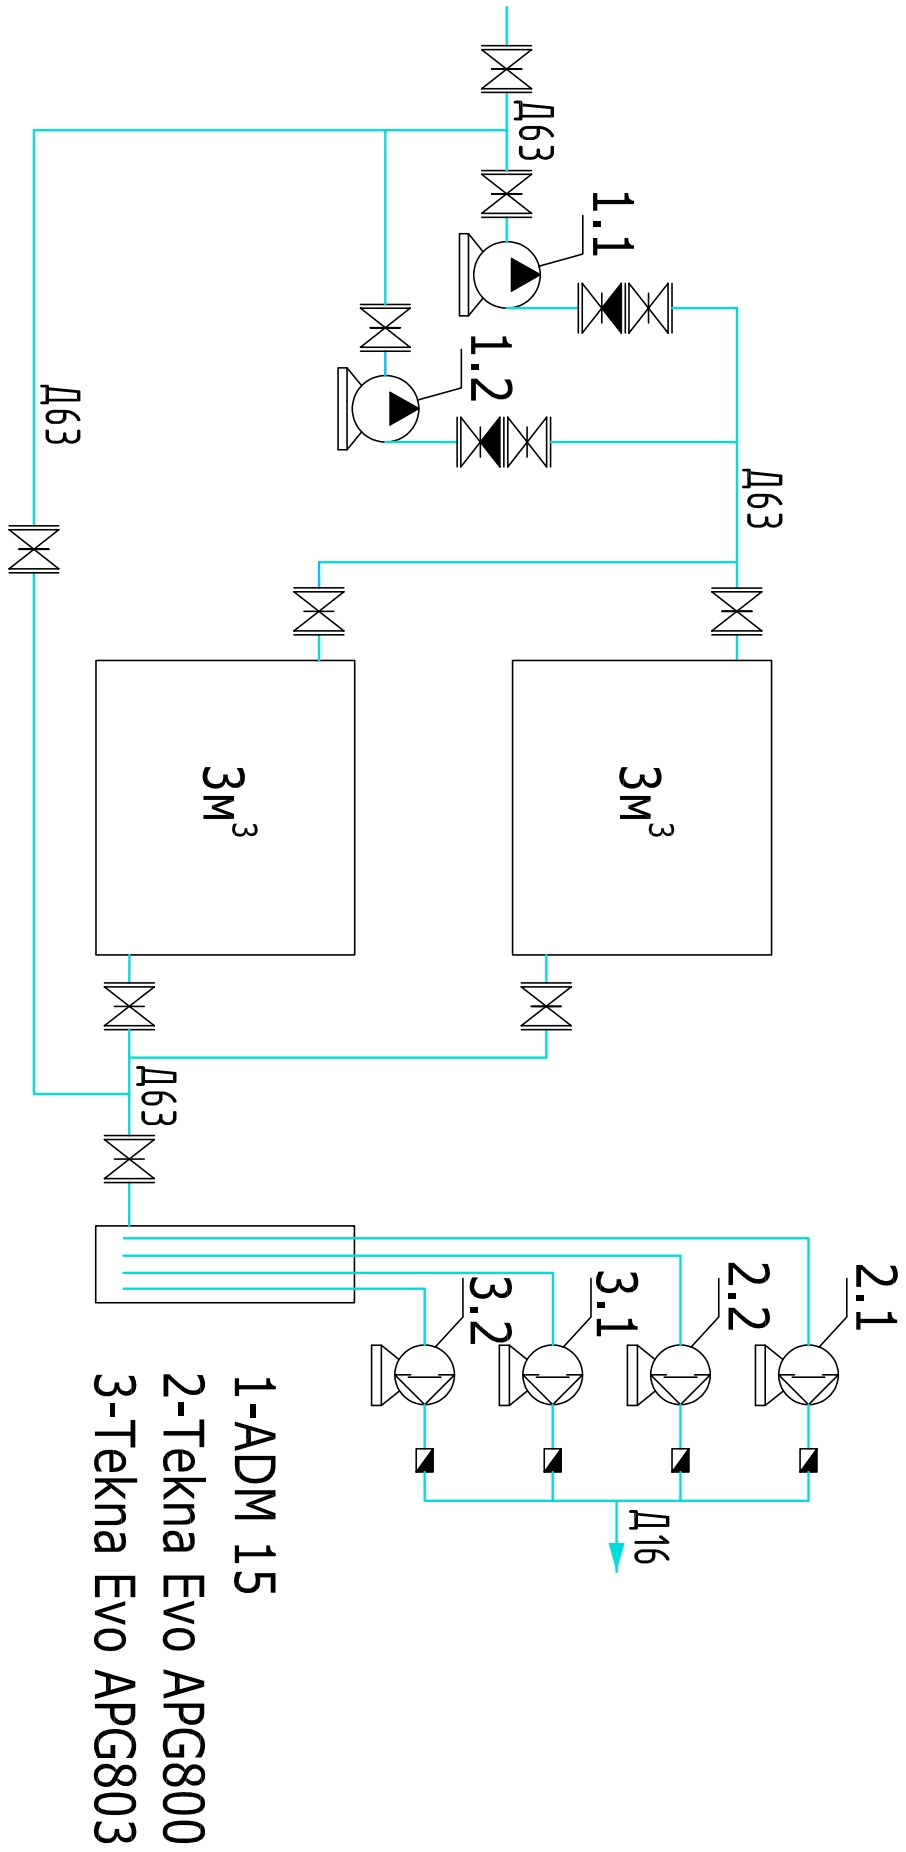
[picture p81: page 1]
