bigstrongbeast/GnG_Gantul_hill/Чертежи/Для Ильи/ТХ_Гантуловская гора 10.12.25 - Лист - 002 - Без имени.pdf

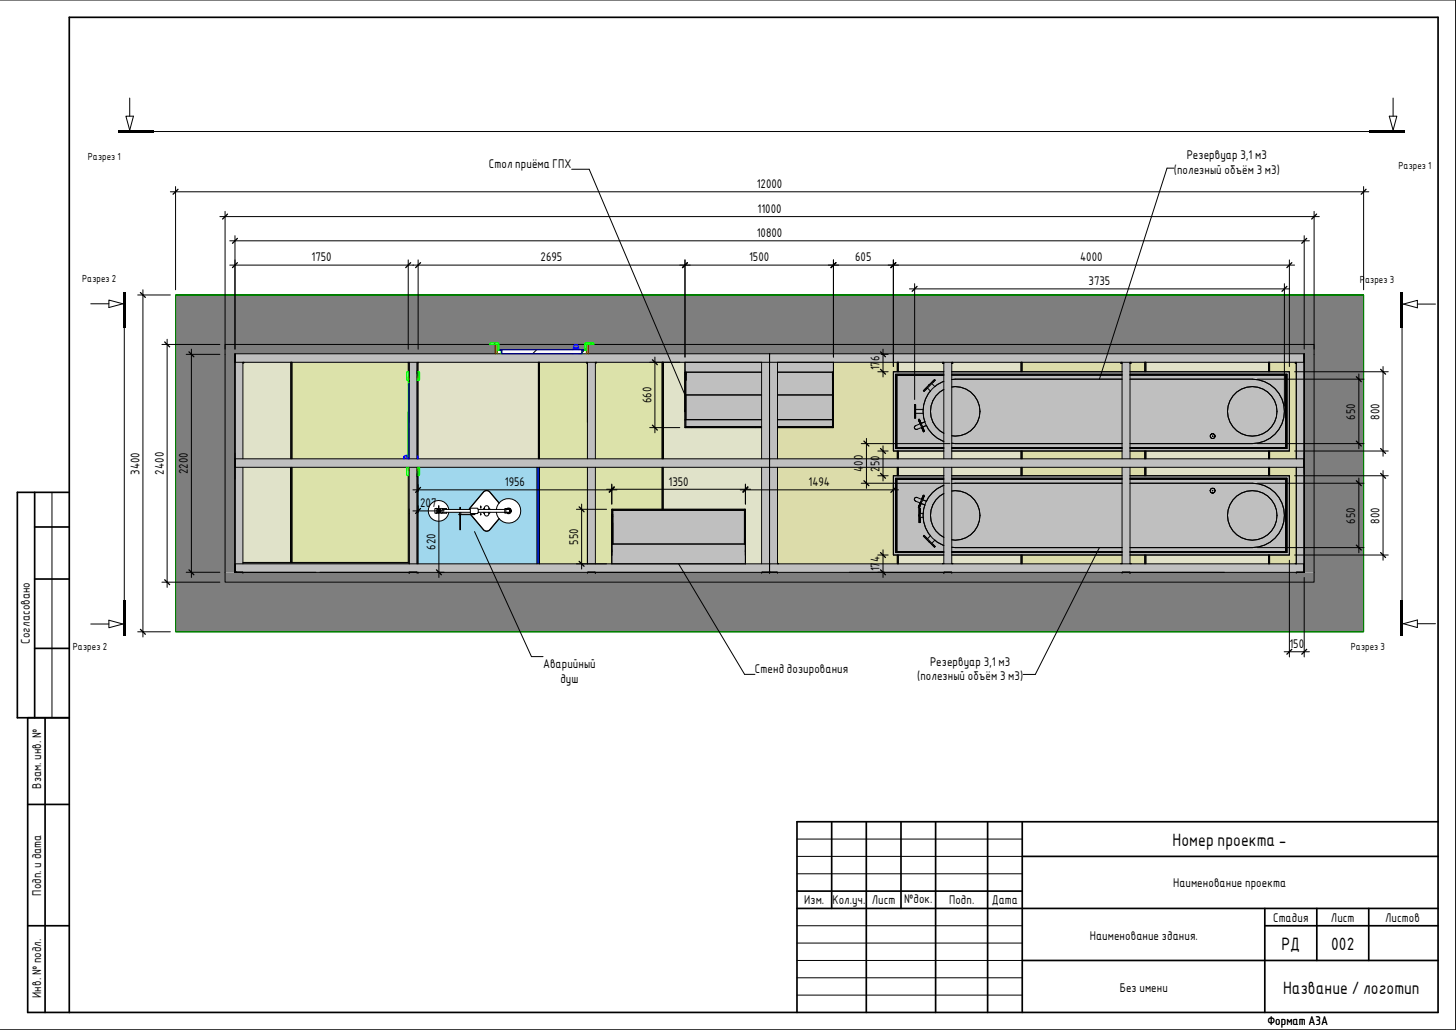
[picture p82: page 1]
Аварийный душ; Резервуар 3,1 м3 (полезный объём 3 м3); Стенд дозирования; Разрез 1 Разрез 1; Разрез 2; Разрез 3; Согласовано; Инв. № подл; Формат А3А

Стол приёма ГПХ

. Подп. и дата Взам. инв.

Номер проекта -

Наименование проекта

Изм. | Кол.уч. | Лист | №док. | Подп. | Дата

Наименование здания. | Стадия | Лист | Листов
РД | 002

Без имени | Название / логотип
