bigstrongbeast/GnG_Gantul_hill/Чертежи/Для Ильи/ТХ_Гантуловская гора 10.12.25 - Лист - 004 - Без имени.pdf

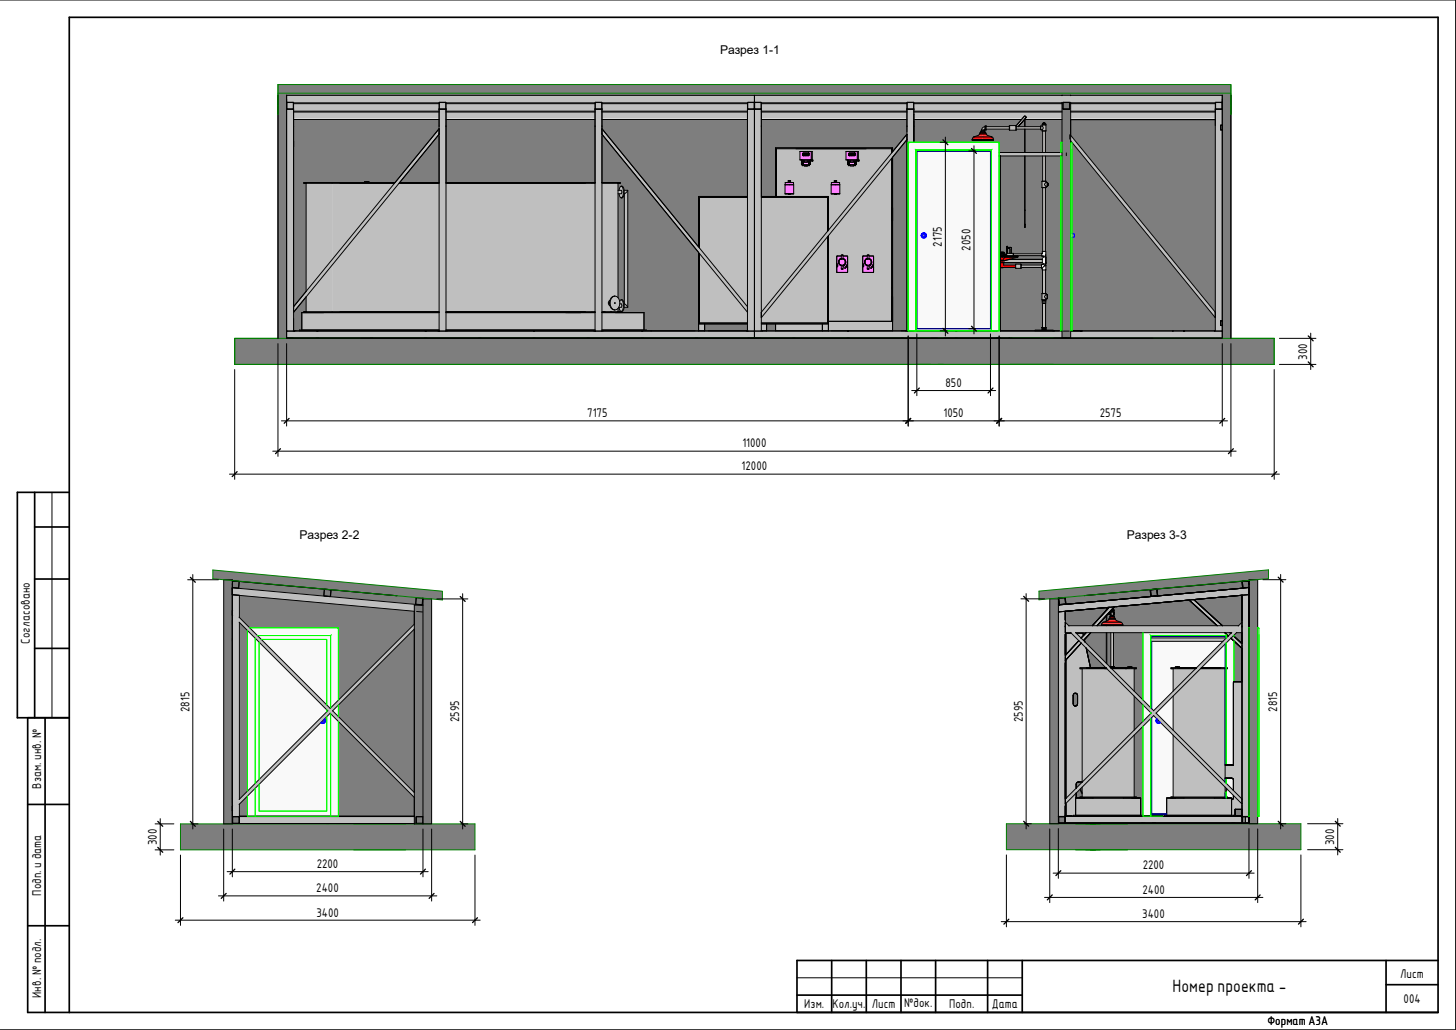
[picture p83: page 1]
Согласовано; Формат А3А; Изм. Кол.уч. Лист №док.; Подп.; Дата; Лист; Номер проекта; Разрез 1-1; Разрез 2-2; Разрез 3-3

Инв. № подл. Подп. и дата Взам. инв. №
