bigstrongbeast/GnG_Gantul_hill/(commit log)

2025-09-20 семейства насосов
    [AST GnG frame.iam, ASY GnG station.iam, GnG frame.ipt]
2025-09-20 начало рамы в инв
    [AST GnG frame.iam, ASY GnG station.iam, Frame 1758357581306.iam, GnG floor sheet 1.ipt, ISO 10799-2 100x100x3 1758357583030.ipt, ISO 10799-2 100x100x3 1758357583062.ipt, ISO 10799-2 100x100x3 1758357583095.ipt, ISO 10799-2 100x100x3 1758357583128.ipt]
2025-09-21 Глеб
    Начало работы. Сделал чертежи
2025-09-22 сделать двери виды с размерами
2025-09-22 Глеб
    Сделал том для заказчика
2025-09-23 Глеб
    Развязал трубы по тех. схеме
2025-09-25 TOO MPRE NEW
    [ADM15.ipt, ADM15.step, AST GnG frame.0005.iam, AST GnG frame.iam, AST GnG frame_Simplify_1.ipt, ASY GnG station.iam, DRW GNG НаOCl tank.0007.idw, DRW GNG НаOCl tank.0008.idw]
2025-09-26 Глеб
    Выполнил задания от 26.09.25
2025-09-30 Глеб
    Рисую развязку
    [ADM15.step]
2025-10-01 Глеб
    Дорисовал Гору
2025-10-02 Глеб
2025-10-14 Новые рамы. корректировки в рефах
    [AST GnG frame.iam, ASY GnG frame 1.iam, ASY GnG station.iam, Frame 1758357581306.iam, Frame 1760437627605.iam, GnG frame.ipt, ISO 10799-2 100x100x3 1760436526769.ipt, ISO 10799-2 100x100x3 1760437628511.ipt]
2025-10-14 Глеб
    Внес изменения в Ревит модель по замечаниям
2025-10-16 Глеб
    Редактирую разводку по новой схеме
2025-10-19 новая рама
    [ASY GnG frame 1.iam, ASY GnG station.iam, Frame 1760437627605.iam, GnG frame.ipt, ISO 10799-2 80x40x3 1760687052574.ipt, ISO 10799-2 80x80x3 1760695196892.ipt, ISO 10799-2 80x80x3 1760695206994.ipt, ISO 10799-2 80x80x3 1760695216389.ipt]
2025-10-19 рама под жилую часть
    [AST GnG frame.iam, ASY GnG frame 1.iam, ASY GnG frame 2.iam, ASY GnG station.iam, Frame 1760437627605.iam, Frame 1760870485440.iam, GnG frame 2 sketch.ipt, ISO 10799-2 40x20x2 1760871003136.ipt]
2025-10-19 Глеб
    Редактирую разводку
    [ADM15.ipt]
2025-10-20 Глеб
    Почти дорисовал новую разводку
2025-10-21 Глеб
    Доделал разводку
2025-10-29 полы с листами сэндвич жилая рама
    [ADM10.ipt, ASY GnG frame 1.1.iam, ASY GnG frame 1.1.idw, ASY GnG frame 2.iam, ASY GnG station.0016.iam, ASY GnG station.iam, DRW GNG Frame.idw, Frame 1760870485440.iam]
2025-10-29 докоммит
    [ASY GnG frame 1.1.iam, ASY GnG frame 2.iam, ASY GnG station.iam, DRW GNG Frame.idw, Frame 1760870485440.iam, Frame 1760970953553.iam, GnG frame 1 sketch.ipt, GnG frame 2 sketch.ipt]
2025-10-30 додокоммит
    [ASY GnG station.iam]
2025-11-06 Глеб
    Редактирую ТХ
2025-11-07 чиню гит.
    [ASY GnG frame 1.1.0026.iam, ASY GnG frame 1.1.0027.iam, ASY GnG frame 1.1.0028.iam, ASY GnG frame 1.1.iam, ASY GnG frame 2.0022.iam, ASY GnG frame 2.0023.iam, ASY GnG frame 2.iam, ASY GnG station.iam]
2025-11-07 Вроде починил. Добавил плиту
    [ASY GnG frame 2.0022.iam, ASY GnG frame 2.0023.iam, ASY GnG frame 2.iam, ASY GnG station.0016.iam, ASY GnG station.iam, DRW GNG Frame.idw, GnG foundation.ipt]
2025-11-08 Глеб
    Сделал пол и фундамент
2025-11-09 Глеб
    Добавил раму
2025-11-09 Auto stash before merge of "main" and "origin/main"
    [ASY GnG frame 1.1.0026.iam, ASY GnG frame 1.1.0027.iam, ASY GnG frame 1.1.0028.iam, ASY GnG frame 1.1.iam, ASY GnG frame 1.1.idw, ASY GnG frame 2.iam, ASY GnG station.iam]
2025-11-11 подвод электрики через плиту
    [DRW GNG Frame.idw, GnG foundation.ipt]
2025-11-11 добавить системы
    [Стенды.dwg]
2025-11-12 Глеб
    Создал системы
    [ТХ_схема Гантуловская гора 12.11.25.dwg]
2025-11-13 Глеб
    Рисую схему ТХ
    [ТХ_схема Гантуловская гора 13.11.25.dwg]
2025-11-15 раскидываем системы
2025-11-15 Глеб
    Раскидываю системы
2025-11-16 Глеб
    Продолжаю войну с системами
    [ТХ_схема Гантуловская гора 13.11.25.dwg, ТХ_схема Гантуловская гора 16.11.25.dwg]
2025-11-17 Глеб
    Почти дорисовал
    [ТХ_схема Гантуловская гора 16.11.25.dwg]
2025-11-18 Глеб
    Дорисовал схему
    [ТХ_схема Гантуловская гора 16.11.25.dwg, ТХ_схема Гантуловская гора 18.11.25.dwg]
2025-11-19 недокоммит
    [GnG frame 1 sketch.0007.ipt, GnG frame 1 sketch.0008.ipt, GnG frame 2 sketch.0013.ipt, GnG frame 2 sketch.0014.ipt]
2025-11-19 Глеб
    Трассирую по новому трубы
    [Стенд.ipt]
2025-11-19 Глеб
    Доп. загрузка
2025-11-23 Глеб
    Переделал разводку труб
2025-11-24 Глеб
    Работаю
2025-11-26 Глеб
    Воюю с электрикой
2025-11-27 Глеб
    Лед тронулся
2025-11-29 Глеб
    Развел освещение, добавил лотки. Продолжаю изучать тему
2025-11-30 Глеб
    Развел освещение правильно. Частично развел розетки. Вытащил примерную СО
2025-12-01 Глеб
    Вставил стенд приема, развел трубы
    [Стол приёма ГПХ.dwg, Стол приёма ГПХ.ipt]
2025-12-02 Глеб
    Настроил мониторинг оборудования из связанного проекта
2025-12-03 Глеб
    Забил электрические АДСК параметры в автоматические краны и насосы
2025-12-08 Глеб
    Снова работаю
2025-12-10 Глеб
    Развел электрику
2025-12-15 Глеб
    Сделал чертежи для Ильи
2026-01-20 какие-то изменения
    [ASY GnG frame 1.1.iam, ASY GnG frame 2.iam, ASY GnG station.iam, GnG frame 4.1 D-ring.dxf, GnG frame 4.1 D-ring.ipt, GnG frame 4.2 reinf.dxf, GnG frame 4.2 reinf.ipt]
